omacharya1710/Model_Rocketry_Project_IIT_Tirupati/External_Components/Kill_Switch/Kill Switch.png

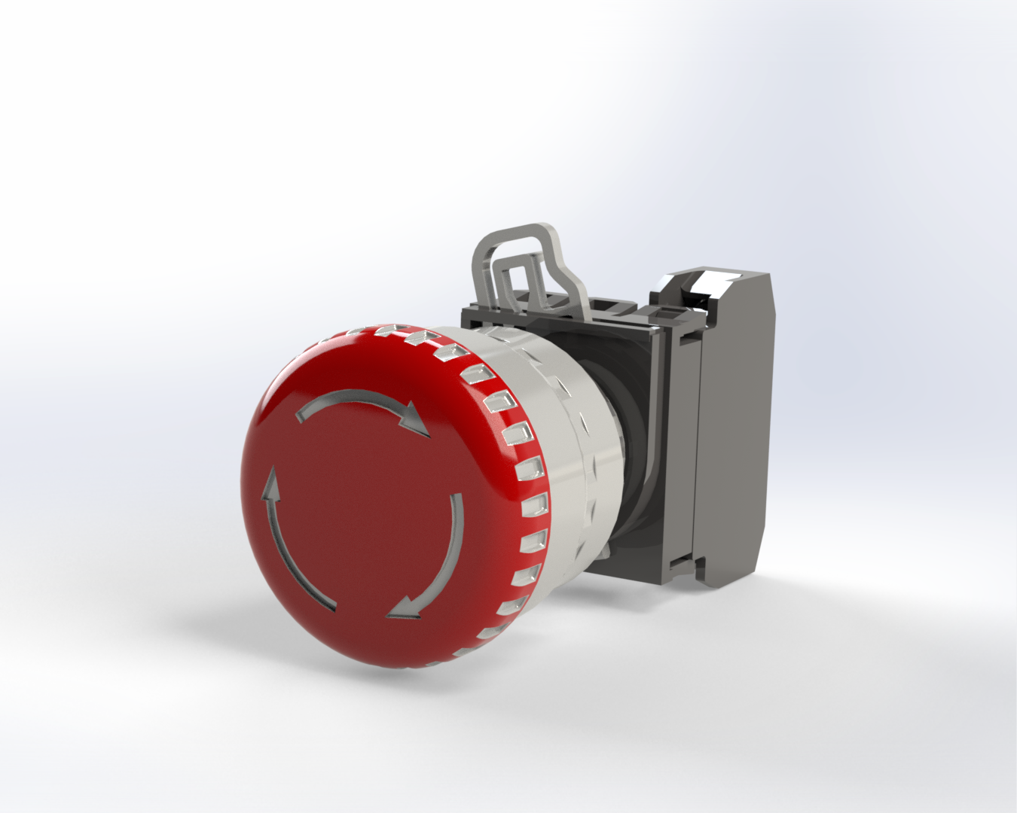
External_Components/Kill_Switch/Kill Switch.png
