omacharya1710/Model_Rocketry_Project_IIT_Tirupati/Photos/20250520_103055000_iOS.jpg

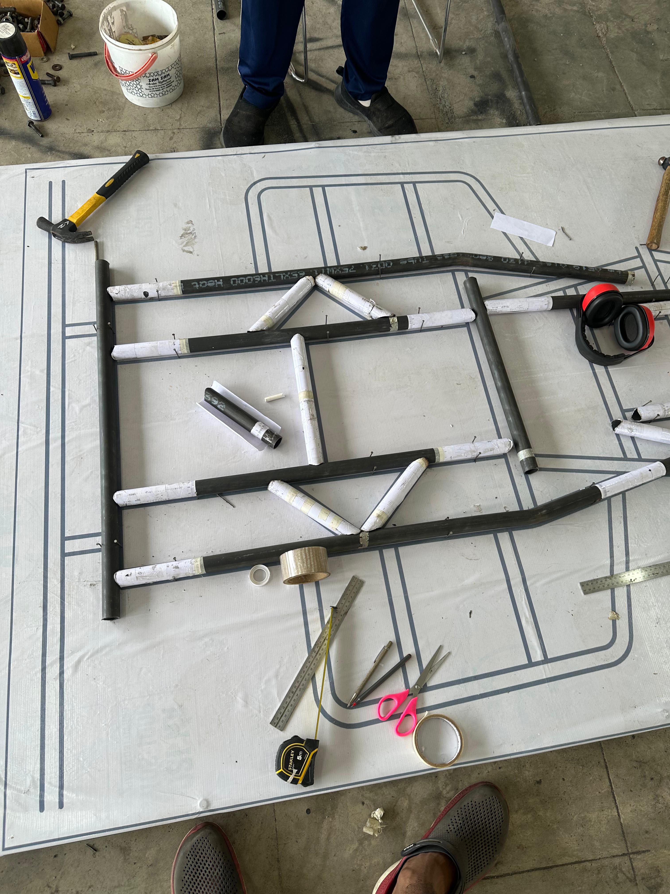
Photos/20250520_103055000_iOS.jpg
