omacharya1710/Model_Rocketry_Project_IIT_Tirupati/Reports/braking_report.pdf

# Braking System Design Report

I. RULEBOOK CONSTRAINTS
According to the IKR 2025 rulebook:
- Karts must have a hydraulic braking system.
- On applying brakes, all four wheels should lock up.
- The kart must safely stop after accelerating at least up to 25 km/h during the brake test.
- The tire specification to be followed is in the following table:
| Type | Category | Dimension
Dry (slick) tires Wet tires Dry (slick) tires Wet tires | Front Front Rear Rear | D1 W1 or W2 D1 W1 or W2 | 4.5×10.0-5 4.5×10.0-5 7.1×11.0-5 6.0×11.0-5

TABLE I: Tire specifications

II. FORCE CONSIDERATION
- Maximum foot force applied by driver: 250 N
- Pedal mechanical advantage: 5.5
Effective force transmitted to master cylinder:

FMC = Ffoot × MA = 250 × 5.5 = 1375 N

III. WORKING PRINCIPLE
The brake pedal, using a mechanical linkage, actuates the clutch master cylinder:
The rear braking circuit operates one caliper on the rear axle.
When the pedal is pressed, hydraulic pressure develops inside master cylinder actuates the caliper piston, pressing the brake pads against the rotating discs to generate braking torque.

IV. DESIGN CONSIDERATIONS
Key aspects considered during design:
- Sufficient hydraulic pressure generation within safe limits.
- Adequate braking torque to decelerate from 40 km/h.
- Avoidance of component failure under maximum force.
V. COMPONENT SELECTION

TABLE II: Selected Components and Specifications

Component | Specification
Master Cylinder | 21.9 mm Bore (x1 units)
Rear Caliper | 32 mm Bore (x1 unit)
Rear Brake Disc | 130 mm ID, 200 mm OD
Rear Tyre Diameter | 279.4 mm
Rear Brake Pad Area | 1800 mm²
Pedal Mechanical Advantage | 5.5

VI. PICTURES OF DESIGN AND COMPONENTS

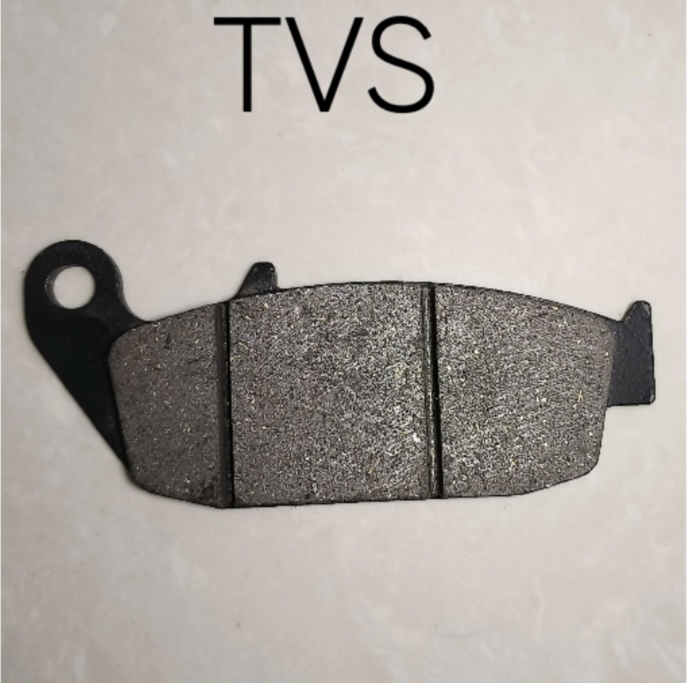
[picture p3: figure]

Fig. 1: Images of Brake pad

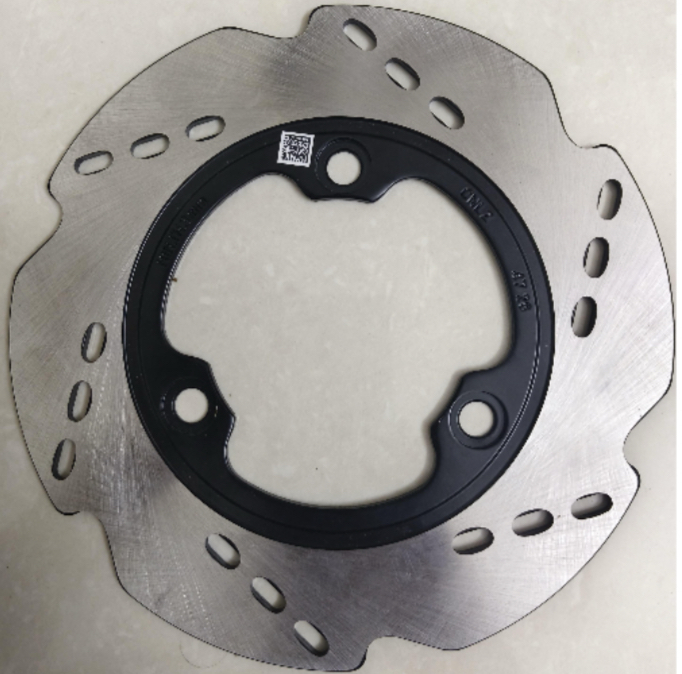
[picture p4: figure]

Fig. 2: Images of Brake disc

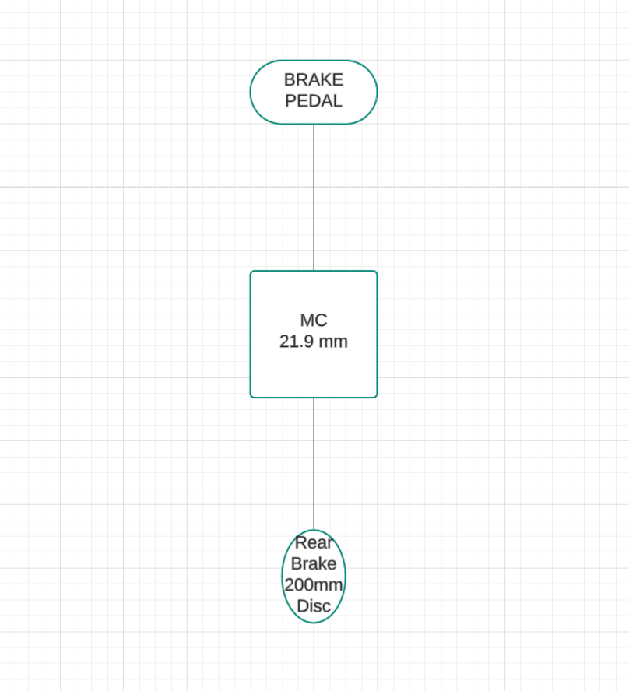
[picture p5: figure]

Fig. 3: FLOW CHART

VII. PART ANALYSIS
Currently, no finite element analysis (FEA) is conducted on brake discs or pedal arms. Static load analysis and thermal analysis are planned in future work.

VIII. FORMULATION AND CALCULATIONS
A. Master Cylinder Area
Bore diameter of master cylinder, DMC = 21.9 mm = 0.0219 m
Radius:

rMC =

DMC
2

= 0.01095 m

Area:
AMC = πr²

MC = π(0.01095)² = 3.769 × 10⁻⁴ m²

B. Hydraulic Pressure
Effective force on master cylinder:

FMC = 1375 N

Hydraulic Pressure generated:

P =

FMC
AMC

=

1375
3.769 × 10⁻⁴
= 3.65 × 10⁶ Pa = 3.65 MPa
C. Caliper Piston Forces
Rear Caliper (Bore 32 mm):
Radius:

rRear−Caliper = 16 mm = 0.016 m

Area:
ARear−Caliper = π(0.016)² = 8.042 × 10⁻⁴ m²

Force:
FRear−Caliper = 3.65×10⁶×8.042×10⁻⁴ = 2935.3 N
D. Braking Torque Generation Disc effective radii:
Rear Disc:

rdisc−rear =

130 + 200
4

= 82.5 mm = 0.0825 m

Frictional Force between pad and disc: Coefficient of friction µpad−disc = 0.35
Rear:

FF riction−Rear = 0.35 × 2935.3 = 1027.36 N

Braking Torque:
Rear Torque (each wheel):

TRear = FF riction−Rear×rdisc−rear = 1027.36×0.0825 = 84.75 Nm

E. Total Braking Force
Front wheel radius = 0.127 m Rear wheel radius =
0.1397 m
Force at tyre contact patch:
Rear:

FRear−T yre =

84.75
0.1397

= 606.7 N

Total Braking Force:

FT otal−Braking = FRear−T yre = 606.7 N

F. Stopping Distance and Time Calculation Initial Speed:

v = 40 km/h = 11.11 m/s

Mass of kart:
m = 180 kg

Deceleration:

a =

FT otal−Braking
m

=

606.7
180

= 3.3705 m/s²

Braking time:

tbraking =

v
a

=

11.11
3.3705

= 3.296 s

Braking distance:

dbraking =

v

2
2a

=

(11.11)²
2 × 3.3705

= 18.31 m

G. Stopping Distance During Reaction Time
Here, we calculate the distance traveled during the driver’s reaction time, considering deceleration due to tyre-road friction.

d = v × t +

1
2

at²

Where:
- v = 11.11 m/s is the initial velocity.
- t = 0.5 s is the reaction time.
- a = −µ × g = −0.7 × 9.81 = −6.867 m/s² is
the deceleration, where µ = 0.7 is the coefficient of friction between tyre and road.
Substituting the values:

d = 11.11 × 0.5 +

1
2

× (−6.867) × (0.5)²

Simplifying:

d = 5.555 − 0.858 = 4.697 meters

Thus, the distance traveled during the reaction time is approximately 4.70 meters. Total stopping distance:

dtotal = dbraking+dreaction = 18.31+4.697 = 23.007 m

IX. TABULATIONS

TABLE III: Braking Parameters Summary

Parameter | Value
Stopping Distance | 23.007 meters
Stopping Time | 3.796 seconds
Driver Foot Force | 250 N
Force at Master Cylinder | 1375 N
Hydraulic Pressure | 3.65 MPa
Total Braking Force | 606.7 N
X. RESULTS
- Total Stopping Distance: 23.007 meters
- Total Stopping Time: 3.796 seconds (including reaction time)
- Hydraulic pressure generated: 3.65 MPa
- Driver effort required: 250 N
- The above calculations were also done for wet conditions, and considering wet tires, the results are tabulated in Table IV.

TABLE IV: Results for Wet Conditions

Parameter | Value
Initial Velocity | 11.11 m/s (40 km/h)
Coefficient of Friction (Wet) | 0.3
Deceleration | 2.943 m/s²
Reaction Time | 0.5 seconds
Reaction Distance | 4.697 meters
Braking Time | 3.77 seconds
Braking Distance | 20.97 meters
Total Stopping Time | 4.27 seconds
Total Stopping Distance | 25.667 meters

XI. RESULTS
The braking system meets the safety requirements even under a worst-case scenario of braking from 40 km/h. Hydraulic pressures and forces are within component limits. Stopping distance and stopping time are within safe ranges, ensuring reliability of the system.
