omacharya1710/Model_Rocketry_Project_IIT_Tirupati/Reports/cover_page.pdf

# Go-Kart Design Report

Abstract—This document presents a comprehensive design and analysis of a go-kart, encompassing the chassis, steering, braking, transmission, and electrical wiring systems. The chassis was developed with strict adherence to competition rulebook constraints and dimensional standards, ensuring compliance while maximizing structural performance. Material selection focused on achieving an optimal balance between strength, weight, and cost, supported by iterative finite element analysis (FEA) simulations to validate the chassis’ structural integrity under dynamic loading conditions. The steering system design prioritizes precise handling, cornering stability, and safety, achieved through the implementation of an Ackermann steering geometry that minimizes tire scrubbing and reduces steering effort. Emphasis was placed on promoting self-centering behavior, improving maneuverability, and selecting simple yet robust materials to ensure reliability and cost-effectiveness. The braking system features a custom-designed hydraulic configuration utilizing two independent clutch master cylinders linked to a single pedal, providing mechanical advantage and redundancy. Although standard brake testing is performed from 25 km/h as per Indian Karting Race (IKR) regulations, a more conservative scenario at 40 km/h was analyzed to ensure enhanced safety margins. Detailed calculations for hydraulic pressures, braking forces, torque requirements, stopping distances, and pedal efforts were conducted to validate performance. The transmission system, comprising a chaindriven mechanism from the engine output shaft to the rear axle, was optimized for torque delivery and efficiency, with gear ratio selection aimed at achieving the desired balance between acceleration and top speed. This paper presents the design and implementation of a minimal yet competition-compliant electrical wiring system for a student-built go-kart. The setup includes essential safety and operational features such as Brake Over-Travel Switch (BOTS), multiple kill switches, and an adaptive brake lighting system. Furthermore, an innovative pneumatic gear shifting mechanism controlled by a Raspberry Pi is integrated, offering multiple shifting modes including manual handle shifting, paddle shifting with and without clutch, and automatic speed-based shifting. The report outlines the rulebook constraints, design considerations, circuit diagram, power calculations, and results.
Index Terms—Go-Kart, Chassis Design, Braking System, Transmission, Steering, Electrical Wiring, Lightweight Vehicles, Systems Engineering
I. INTRODUCTION

This document presents a comprehensive design and analysis of a go-kart, encompassing the chassis, steering, braking, transmission, and electrical wiring systems.
The transmission system is a critical component responsible for transferring power from the engine to the rear wheels while enabling variation in torque and speed to match different driving conditions. A

5-speed constant mesh manual transmission from the TVS Apache RTR 160 2V motorcycle was integrated into the go-kart due to its compact design, proven reliability, and smooth gear transitions. Its inclusion ensures improved vehicle control, efficient power delivery, and optimal performance under dynamic racing conditions.
The steering system plays a crucial role in the maneuverability and handling of the go-kart, enabling precise navigation through tight corners and maintaining driver control. An Ackermann steering geometry was implemented to ensure that each wheel follows its ideal turning radius, minimizing tire scrubbing and enhancing cornering efficiency. The design also emphasizes self-centering behavior, reduced steering effort, and simplicity to maximize reliability and ease of maintenance.
The braking system is critical for the dynamic performance and safety of the kart. Although the Indian Karting Race (IKR) rulebook requires braking from 25 km/h, a more conservative design approach was adopted by analyzing braking forces and stopping distance from 40 km/h to ensure higher safety margins. A dual hydraulic circuit system with mechanical pedal linkage was used, providing redundancy and efficient deceleration under various conditions.
The chassis serves as the fundamental structural framework of the go-kart, bearing all system loads and providing protection to the driver. Designed in compliance with rulebook constraints regarding dimensions, roll hoop requirements, and bumper design, the chassis was iteratively refined using finite element analysis (FEA) simulations under front, rear, and side impact scenarios. Material selection focused on achieving an optimal balance between strength, weight, and cost, leading to the use of AISI 4130 steel for critical frame members.
Student motorsports competitions mandate strict compliance with safety and reliability standards. Electrical systems, although minimal in combustion engine go-karts, play a crucial role in ensuring driver safety and operational control. This report details the electrical wiring layout, accessories, and the integration of a Raspberry Pi-based pneumatic shifting system, developed to enhance shifting efficiency and vehicle performance for the innovation round.
The integration of all these subsystems was carried out with an emphasis on manufacturability, reliability, safety, and dynamic performance, resulting in a competitive and robust go-kart platform suitable for racing applications.
