omacharya1710/Model_Rocketry_Project_IIT_Tirupati/Reports/electrical_report.pdf

# Wiring Diagram and Accessories Design Report

I. RULEBOOK CONSTRAINTS

As per competition regulations:

- A Brake Over-Travel Switch (BOTS) must be installed on the brake pedal.
- Three Kill Switches are mandatory (one driver-accessible, two externally mounted).
- Brake light must remain ON (dim) when powered and become brighter when braking.
- Any additional system must not compromise safety standards.

II. DESIGN CONSIDERATIONS

The vehicle’s electrical architecture was kept minimal to reduce weight and complexity while meeting all required standards:

- BOTS installed directly on the brake pedal linkage.
- Kill switches wired in series to allow immediate engine shutdown.
- Brake light configured using a dual-intensity circuit.
- Pneumatic gear shifting operated using a 12V car air compressor and solenoid valves, managed via Raspberry Pi.
- Fail-safe mechanisms embedded for manual shifting in case of automatic system failure.

III. CIRCUIT DESIGN

The basic electrical circuit includes:

- 12V Battery as power source
- Series wiring of BOTS and Kill Switches
- Brake light dual intensity connection
- Relayed control of compressor and solenoids

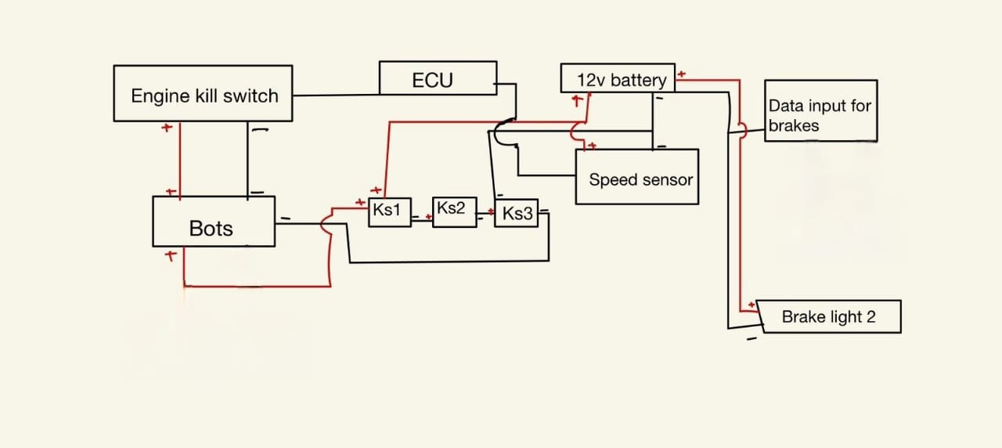
[picture p6: figure]

Fig. 1. Go-Kart Electrical Wiring Diagram

TABLE I
COMPONENTS USED
Component | Specification
Brake Light BOTS Kill Switches Display Wiring Harness | Dual Intensity LED Push Button NO Switch Mechanical Emergency Stops ECU Display Unit Automotive Grade

IV. COMPONENTS AND ASSEMBLY

V. SIMULATION
Since the system primarily involves hardware wiring and low-level electronics, no software simulation was conducted. Practical bench testing and continuity checks were performed to validate the circuit.

VI. RESULTS
- Brake Light: Functional dual intensity
- Kill Switches: Effective shutdown
- Pneumatic Shifting: Working via Raspberry Pi

VII. CONCLUSION
The developed electrical system fulfills all regulatory requirements while incorporating innovative features for enhanced driver experience. The pneumatic shifting system controlled by Raspberry Pi adds to vehicle control and responsiveness, making the kart suitable for advanced competition rounds while maintaining high safety standards.
