omacharya1710/Model_Rocketry_Project_IIT_Tirupati/Reports/references.pdf

# References

REFERENCES
1) Design of Subsystems of Go-Kart Vehicle, ResearchGate (https://www.researchgate.net/publication/322750106_Design_of_subsystems_of_Go-kart_vehicle)
2) Fundamentals of Vehicle Dynamics, Thomas D. Gillespie (https://www.amazon.com/Fundamentals-Vehicle-Dynamics-Thomas-Gillespie/dp/1560911999)
3) Design and Analysis of Go-Kart Chassis Frame, JETIR (https://www.jetir.org/papers/JETIR18IC052.pdf)
4) Design and Development of Go-Kart Chassis, IJIRT (https://ijirt.org/publishedpaper/IJIRT148120_PAPER.pdf)
5) Design and Development of a Go-Kart Frame, IOP Conference Series (https://iopscience.iop.org/article/10.1088/1757-899X/981/4/042026)
6) Design and Fabrication of Transmission System for Go-Kart, IJSTE (https://ijste.org/Article.php?manuscript=IJSTEV4I8027)
7) Design of Transmission System for Go-Kart Vehicle, ResearchGate (https://www.researchgate.net/publication/334317267_Design_of_Transmission_System_for_Go-Kart_Vehicle)
8) Design and Analysis of a Go-Kart Chassis Frame, ScienceDirect, Procedia Manufacturing (https://www.sciencedirect.com/science/article/pii/S2214785320349695)
9) AISI 4130 Alloy Steel (UNS G41300) Material Properties, AZoM (https://www.azom.com/article.aspx?ArticleID=6742)
10) Design of Go-Kart Chassis, International Journal of Automotive and Mechanical Engineering (https://www.ijamejournals.com/pdf/rps161152.pdf)
11) Dynamic Analysis and Optimization of a Go-Kart Chassis Frame, ScienceDirect, Procedia Manufacturing (https://www.sciencedirect.com/science/article/pii/S2214785320360867)
12) Apache RTR 160 2V Owner’s Manual, TVS Motor Company (https://www.tvsmotor.com/-/media/Feature/Owners/User-Manual-11-Apr-22/TVS-Apache-RTR-160-2V.pdf)
13) Go-Kart Chassis Design and Analysis, IJRITCC (https://ijritcc.org/download/conferences/ICEMTE_2017/Track_3_(MECH)/1488271356_28-02-2017.pdf)
14) Go-Kart Steering and Suspension System Design, IJSRD (https://www.ijsrd.com/articles/IJSRDV7I40960.pdf)
15) Self Aligning Torque Formula, FormulaDen (https://www.formuladen.com/en/self-aligning-moment-or-torque-on-wheels-formula/Formula-36979)
16) Steering Ratio, Wikipedia (https://en.wikipedia.org/wiki/Steering_ratio)
17) Go-Kart Front Wheel Alignment Guide, Kart-Class (https://kartclass.com/blogs/news/a-step-by-step-guide-on-go-kart-front-alignment)
18) Vehicle Dynamics: Theory and Application, eBook (https://ftp.idu.ac.id/wp-content/uploads/ebook/tdg/TERRAMECHANICS%20AND%20MOBILITY/epdf.pub_vehicle-dynamics-theory-and-application.pdf)
19) PSG Design Data Book, Standard Handbook for Mechanical Design (offline source)
20) Raspberry Pi 4 Model B Datasheet
21) Basic Automotive Electrical Standards (ISO 16750)
