omacharya1710/Model_Rocketry_Project_IIT_Tirupati/Reports/steering_reports.pdf

# Steering System Design Report

I. RULEBOOK CONSTRAINTS
- Mechanical steering mechanism.
- All parts are metallic, except for the wheel.
- Steering angle constrained to the degree of rotation 30◦
- The steering wheel must be circular or elliptical, with a diameter between 8 and 10 inches.
- The rack and pinion system must not be used.

II. STEERING GEOMETRY

- The steering system is designed on the basis of the Ackermann steering principle to optimize wheel alignment during turns.
- The inner and outer wheels rotate at different angles, reducing tire scrubbing and improving maneuverability.
- The setup ensures smooth and predictable handling, providing better traction, and minimizing lateral forces on the tires.
- Specific steering angles are incorporated to enhance self-centering behavior and driver control.
- The kingpin inclination and caster angles are selected to balance the steering effort, stability, and responsiveness.
- The camber and toe settings are kept neutral to maximize tire contact and ensure consistent straight-line performance.
- The overall steering geometry provides stable behavior during both cornering and straight-line motion.

III. DESIGN CONSIDERATIONS

- Steering Mechanism and Steering Effort: A four-bar linkage Ackermann steering geometry is used to ensure both front wheels turn at appropriate angles, minimizing tire slip and improving handling. Steering effort is minimized through optimized geometry, direct steering setup, and selection of kingpin and caster angles, ensuring quick response and self-centering behavior.
- Turning Radius: A turning radius of 2.6 meters was targeted to enable efficient navigation on tight racing circuits and practice tracks.
- Space Management, Ergonomics, and Safety: The steering system layout was developed to fit within the compact chassis while avoiding interference with structural elements and pedals. The steering wheel and column were positioned for driver comfort and natural posture. Mechanical simplicity and robust construction, with proper welding and bolting, enhance system reliability and driver safety.

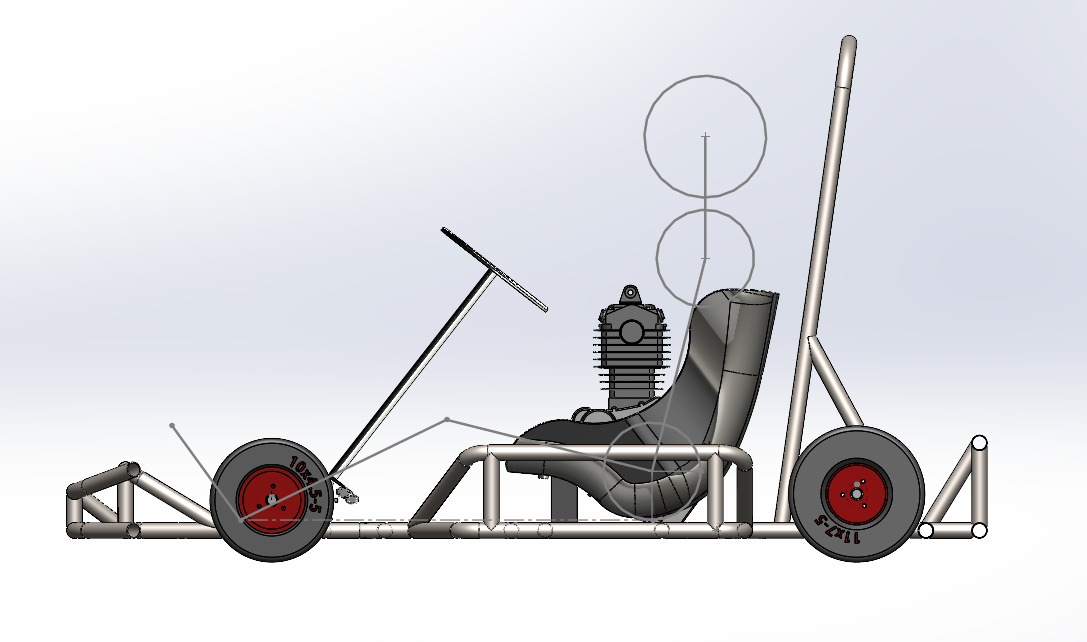
[picture p7: figure]

Fig. 1. Driver ergonomics and steering wheel positioning.

- Material Selection and Cost Optimization: Lightweight and strong materials like Aluminium 6061-T6 and SS-304 were selected to ensure structural integrity while minimizing weight. Standardized components were preferred to reduce manufacturing cost and simplify assembly and maintenance.
- Wheel Alignment and Steering Angles: Wheels are set parallel without toe-in or toe-out adjustments to ensure stable straight-line motion and predictable handling. A kingpin inclination of 10◦ and an adjustable caster angle were incorporated to decrease scrub radius, reduce steering effort, and promote self-aligning torque for returnability after cornering. The caster angle can be varied from -15◦

to 15◦
, allowing fine-tuning of steering response and handling characteristics based on driving conditions.

IV. WORKING PRINCIPLE

The go-kart’s steering system uses Ackermann steering geometry for efficient, precise cornering. The inner wheel turns sharper than the outer, allowing both to follow their circular paths with minimal tire scrubbing, reducing wear and improving handling. Steering input from the driver is transmitted through the steering column to a triangular plate, which moves tie rods connected to the steering arms. These rotate the spindles at different angles following the Ackermann principle. To enhance steering feel and control, the design incorporates kingpin inclination and caster angle, reducing steering effort and providing self-aligning torque for easier return to center. Instead of a rack and pinion system, which regulations prohibit, a four-bar linkage mechanism is used to achieve precise, independent wheel angles during cornering.

V. DIMENSION PARAMETERS

TABLE I
STEERING DIMENSION PARAMETERS
Parameter | Value
Wheelbase (L) | 1200 mm
Trackwidth Front (T) | 1100 mm
Distance Between Kingpins (T

′
) | 780 m
Weight Distribution (Rear:Front) | 60:40
CG Distance from Rear Axle | 480 mm
Stub Axle Length | 160 mm

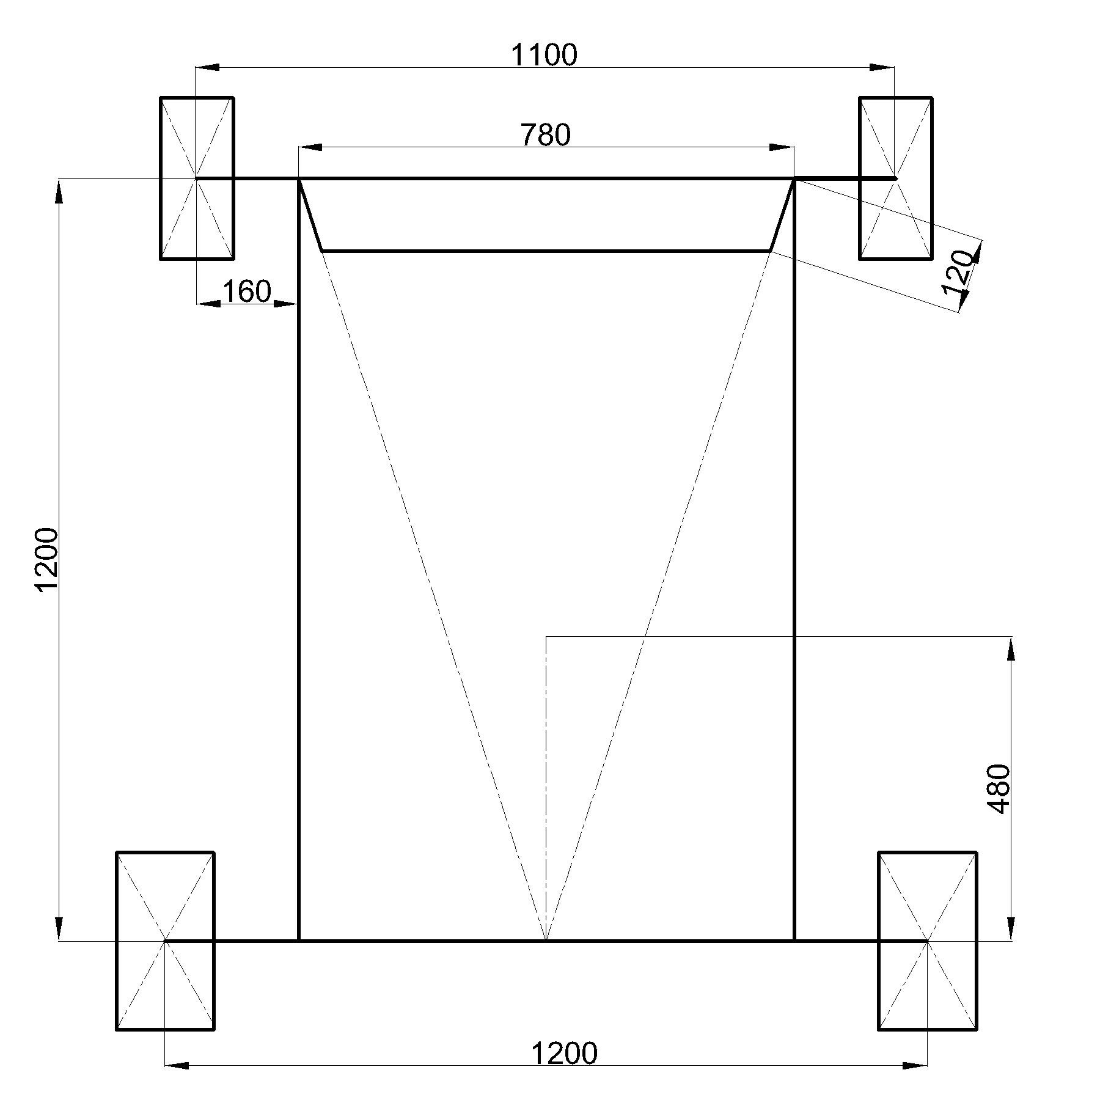
[picture p8: figure]

Fig. 2. Dimensions.

VI. FORMULATIONS AND CALCULATIONS

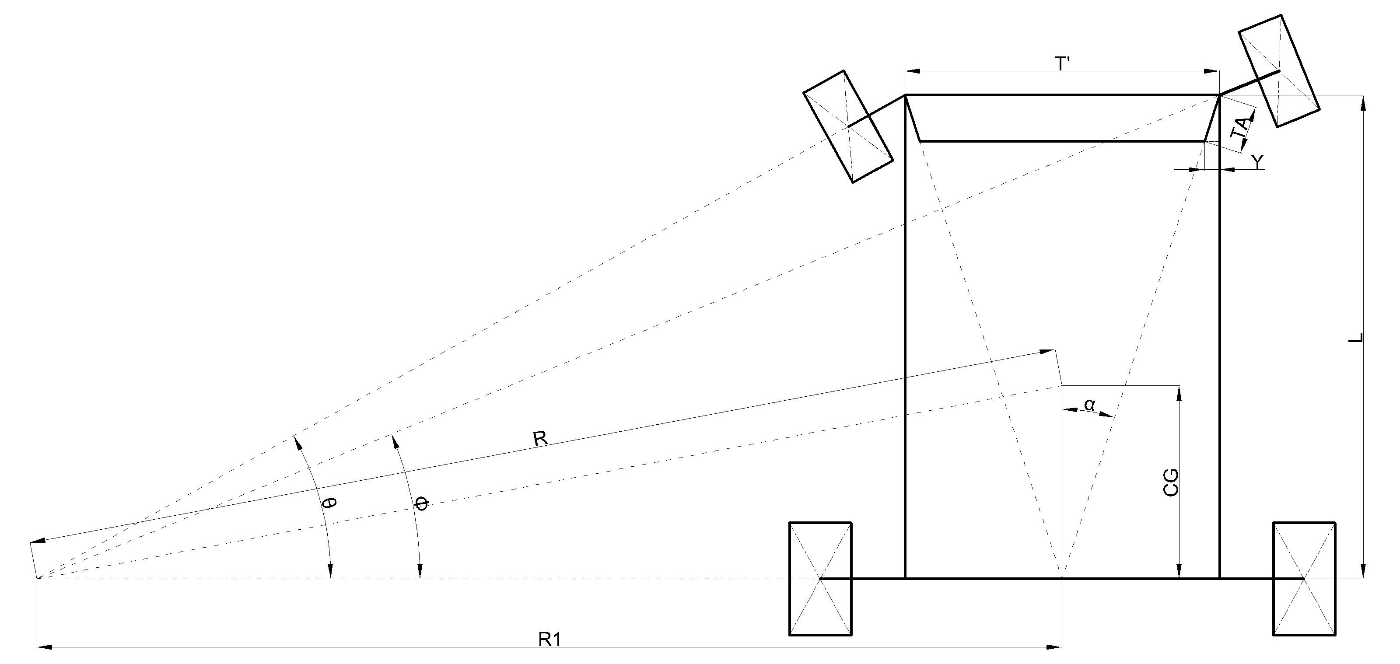
[picture p9: figure]

Fig. 3. Ackermann steering geometry

A. Steering Angles

cot ϕ − cot θ =

T

′
L

= 0.65

Given: T

′ = 780 mm, L = 1200 mm
Turning radius R = 2600 mm (assumed).

R =

q
CG² + R²
1 | ⇒ | R1 = 2555 mm

tan θ =

L
R1 − T′/2

⇒ θ = 28.99◦

tan ϕ =

L
R1 + T′/2

⇒ ϕ = 22.16◦

Ackermann angle:

Ackermann angle = tan⁻¹

sin ϕ − sin θ
cos ϕ + cos θ − 2
⇒ 28.35◦

Ackermann Percentage:

Ackermann % =

Ackermann angle
θ

× 100 = 97.8%

B. Tie Rod Length
Tie arm length assumed T A = 120 mm:

sin α =

Y
T A | ⇒ | Y = 57 mm

Length of tie rod:

Length =

T

′
2

− Y = 333 mm

C. Steering Forces
Total mass m = 180 kg.
Normal force on front tire:

N = 72 × 9.81 = 706.32 N

Lateral force:

Flateral =

mv²
r

= 3987.69 N

Tractive force:

Ftractive = µ × N = 494.43 N (µ = 0.7)

Scrub radius:

Scrub Radius = 160 − tan(10◦ ) × 254 = 115.21 mm

Steering ratio:

Steering ratio =

Steering Wheel Angle
Average Tire Angle

=

50

28.99+22.26
2

= 1.95

VII. ANALYSIS OF DIFFERENT COMPONENTS

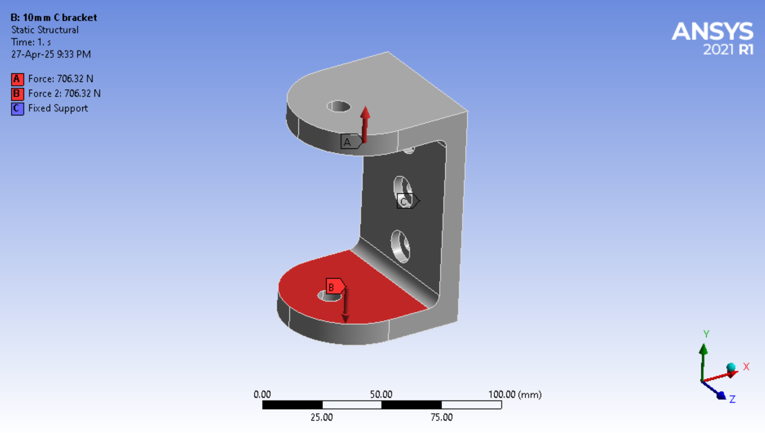
[picture p10: figure]

Fig. 4. Force and support positions of C Bracket

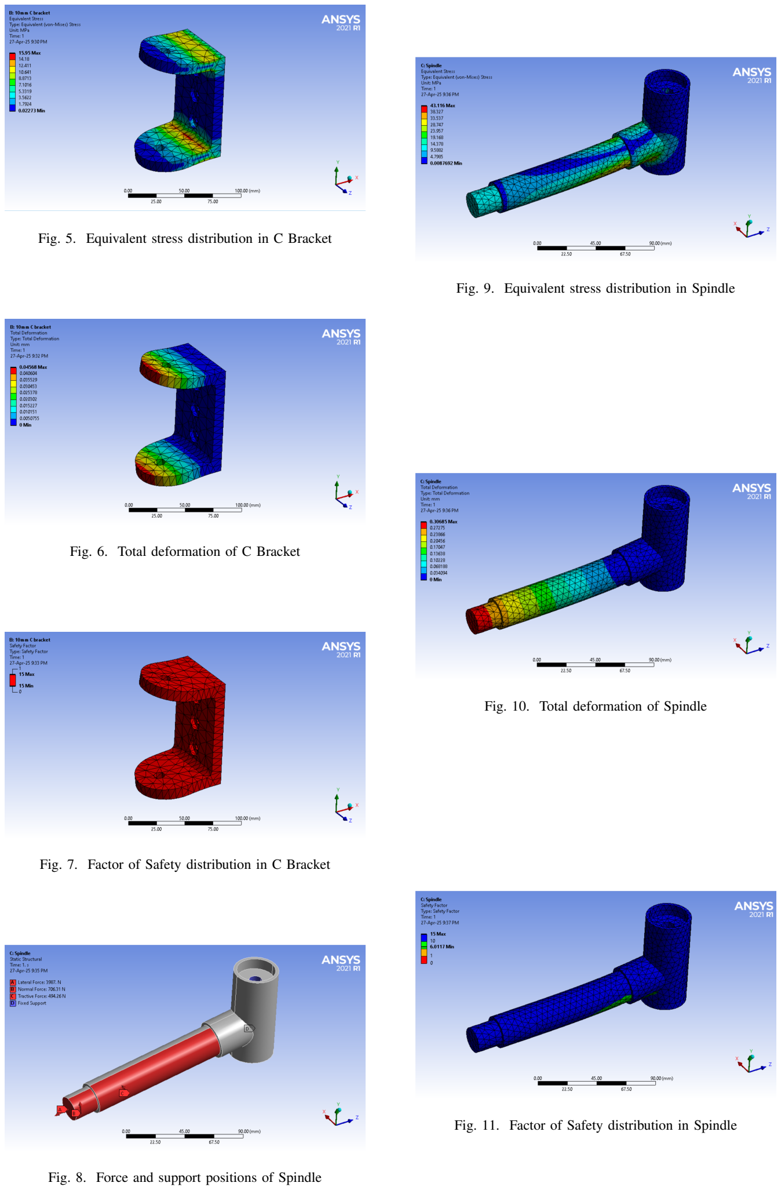
[picture p11: page 3]

Fig. 5. Equivalent stress distribution in C Bracket

Fig. 6. Total deformation of C Bracket

Fig. 7. Factor of Safety distribution in C Bracket

Fig. 8. Force and support positions of Spindle

Fig. 9. Equivalent stress distribution in Spindle

Fig. 10. Total deformation of Spindle

Fig. 11. Factor of Safety distribution in Spindle
