omacharya1710/Model_Rocketry_Project_IIT_Tirupati/Reports/transmission_report.pdf

# Transmission System Design Report

I. RULEBOOK CONSTRAINTS
A. Transmission Constraints

As Per the Indian Karting Race (IKR) 2025 rulebook, these constraints apply:
- The drivetrain must be of rear-wheel drive configuration only.
- Teams are allowed to utilize chain and sprocket, and gearbox mechanisms.
- There is no restriction on sprocket ratios.
- The transmission system can include a direct axle.
- The entire transmission assembly must be securely mounted.
- A proper shielding is required to cover the moving parts of the transmission.
B. Engine Constraints
- Only single-cylinder, four-stroke engines are permitted.
- Engines may be air-cooled.
- The maximum allowable engine displacement is 165cc.
- The fuel type is limited to petrol.
- Engine tuning should not violate any performance limiters.
- Teams are not allowed to alter the standardized governor setting after inspection.
- Each team must produce a valid purchase bill and recent servicing proof.
- Reuse of the same engine is allowed for up to two consecutive events.

II. FORCE CONSIDERATION

In designing the transmission system, several forces must be considered:

A. Force Produced by the Engine

Power (kW) can be calculated as:

P =

T · ω
1000

where T is torque (Nm) and ω is angular velocity (rad/s).

B. Rolling Friction

Rolling resistance is:

Frf = µrfMg

where µrf is the coefficient of rolling resistance.

C. Air Drag

Air drag force:

Fair drag =

1
2

ρCdAv²

where Cd is drag coefficient, A is frontal area, ρ is air density, and v is velocity.

D. Effective Force

Feffective = Fengine − Frolling friction − Fair drag

III. WORKING PRINCIPLE

The go-kart’s transmission system transfers the engine’s torque to the rear wheels through a chain and sprocket. The sequence is:

Engine output shaft → Driver sprocket → Chain → Driven sprocket → Rear axle → Wheels

IV. DESIGN CONSTRAINTS

The driver sprocket is positioned close to the pillow block bearing to minimize bending stresses. A sprocket combination of 13 teeth (driver) and 44 teeth (driven) is used, with a gear ratio of approximately 3.38.

V. COMPONENT SELECTION
A. Engine

TVS RTR 160 2V engine: 13.85 Nm @ 7000 RPM and 16.04 PS (11.79 kW) at 8750 RPM.

B. Sprockets

13-tooth driver and 44-tooth driven sprocket. Sprocket ratio approximately 3.38:1.

C. Rear Axle

Fabricated from AISI 4140 steel for high strength and fatigue resistance.

D. Justification

Components were selected for optimal torque delivery, acceleration, top speed, and mechanical toughness.

E. Analysis of Components

The analysis of the rear shaft was performed considering various loads acting during acceleration, braking, and static conditions. The key forces and resulting torques are described below.

TABLE I: Axle Specifications

Property | Value
Length Diameter Material | 1200 mm 30 mm AISI 4140 Steel
1) Driving Torque: The primary torsional load during acceleration is applied at the sprocket mounting location.

Taxle = Tengine × GR × FDR × η

where:
- η = 0.88 (mechanical efficiency)
- FDR = 44
13 = 3.385 (Final Drive Ratio)
- First GR = 2.875 (Gearbox Ratio)
- Tengine = 13.85 Nm
Thus,

Taxle = 13.85 × 2.875 × 3.385 × 0.88
= 118.48 Nm (Anti-clockwise)

Applied at the sprocket position, 275 mm from the center.
2) Braking Torque: The braking system applies an opposing torque at the brake disc mounting location.

Braking Torque = 85 Nm (Clockwise)

Applied at 275 mm from the center.
3) Vertical Wheel Loads: Vertical forces are induced by the go-kart’s weight, mainly on the rear axle bearings.

Total Weight = 180 × 9.81 = 1765.8 N

Assuming 60% of the total weight acts on the rear shaft:

Force at each bearing =

0.60 × 1765.8
2
= 556.227 N ≈ 560 N

Applied downward at bearing locations, 330 mm away from the center.

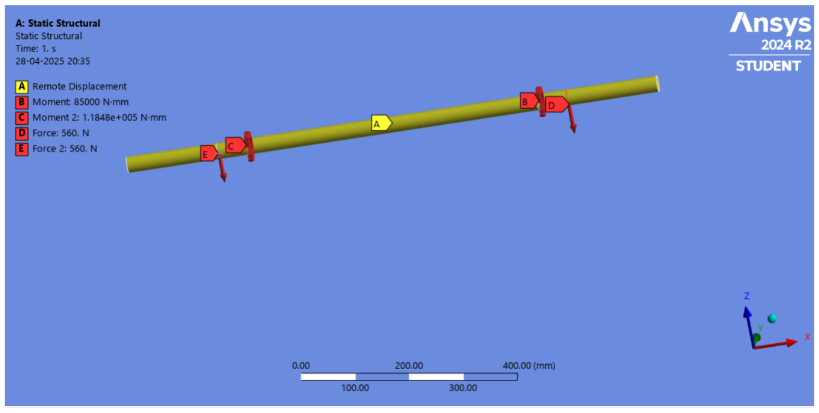
[picture p12: figure]

Fig. 1: Rear Shaft Force Conditions

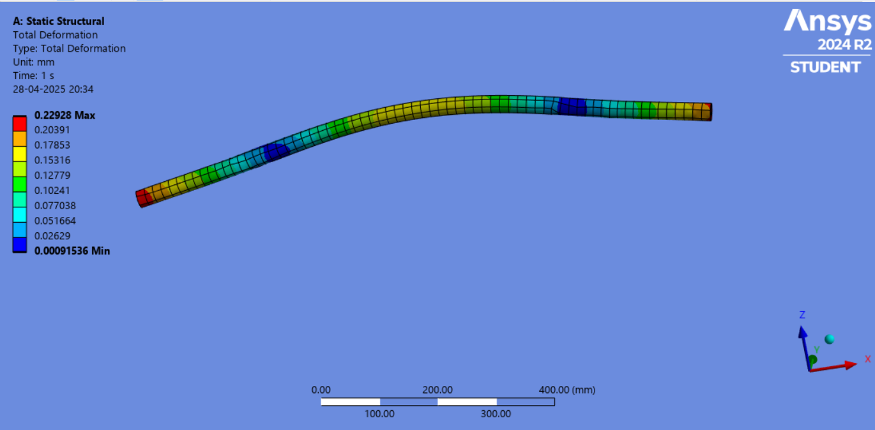
[picture p13: figure]

Fig. 2: Rear Shaft Total Deformation

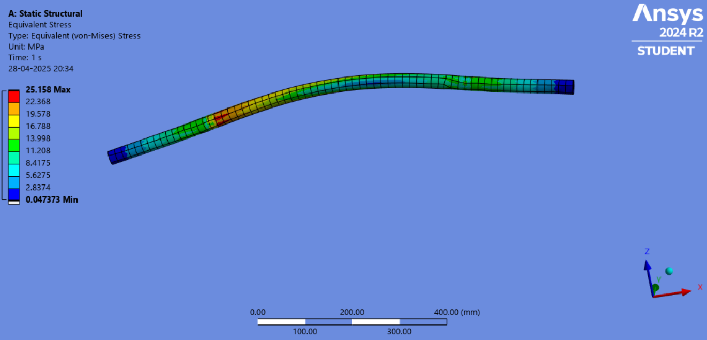
[picture p14: figure]

Fig. 3: Rear Shaft Equivalent Stress

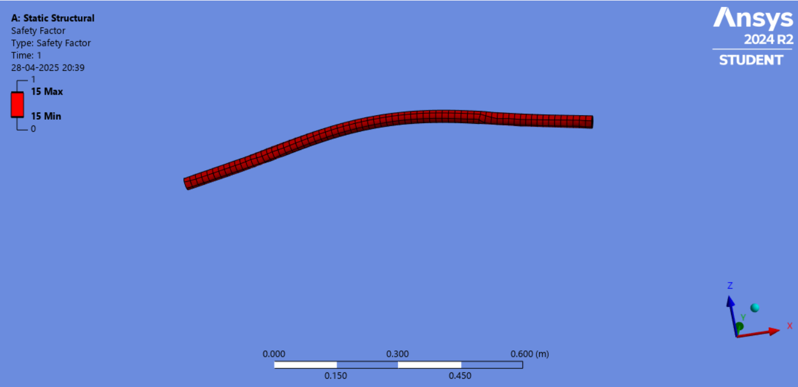
[picture p15: figure]

Fig. 4: Rear Shaft Factor of Safety

From the analysis it can be concluded that the selected dimensions of the shaft sufficiently meet the requirements of the setup and can perform under stress

VI. FORMULATION AND CALCULATION

A. Equations
- Final output power:

PF = Pmax · ηt

- Torque by Engine:

TE =

Pmax · 60
2πNmax
- Torque to wheels:

Twi = TE · Gi

- GE−S · ηt
- Force by engine:

Fengine(i) =

Twi
rw
- Air drag force:

Fair drag(i) =

1
2

ρCdAv²
i

- Rolling friction:

Frolling friction = µrfMg

- Effective force:

Feffective(i) = Fengine(i) − Frolling friction − Fair drag(i)

- Average acceleration:

ai =

Feffective(i)
M
- Time from velocity U to V :

TU−V =

X vf i − vsi
ai

×

5
18
- Top speed ignoring air drag:

vtop ≤

r · 2π
60

·

Nmax
G5 · GE−S

·

18
5
- Top speed considering air drag:

vtop ≤

s
Fengine(5) − Frolling friction
1/2 ρCdA

(For air drag) Feffective = 0

B. Parameters
- Max Power: 11.797 kW
- Max RPM: 8750
- Transmission efficiency: 88%
- Mass: 180 kg
- Wheel Diameter: 10 in = 0.2794 m
- Gravity: 9.81 m/s²
- Rolling friction coefficient: 0.012
- Air drag coefficient: 0.6
- Air density: 1.2 kg/m³
- Frontal Area: 0.8 m²
C. Tables and Graphs

TABLE II: Gearbox Ratios and Operating Velocities

Gear | Ratio | Initial Vel | Final Vel | Average Vel
| | (km/h)
1 | 2.875 | 0.0 | 14.0 | 7.0
2 | 2.000 | 14.0 | 25.0 | 19.5
3 | 1.480 | 25.0 | 47.3 | 36.2
4 | 1.185 | 47.3 | 75.5 | 61.4
5 | 1.050 | 75.5 | 109.3 | 92.4

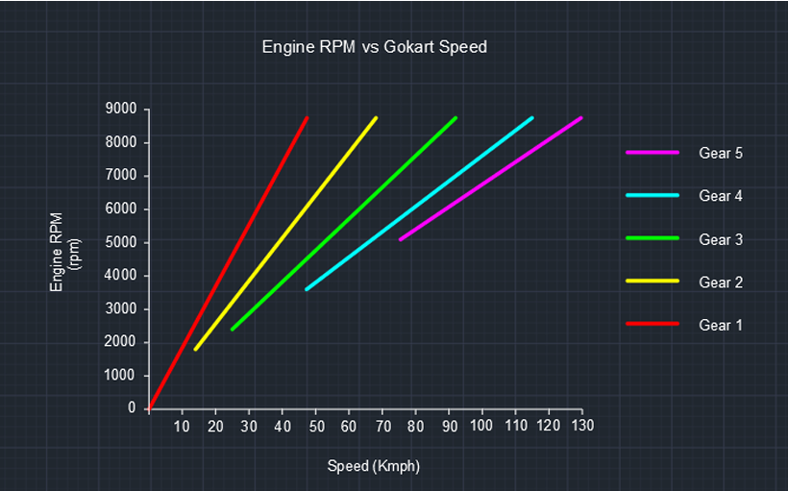
[picture p16: figure]

Fig. 5: Engine RPM vs Go-kart Speed across different gears.

TABLE III: Torques, Forces, and Accelerations

Gear | Torque (Nm) | Feng (N) | Fdrag (N) | Froll (N) | Feff (N) | Accel. (m/s² )
1 | 110.3 | 789.3 | 1.1 | 21.2 | 767.0 | 4.3
2 | 76.7 | 549.1 | 8.4 | 21.2 | 519.5 | 2.9
3 | 56.8 | 409.3 | 29.0 | 21.2 | 359.1 | 2.0
4 | 45.4 | 325.3 | 83.8 | 21.2 | 220.3 | 1.2
5 | 40.3 | 288.3 | 189.7 | 21.2 | 77.4 | 0.43

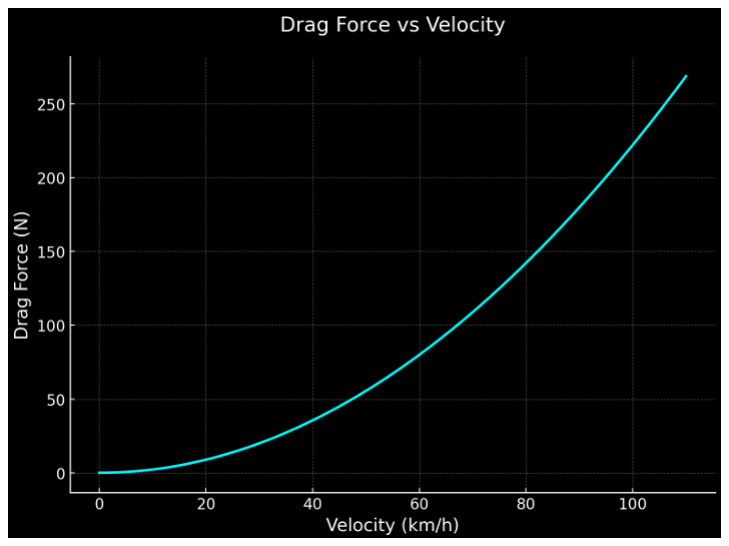
[picture p17: figure]

Fig. 6: Drag Force vs Velocity for the Go-kart.

VII. RESULTS
leftmargin=1.5em
- Final output power (Pp) = 10.381 kW
- Maximum torque of engine (Tmax) = 13.85 N·m @ 7000 RPM (Given)
- Torque outputs at the wheels:
– At 1st Gear – 110.3 N·m
– At 2nd Gear – 76.7 N·m
– At 3rd Gear – 56.8 N·m
– At 4th Gear – 45.4 N·m
– At 5th Gear – 40.3 N·m
- Average acceleration at each gear: – a1 = 4.3 m/s²
– a2 = 2.9 m/s²
– a3 = 2.0 m/s²
– a4 = 1.2 m/s²
– a5 = 0.43 m/s²
- Average initial acceleration (a0−40) = 3.52 m/s²
- Top speed (vtop) = 109.6 km/h
