omacharya1710/Model_Rocketry_Project_IIT_Tirupati/Photos/20250512_170708717_iOS.jpg

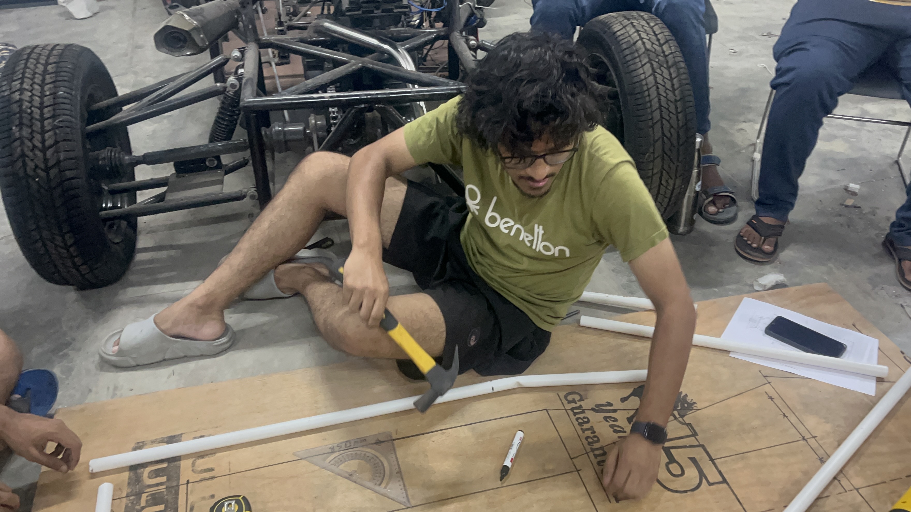
Photos/20250512_170708717_iOS.jpg
