omacharya1710/Model_Rocketry_Project_IIT_Tirupati/Photos/20250602_054929000_iOS.jpg

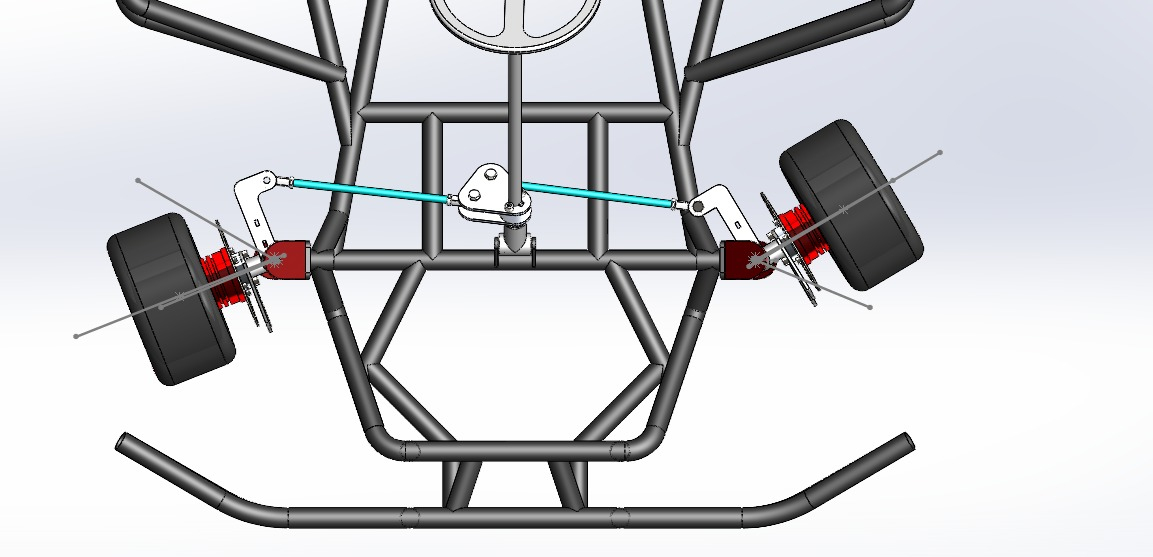
Photos/20250602_054929000_iOS.jpg
