omacharya1710/Model_Rocketry_Project_IIT_Tirupati/Photos/20250710_113839000_iOS.jpg

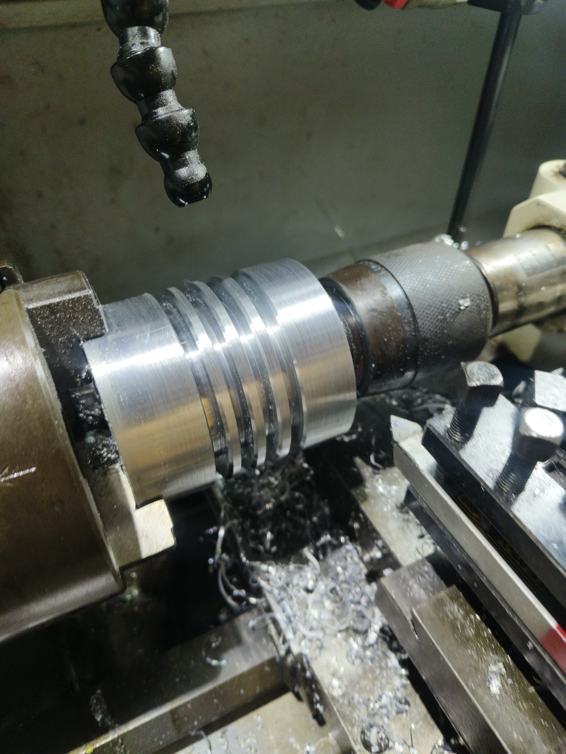
Photos/20250710_113839000_iOS.jpg
