omacharya1710/Model_Rocketry_Project_IIT_Tirupati/Photos/IMG_20251017_173755174.jpg

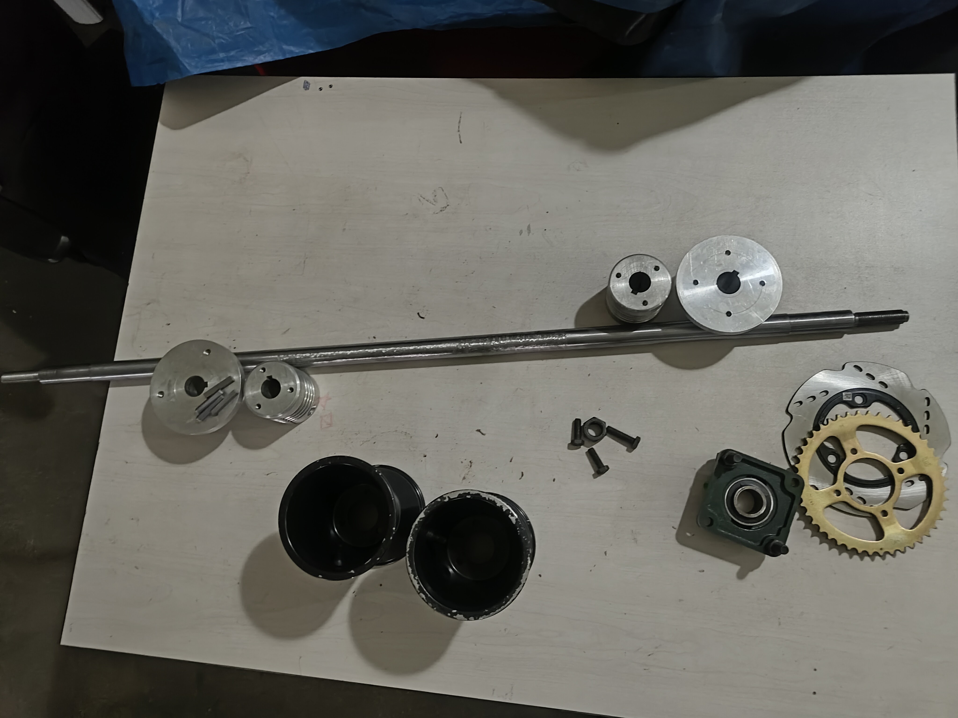
Photos/IMG_20251017_173755174.jpg
