omacharya1710/Model_Rocketry_Project_IIT_Tirupati/Ergonomic/Articulated_Dummy/Hand_R.SLDASM

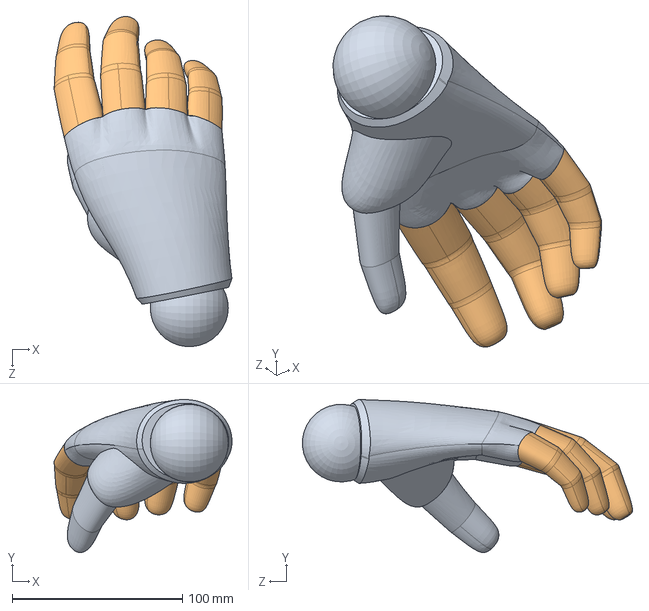
[picture p24: CAD file, 2026-03-10]
Ergonomic/Articulated_Dummy/Hand_R.SLDASM
104.4 x 89.8 x 193.7 mm
Hand_R
Fingers_R
