omacharya1710/Model_Rocketry_Project_IIT_Tirupati/Frame_BodyWorks/Hitch_Jack_Points/Hitch and Jack points.SLDASM

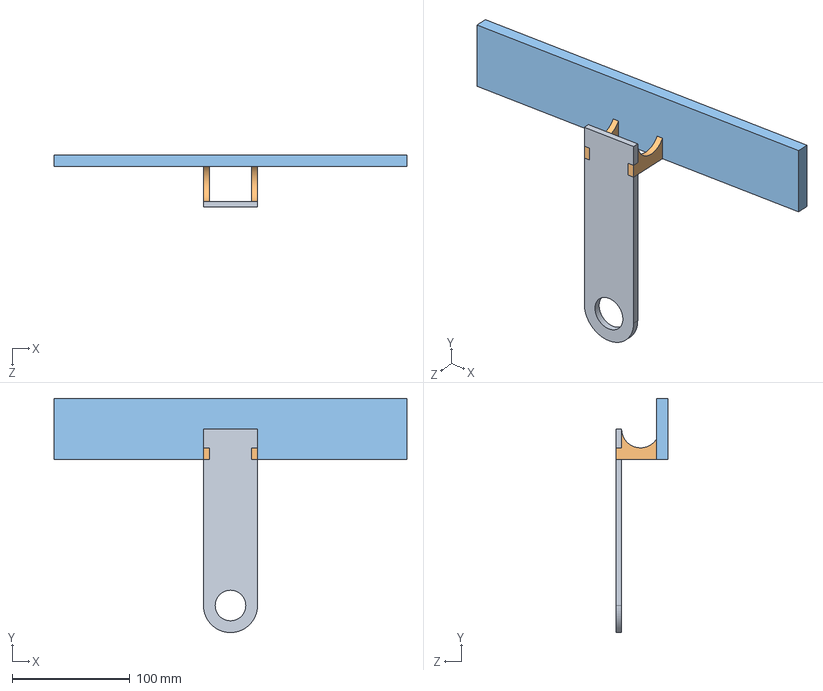
[picture p25: CAD file, 2026-03-10]
Frame_BodyWorks/Hitch_Jack_Points/Hitch and Jack points.SLDASM
300.0 x 199.0 x 44.5 mm
Jack Point
Conector x 2
Hitch point
