omacharya1710/Model_Rocketry_Project_IIT_Tirupati/Shaft_Hubs/Brake_Disc_Hub/Brake assembly.SLDASM

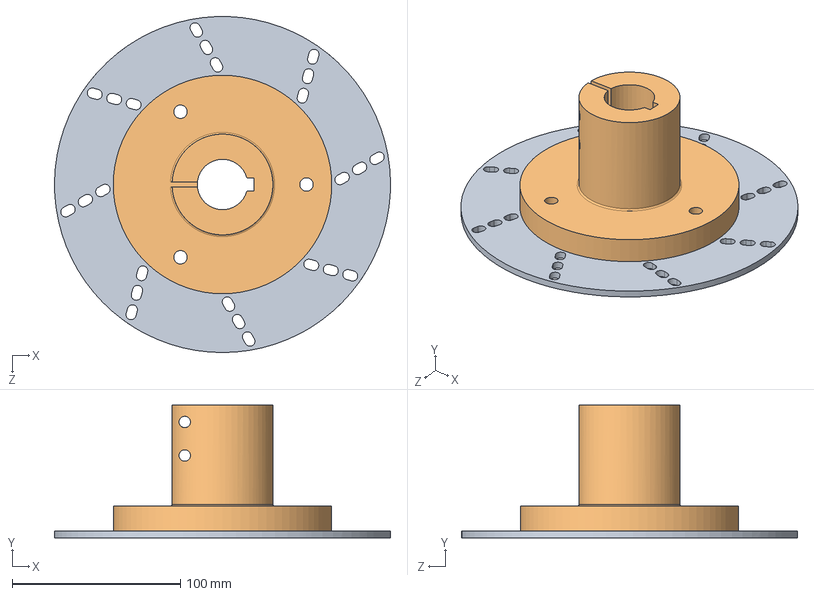
[picture p26: CAD file, 2026-03-10]
Shaft_Hubs/Brake_Disc_Hub/Brake assembly.SLDASM
200.0 x 79.0 x 200.0 mm
Rear Brake Hub
Rear Brake DIsc
