omacharya1710/Model_Rocketry_Project_IIT_Tirupati/Shaft_Hubs/Sprocket_Hub/Sprocket.SLDASM

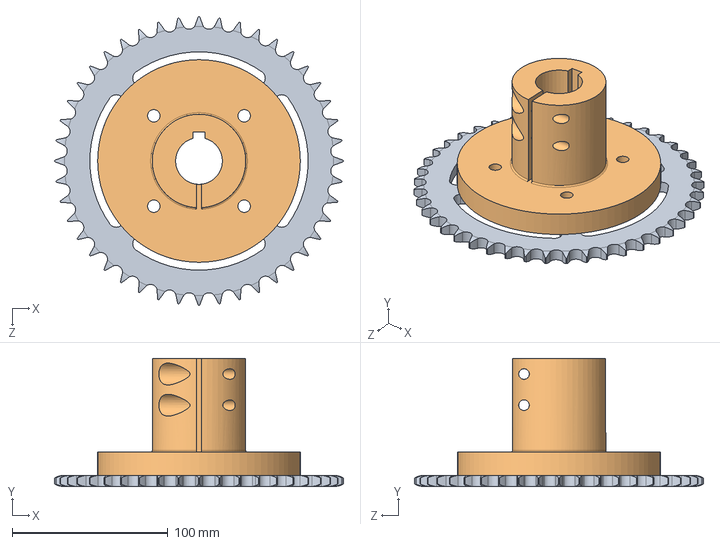
[picture p27: CAD file, 2026-03-10]
Shaft_Hubs/Sprocket_Hub/Sprocket.SLDASM
185.4 x 82.2 x 185.4 mm
Sprocket Hub
44T
