omacharya1710/Model_Rocketry_Project_IIT_Tirupati/Steering/Spindle_Assembly/Bearing_type/Spindle right.SLDASM

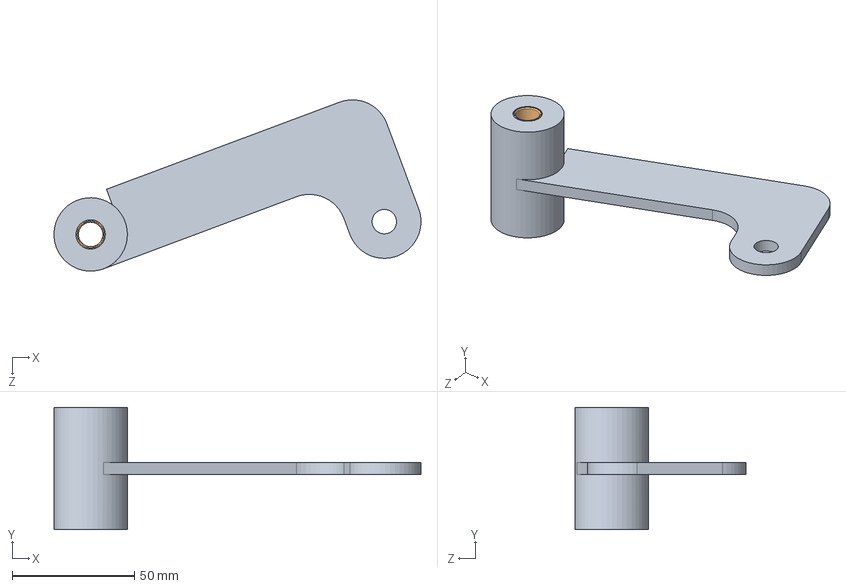
[picture p28: CAD file, 2026-03-10]
Steering/Spindle_Assembly/Bearing_type/Spindle right.SLDASM
149.8 x 50.0 x 69.9 mm
DU 1020 bushing x 2
Right spindle
