omacharya1710/Model_Rocketry_Project_IIT_Tirupati/Steering/Spindle_Assembly/Bearing_type/Spindle left.SLDASM

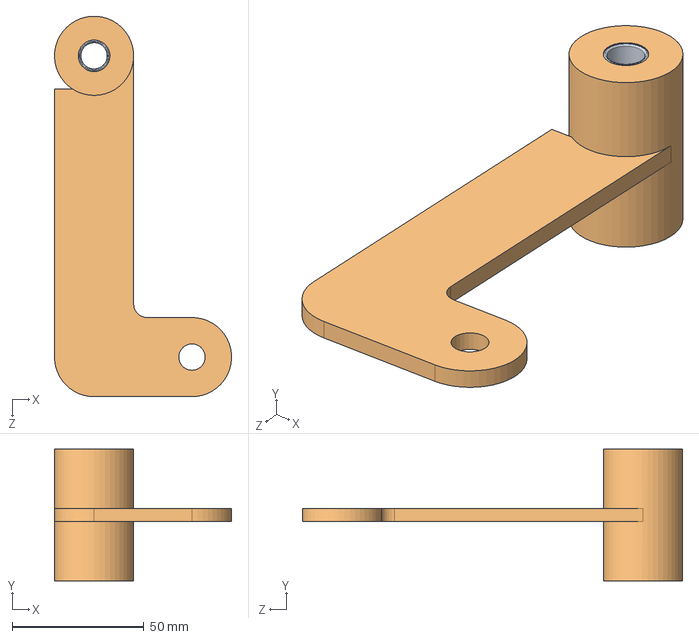
[picture p29: CAD file, 2026-03-10]
Steering/Spindle_Assembly/Bearing_type/Spindle left.SLDASM
67.0 x 50.0 x 144.1 mm
Left spindle
DU 1020 bushing x 2
