omacharya1710/Model_Rocketry_Project_IIT_Tirupati/Engine/Heat_Shield/Roll Hoop Heat Shield.SLDPRT

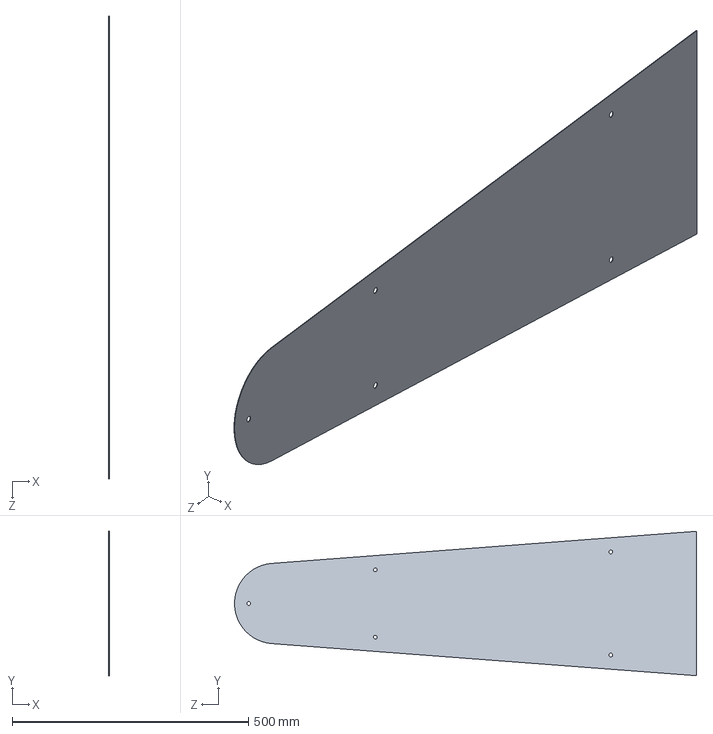
[picture p30: CAD file, 2026-03-10]
Engine/Heat_Shield/Roll Hoop Heat Shield.SLDPRT
1.00 x 305.8 x 978.1 mm
