omacharya1710/Model_Rocketry_Project_IIT_Tirupati/Ergonomic/Articulated_Dummy/UpperArm_L.SLDPRT

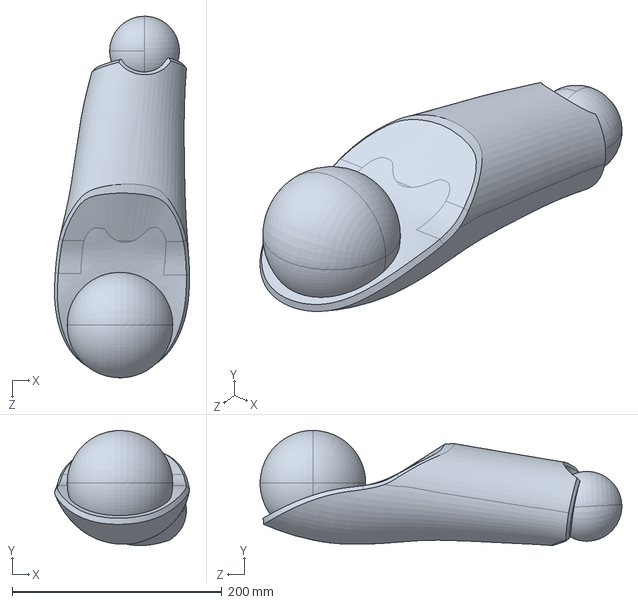
[picture p31: CAD file, 2026-03-10]
Ergonomic/Articulated_Dummy/UpperArm_L.SLDPRT
128.8 x 109.9 x 345.2 mm
