omacharya1710/Model_Rocketry_Project_IIT_Tirupati/Ergonomic/Seat.SLDPRT

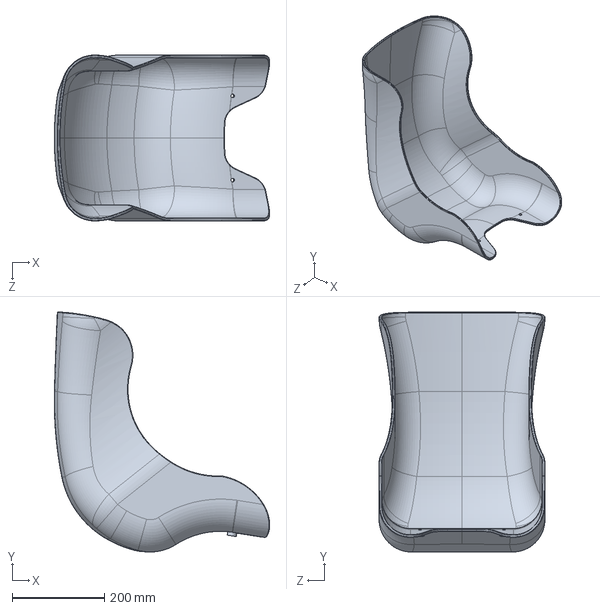
[picture p32: CAD file, 2026-03-10]
Ergonomic/Seat.SLDPRT
467.7 x 521.0 x 360.0 mm
