omacharya1710/Model_Rocketry_Project_IIT_Tirupati/External_Components/Kill_Switch/Shutdown Button.SLDPRT

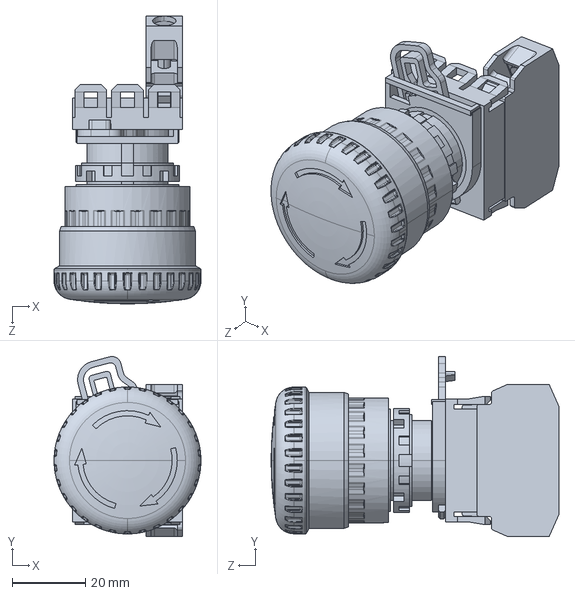
[picture p33: CAD file, 2026-03-10]
External_Components/Kill_Switch/Shutdown Button.SLDPRT
40.0 x 49.0 x 78.3 mm
