omacharya1710/Model_Rocketry_Project_IIT_Tirupati/Frame_BodyWorks/BodyWorks/Front Panel.SLDPRT

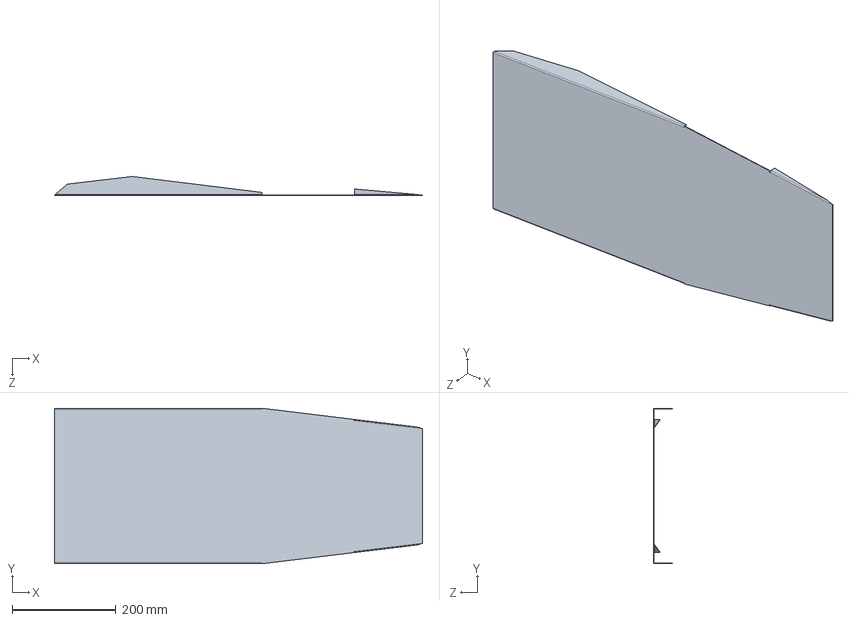
[picture p34: CAD file, 2026-03-10]
Frame_BodyWorks/BodyWorks/Front Panel.SLDPRT
710.0 x 300.0 x 36.7 mm
