omacharya1710/Model_Rocketry_Project_IIT_Tirupati/Frame_BodyWorks/Hitch_Jack_Points/Hitch point.SLDPRT

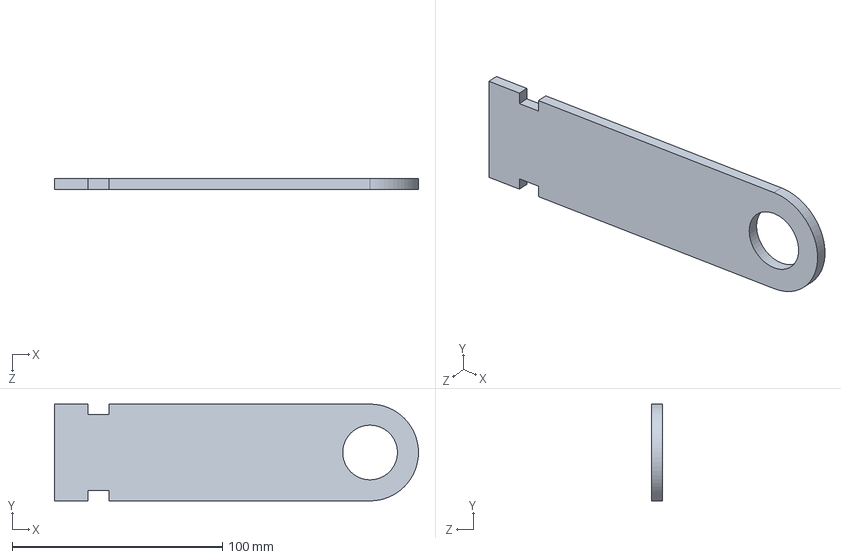
[picture p35: CAD file, 2026-03-10]
Frame_BodyWorks/Hitch_Jack_Points/Hitch point.SLDPRT
173.0 x 46.0 x 5.00 mm
