omacharya1710/Model_Rocketry_Project_IIT_Tirupati/Pedal/Master_Cylinder/Reservatorio Cilindro Mestre Polaris.SLDPRT

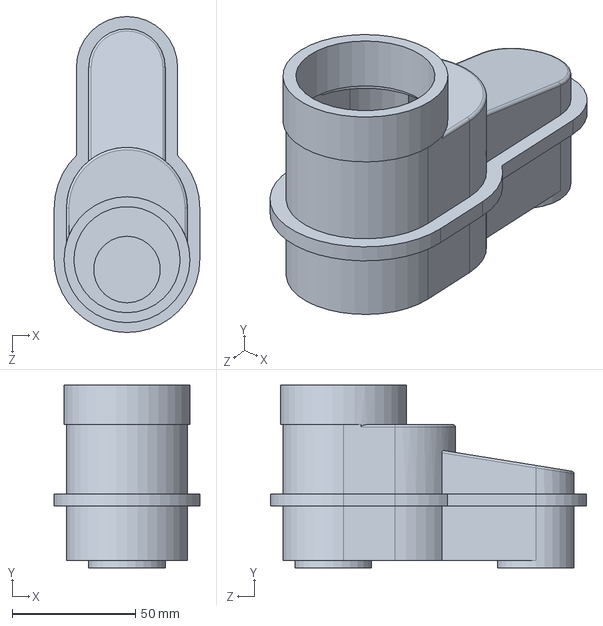
[picture p36: CAD file, 2026-03-10]
Pedal/Master_Cylinder/Reservatorio Cilindro Mestre Polaris.SLDPRT
59.0 x 74.0 x 128.0 mm
