omacharya1710/Model_Rocketry_Project_IIT_Tirupati/Shaft_Hubs/Brake_Disc_Hub/Rear Brake Hub.SLDPRT

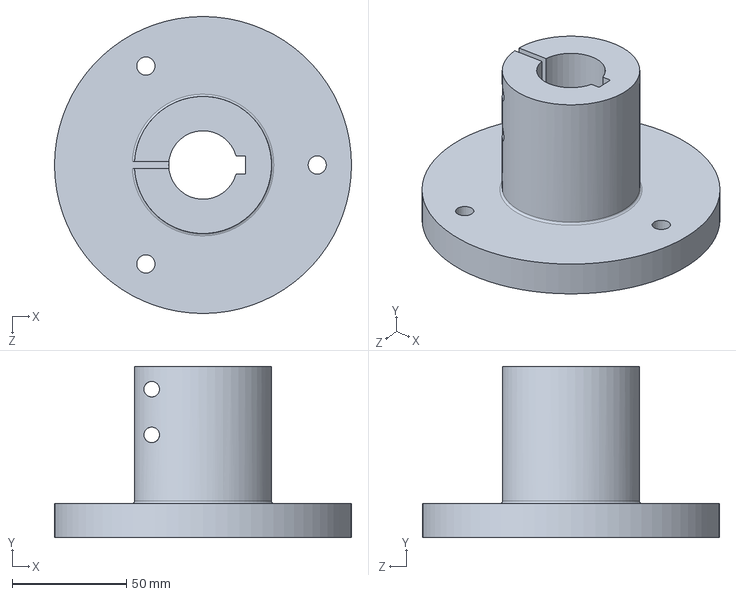
[picture p37: CAD file, 2026-03-10]
Shaft_Hubs/Brake_Disc_Hub/Rear Brake Hub.SLDPRT
130.0 x 75.0 x 130.0 mm
