omacharya1710/Model_Rocketry_Project_IIT_Tirupati/Shaft_Hubs/Flange_Bearing/Moutn Plate 2.SLDPRT

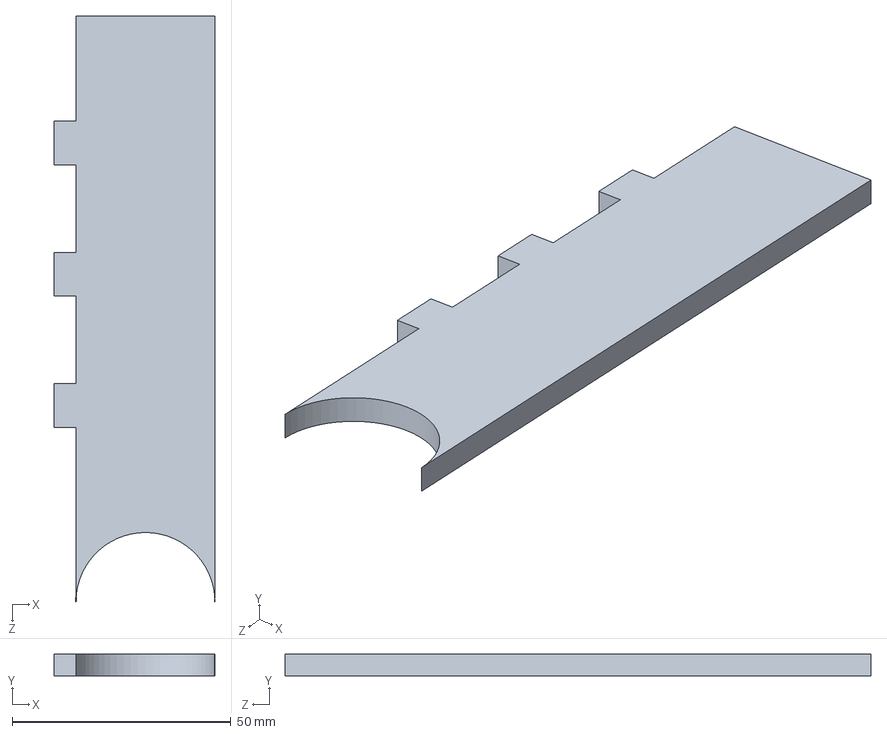
[picture p38: CAD file, 2026-03-10]
Shaft_Hubs/Flange_Bearing/Moutn Plate 2.SLDPRT
36.8 x 5.00 x 133.9 mm
