omacharya1710/Model_Rocketry_Project_IIT_Tirupati/Steering/Column_Assembly/Column_Support/UCFL-204.SLDPRT

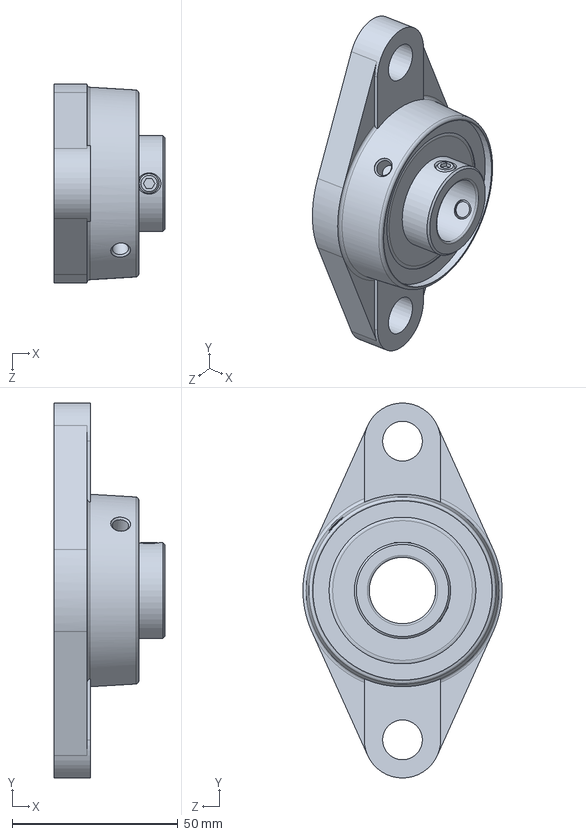
[picture p39: CAD file, 2026-03-10]
Steering/Column_Assembly/Column_Support/UCFL-204.SLDPRT
33.3 x 113.0 x 60.0 mm
