omacharya1710/Model_Rocketry_Project_IIT_Tirupati/Steering/Column_Assembly/V2/Pedal_Shifters/Paddle +.SLDPRT

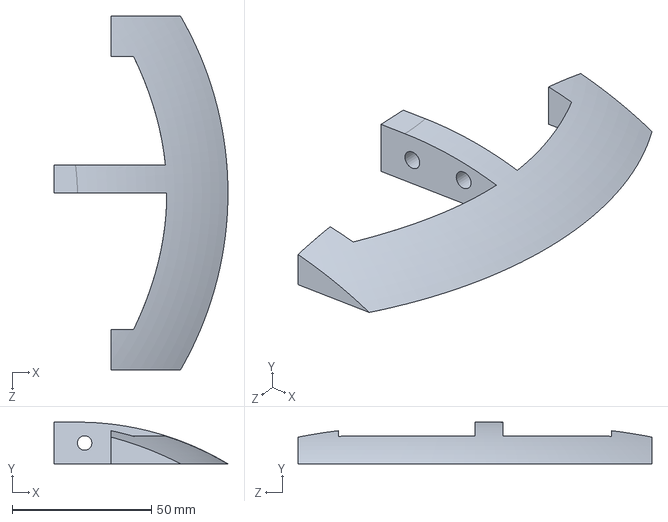
[picture p40: CAD file, 2026-03-10]
Steering/Column_Assembly/V2/Pedal_Shifters/Paddle +.SLDPRT
62.5 x 15.0 x 127.0 mm
