omacharya1710/Model_Rocketry_Project_IIT_Tirupati/Steering/Column_Assembly/V2/Steering_Wheel/Go Kart Steering Wheel 10 inches.STEP

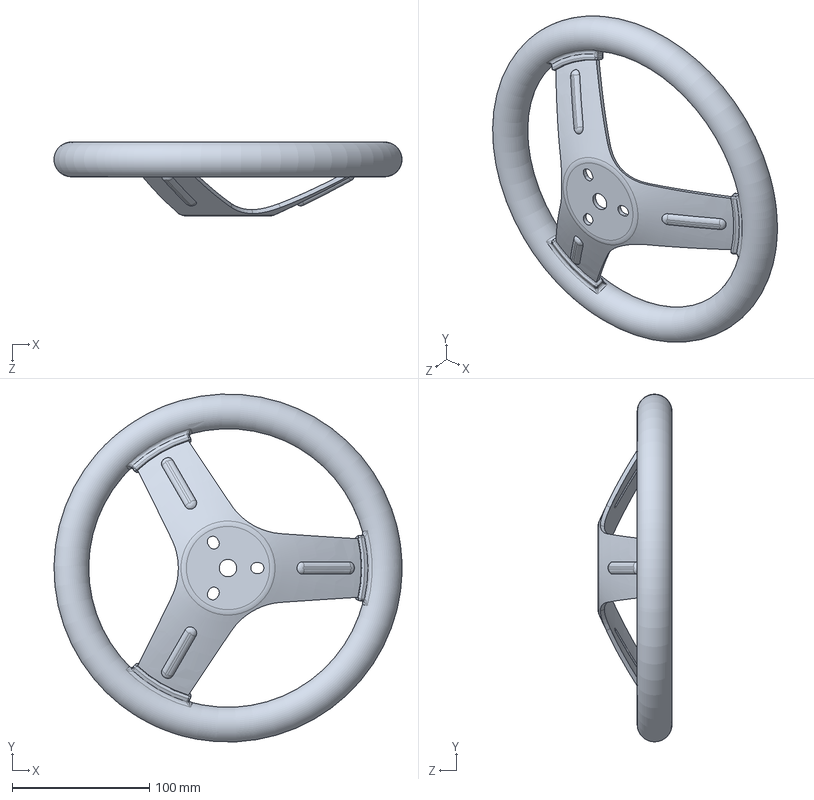
[picture p41: CAD file, 2026-03-10]
Steering/Column_Assembly/V2/Steering_Wheel/Go Kart Steering Wheel 10 inches.STEP
253.9 x 253.7 x 54.0 mm
