omacharya1710/Model_Rocketry_Project_IIT_Tirupati/Steering/Spindle_Assembly/Bearing_type/DU 1020 bushing.SLDPRT

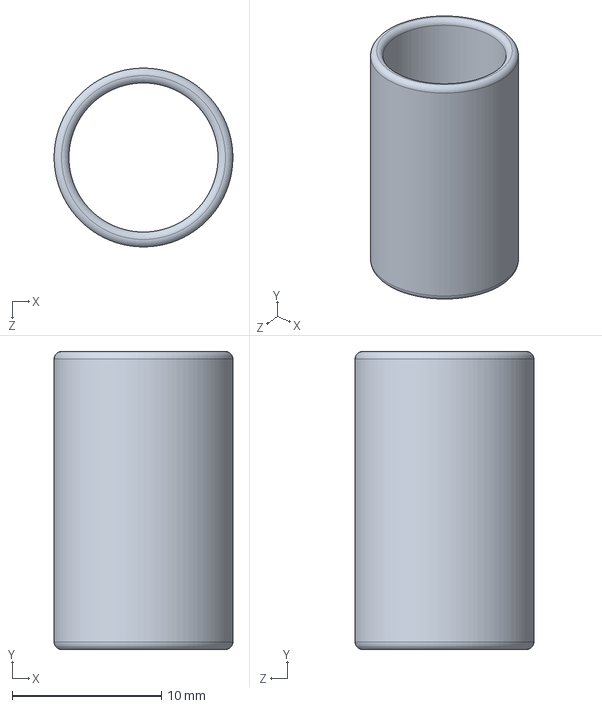
[picture p42: CAD file, 2026-03-10]
Steering/Spindle_Assembly/Bearing_type/DU 1020 bushing.SLDPRT
12.0 x 20.0 x 12.0 mm
