omacharya1710/Model_Rocketry_Project_IIT_Tirupati/Engine/Heat_Shield/Engine Heat Shield.SLDPRT

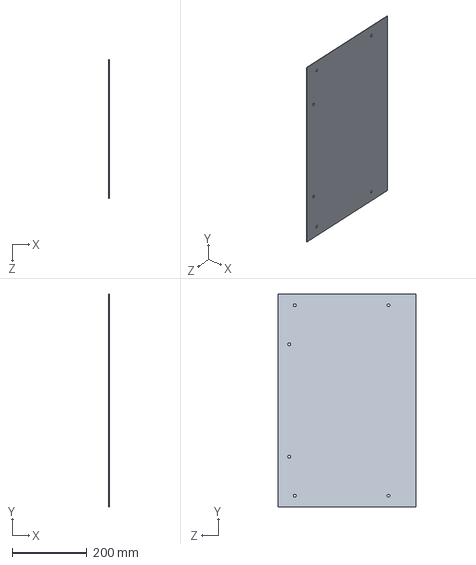
[picture p43: CAD file, 2026-03-10]
Engine/Heat_Shield/Engine Heat Shield.SLDPRT
1.00 x 568.2 x 368.2 mm
