omacharya1710/Model_Rocketry_Project_IIT_Tirupati/External_Components/Lift Point m8.SLDPRT

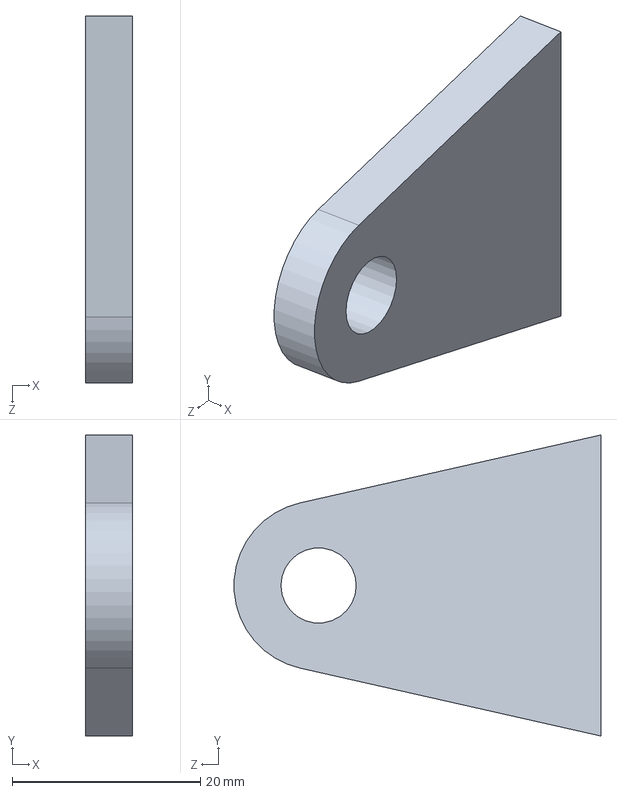
[picture p44: CAD file, 2026-03-10]
External_Components/Lift Point m8.SLDPRT
5.00 x 32.0 x 39.0 mm
