omacharya1710/Model_Rocketry_Project_IIT_Tirupati/Frame_BodyWorks/BodyWorks/Front Body works.SLDPRT

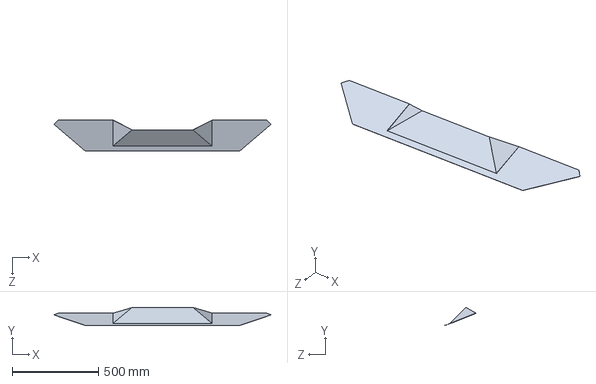
[picture p45: CAD file, 2026-03-10]
Frame_BodyWorks/BodyWorks/Front Body works.SLDPRT
1260.3 x 105.4 x 180.3 mm
