omacharya1710/Model_Rocketry_Project_IIT_Tirupati/Pedal/Master_Cylinder/Conector pedal cilindro mestre polaris.SLDPRT

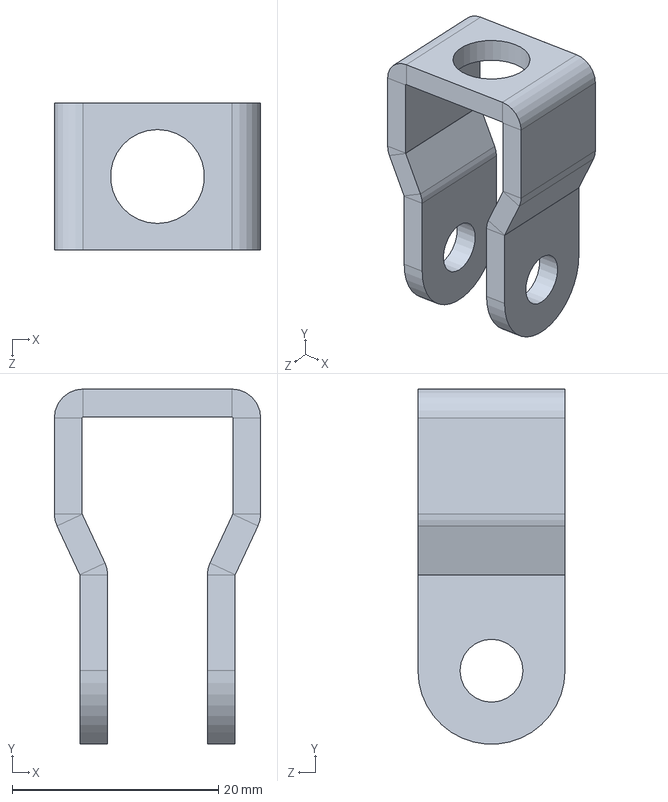
[picture p46: CAD file, 2026-03-10]
Pedal/Master_Cylinder/Conector pedal cilindro mestre polaris.SLDPRT
20.0 x 34.4 x 14.2 mm
