omacharya1710/Model_Rocketry_Project_IIT_Tirupati/Shaft_Hubs/Flange_Bearing/Mount.SLDPRT

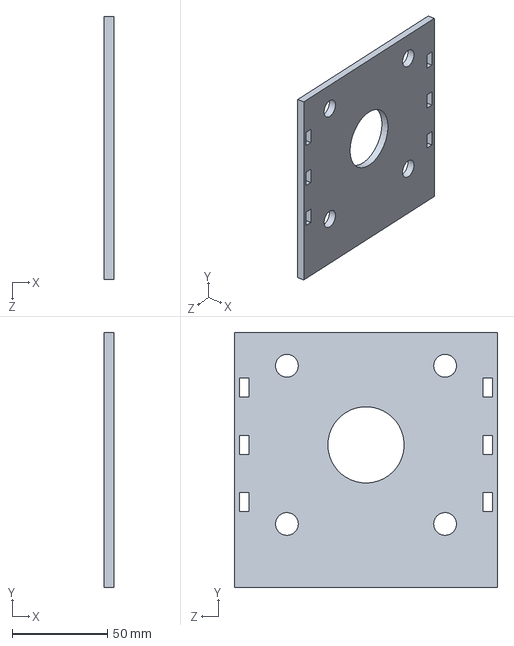
[picture p47: CAD file, 2026-03-10]
Shaft_Hubs/Flange_Bearing/Mount.SLDPRT
5.00 x 133.9 x 138.0 mm
