omacharya1710/Model_Rocketry_Project_IIT_Tirupati/Shaft_Hubs/Sprocket_Hub/44T.SLDPRT

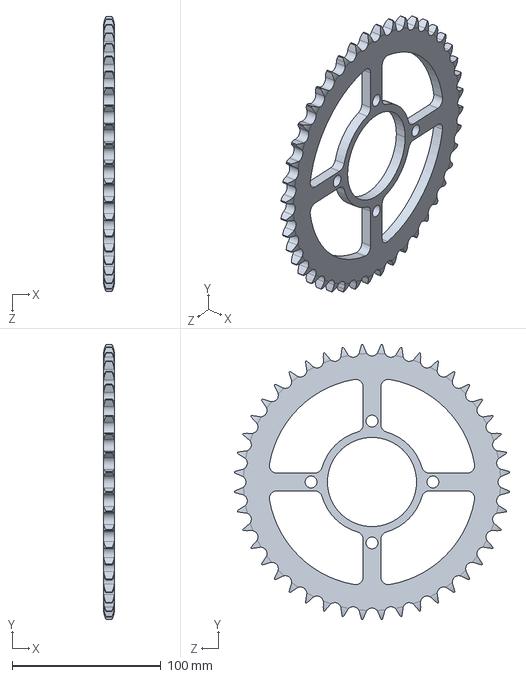
[picture p48: CAD file, 2026-03-10]
Shaft_Hubs/Sprocket_Hub/44T.SLDPRT
7.20 x 185.0 x 185.0 mm
