omacharya1710/Model_Rocketry_Project_IIT_Tirupati/Steering/Spindle_Assembly/Bearing_type/C_Bracket/GE10ES_Spherical_Bearing/plain_bearingge010el_0_02.SLDPRT

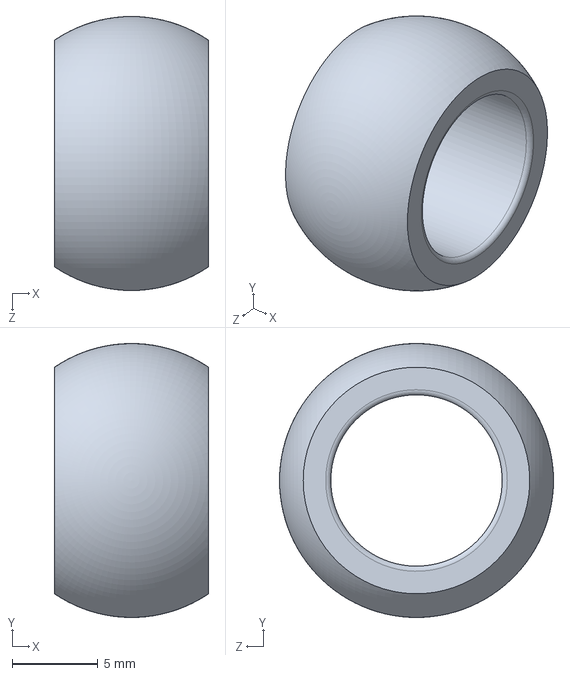
[picture p49: CAD file, 2026-03-10]
Steering/Spindle_Assembly/Bearing_type/C_Bracket/GE10ES_Spherical_Bearing/plain_bearingge010el_0_02.SLDPRT
9.00 x 16.0 x 16.0 mm
