omacharya1710/Model_Rocketry_Project_IIT_Tirupati/Steering/Spindle_Assembly/Bearing_type/Right spindle.SLDPRT

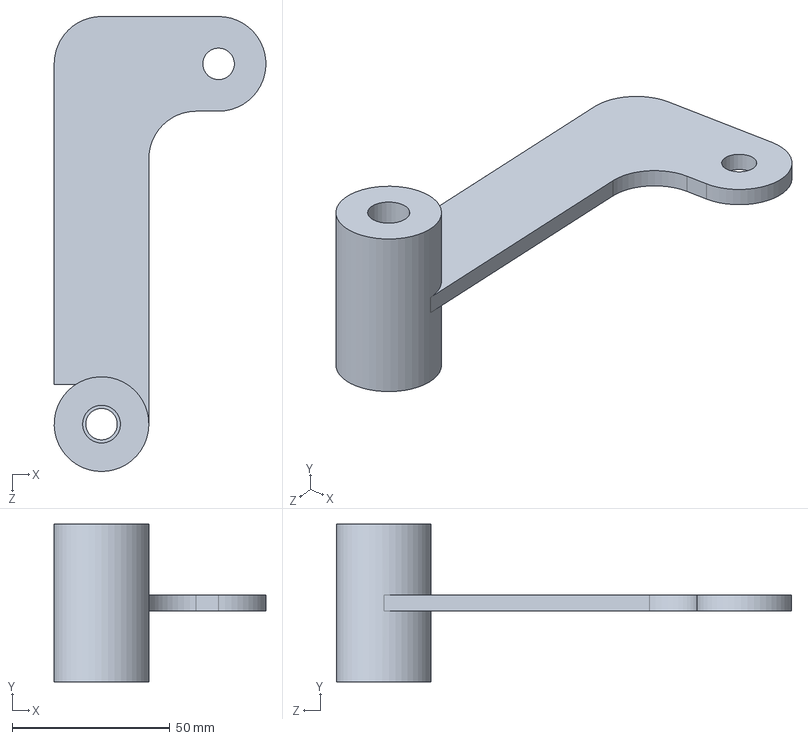
[picture p50: CAD file, 2026-03-10]
Steering/Spindle_Assembly/Bearing_type/Right spindle.SLDPRT
67.0 x 50.0 x 144.1 mm
