omacharya1710/Model_Rocketry_Project_IIT_Tirupati/Steering/Spindle_Assembly/Bias_Brake/Spindle/Spindle Right.SLDPRT

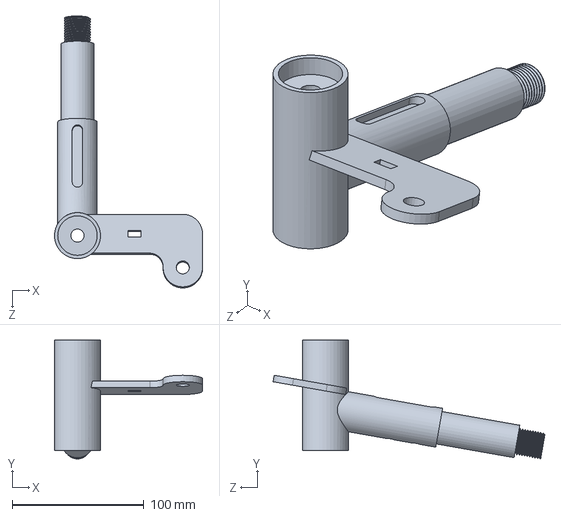
[picture p51: CAD file, 2026-03-10]
Steering/Spindle_Assembly/Bias_Brake/Spindle/Spindle Right.SLDPRT
112.5 x 90.3 x 206.6 mm
