omacharya1710/Model_Rocketry_Project_IIT_Tirupati/Tyres/6003_Ball_Bearing/outer shell - 6003.SLDPRT

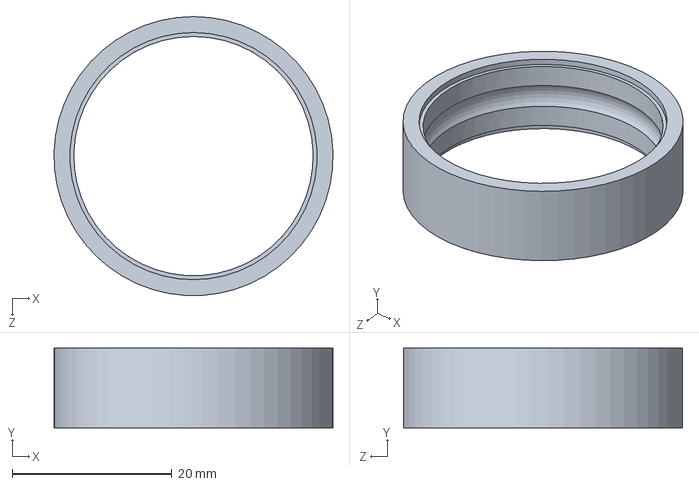
[picture p52: CAD file, 2026-03-10]
Tyres/6003_Ball_Bearing/outer shell - 6003.SLDPRT
35.0 x 10.0 x 35.0 mm
