omacharya1710/Model_Rocketry_Project_IIT_Tirupati/Frame_BodyWorks/BodyWorks/Bodyworks Mount 3.SLDPRT

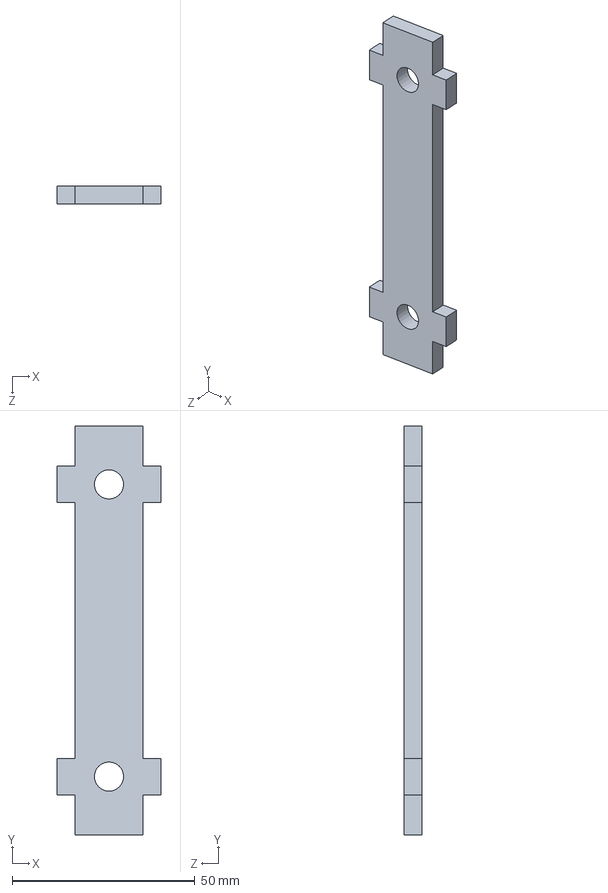
[picture p54: CAD file, 2026-03-10]
Frame_BodyWorks/BodyWorks/Bodyworks Mount 3.SLDPRT
28.5 x 112.0 x 5.00 mm
