omacharya1710/Model_Rocketry_Project_IIT_Tirupati/Frame_BodyWorks/Hitch_Jack_Points/Conector.SLDPRT

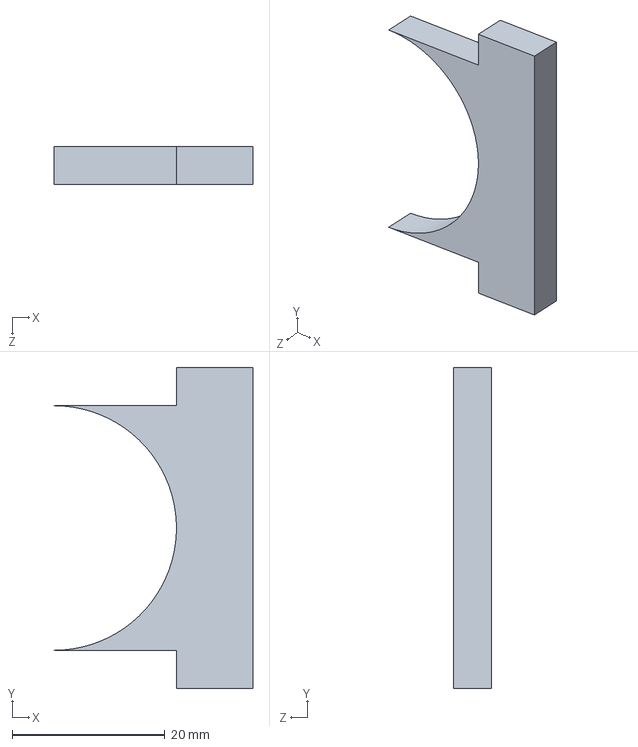
[picture p55: CAD file, 2026-03-10]
Frame_BodyWorks/Hitch_Jack_Points/Conector.SLDPRT
26.0 x 42.0 x 5.00 mm
