omacharya1710/Model_Rocketry_Project_IIT_Tirupati/Shaft_Hubs/Brake_Disc_Hub/Rear Brake DIsc.SLDPRT

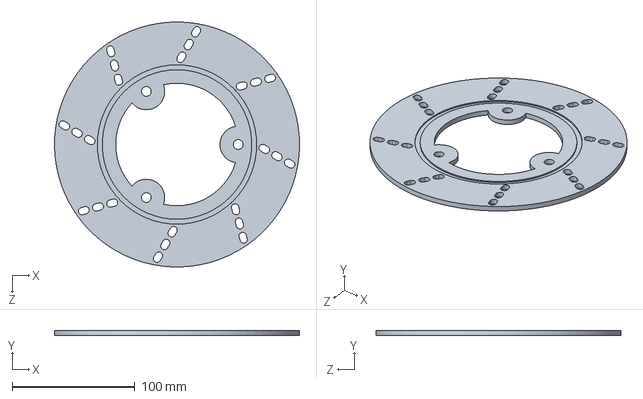
[picture p56: CAD file, 2026-03-10]
Shaft_Hubs/Brake_Disc_Hub/Rear Brake DIsc.SLDPRT
200.0 x 4.00 x 200.0 mm
