omacharya1710/Model_Rocketry_Project_IIT_Tirupati/Shaft_Hubs/Sprocket_Hub/13T Gear.STEP

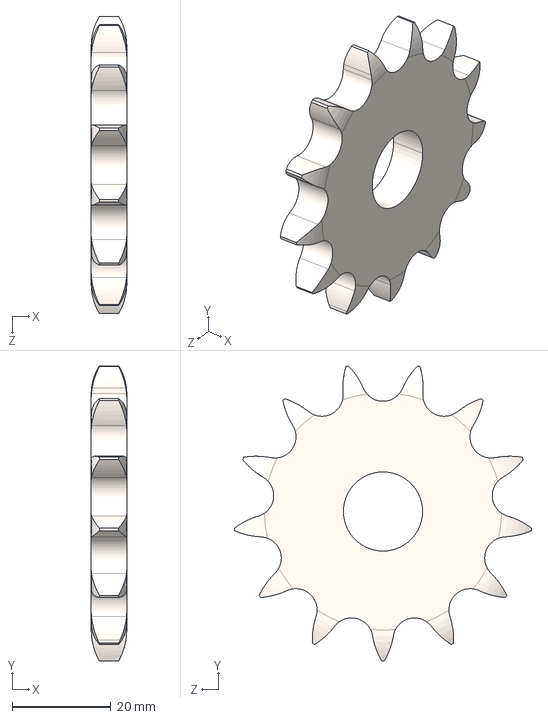
[picture p57: CAD file, 2026-03-10]
Shaft_Hubs/Sprocket_Hub/13T Gear.STEP
7.20 x 59.6 x 60.1 mm
