omacharya1710/Model_Rocketry_Project_IIT_Tirupati/Steering/Column_Assembly/Column Adjust Lift point.SLDPRT

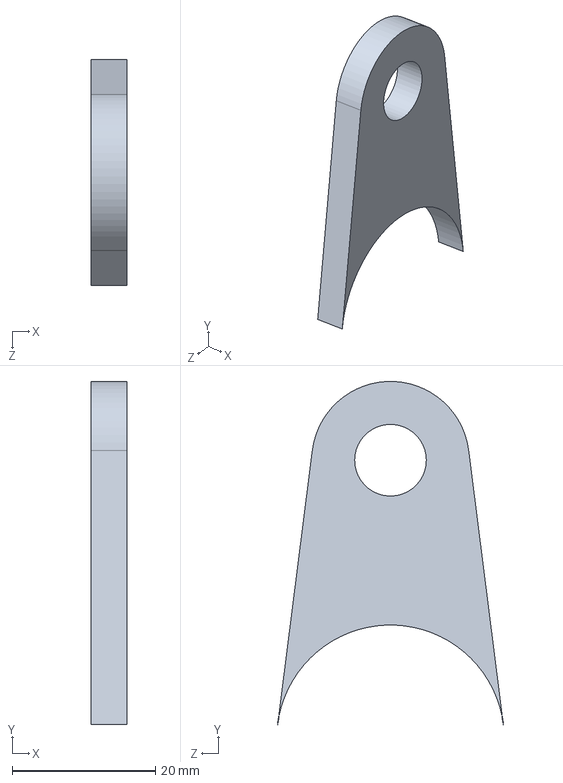
[picture p58: CAD file, 2026-03-10]
Steering/Column_Assembly/Column Adjust Lift point.SLDPRT
5.00 x 47.9 x 31.5 mm
