omacharya1710/Model_Rocketry_Project_IIT_Tirupati/Steering/Column_Assembly/V2/Pedal_Shifters/Bushing.SLDPRT

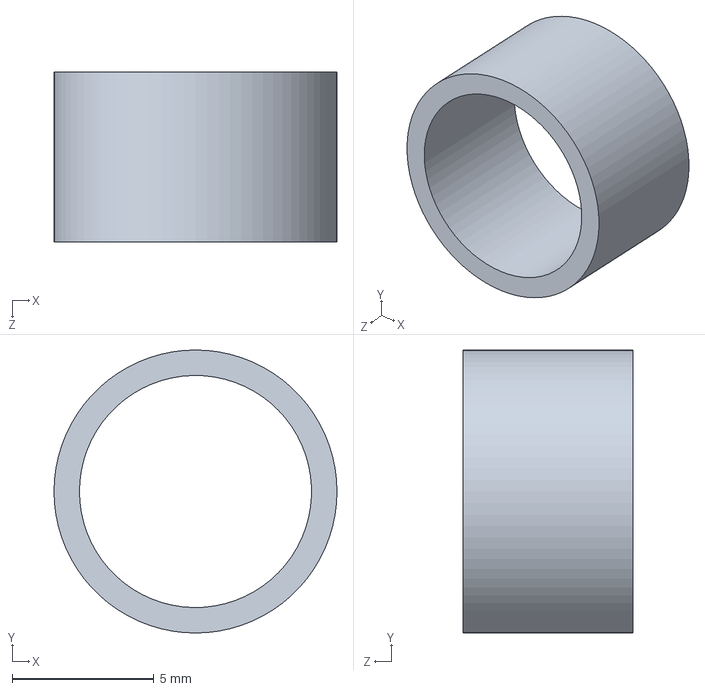
[picture p59: CAD file, 2026-03-10]
Steering/Column_Assembly/V2/Pedal_Shifters/Bushing.SLDPRT
10.0 x 10.0 x 6.00 mm
