omacharya1710/Model_Rocketry_Project_IIT_Tirupati/Steering/Spindle_Assembly/Bias_Brake/Spindle/6200 RS Spindle Bearing.SLDPRT

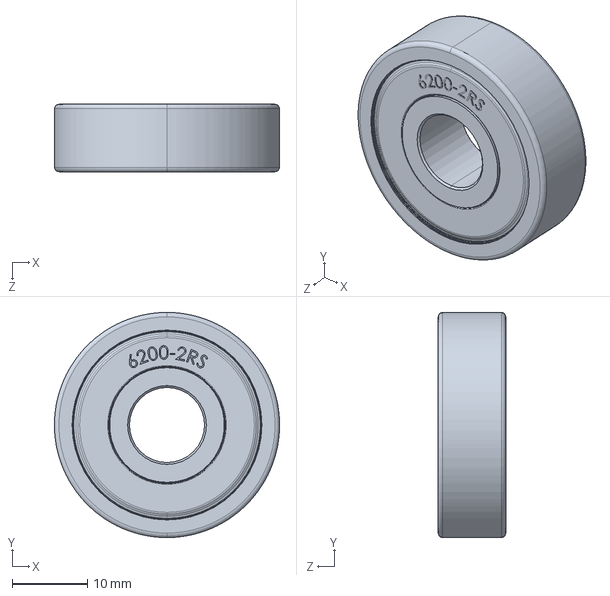
[picture p61: CAD file, 2026-03-10]
Steering/Spindle_Assembly/Bias_Brake/Spindle/6200 RS Spindle Bearing.SLDPRT
30.0 x 30.0 x 9.00 mm
