omacharya1710/Model_Rocketry_Project_IIT_Tirupati/Tyres/6003_Ball_Bearing/inner shell - 6003.SLDPRT

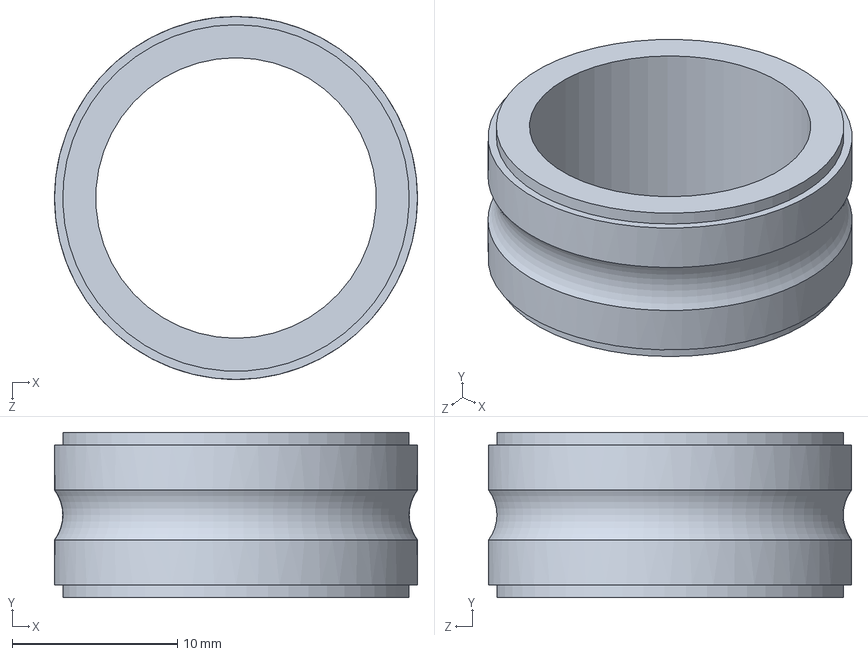
[picture p62: CAD file, 2026-03-10]
Tyres/6003_Ball_Bearing/inner shell - 6003.SLDPRT
22.0 x 10.0 x 22.0 mm
