omacharya1710/Model_Rocketry_Project_IIT_Tirupati/Ergonomic/Articulated_Dummy/Fingers_L.SLDPRT

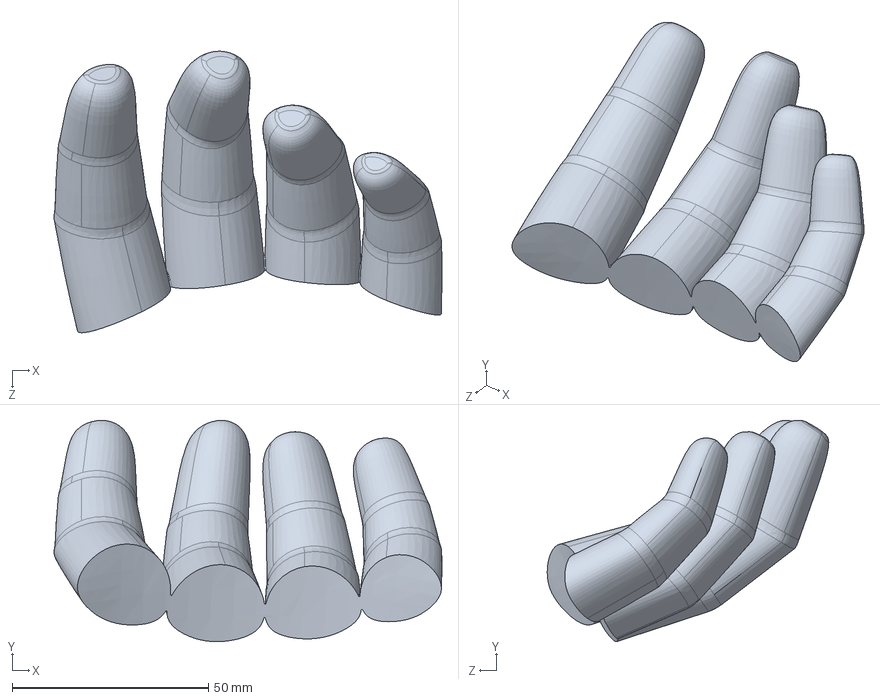
[picture p63: CAD file, 2026-03-10]
Ergonomic/Articulated_Dummy/Fingers_L.SLDPRT
98.8 x 56.4 x 71.7 mm
