omacharya1710/Model_Rocketry_Project_IIT_Tirupati/Frame_BodyWorks/BodyWorks/sheet lift points.SLDPRT

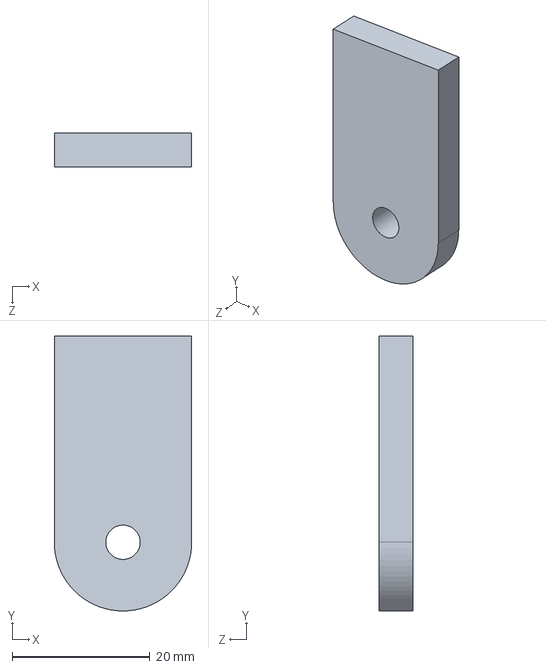
[picture p64: CAD file, 2026-03-10]
Frame_BodyWorks/BodyWorks/sheet lift points.SLDPRT
20.0 x 40.0 x 5.00 mm
