omacharya1710/Model_Rocketry_Project_IIT_Tirupati/Frame_BodyWorks/Hitch_Jack_Points/Jack Point.SLDPRT

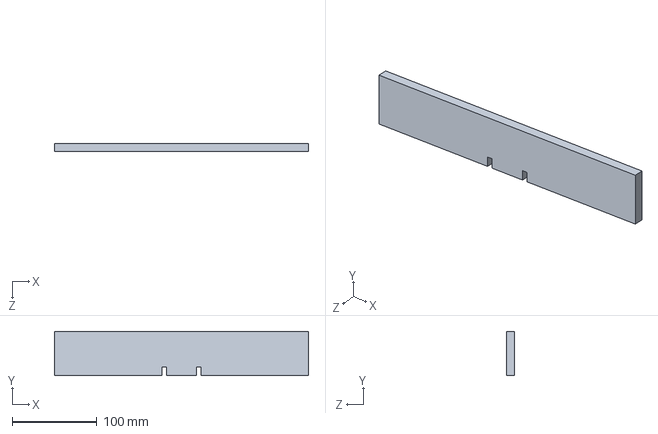
[picture p65: CAD file, 2026-03-10]
Frame_BodyWorks/Hitch_Jack_Points/Jack Point.SLDPRT
300.0 x 52.0 x 10.0 mm
