omacharya1710/Model_Rocketry_Project_IIT_Tirupati/Pedal/Master_Cylinder/Borracha proteção haste cilindro mestre.SLDPRT

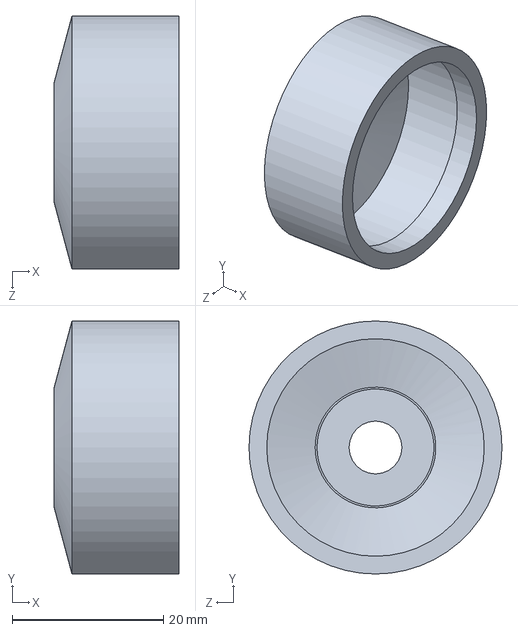
[picture p66: CAD file, 2026-03-10]
Pedal/Master_Cylinder/Borracha proteção haste cilindro mestre.SLDPRT
16.5 x 33.5 x 33.5 mm
