omacharya1710/Model_Rocketry_Project_IIT_Tirupati/Shaft_Hubs/Flange_Bearing/UCF206.SLDPRT

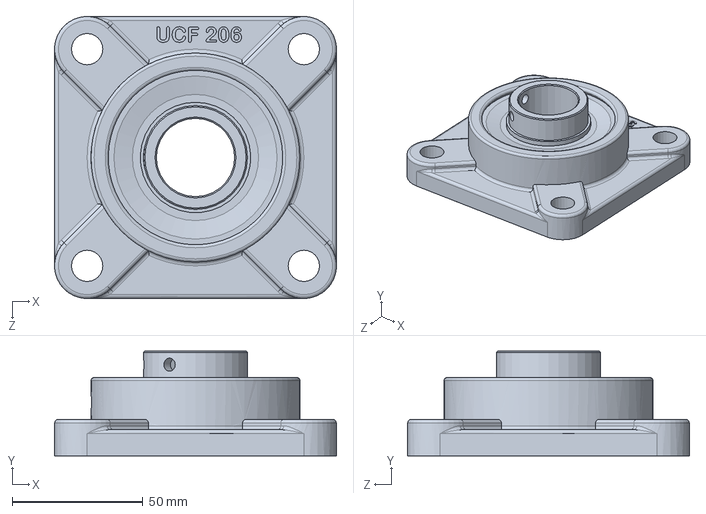
[picture p67: CAD file, 2026-03-10]
Shaft_Hubs/Flange_Bearing/UCF206.SLDPRT
108.0 x 40.1 x 108.0 mm
