omacharya1710/Model_Rocketry_Project_IIT_Tirupati/Shaft_Hubs/Sprocket_Hub/Assem1.STEP

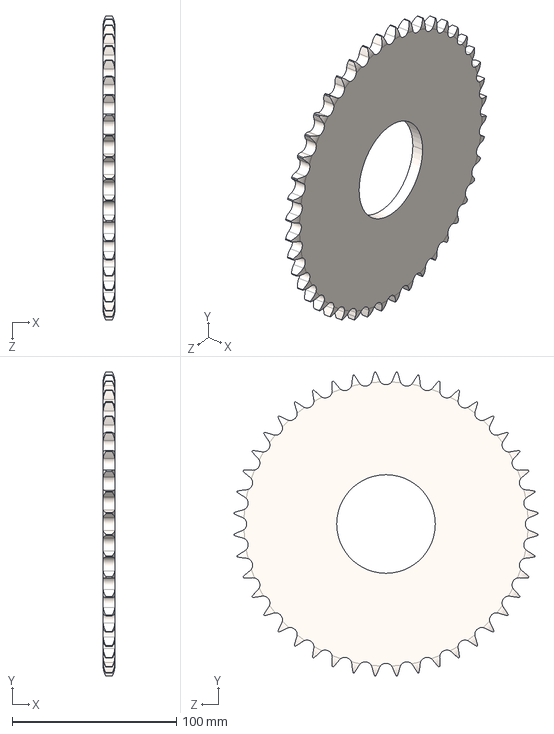
[picture p68: CAD file, 2026-03-10]
Shaft_Hubs/Sprocket_Hub/Assem1.STEP
7.20 x 185.0 x 185.0 mm
