omacharya1710/Model_Rocketry_Project_IIT_Tirupati/Steering/Column_Assembly/Tie Rod.SLDPRT

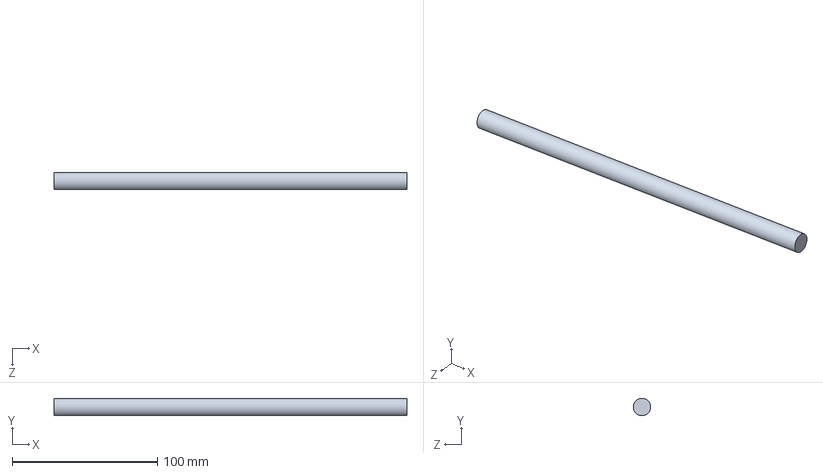
[picture p69: CAD file, 2026-03-10]
Steering/Column_Assembly/Tie Rod.SLDPRT
243.1 x 12.0 x 12.0 mm
