omacharya1710/Model_Rocketry_Project_IIT_Tirupati/Steering/Column_Assembly/V2/Pedal_Shifters/Swing Bar.SLDPRT

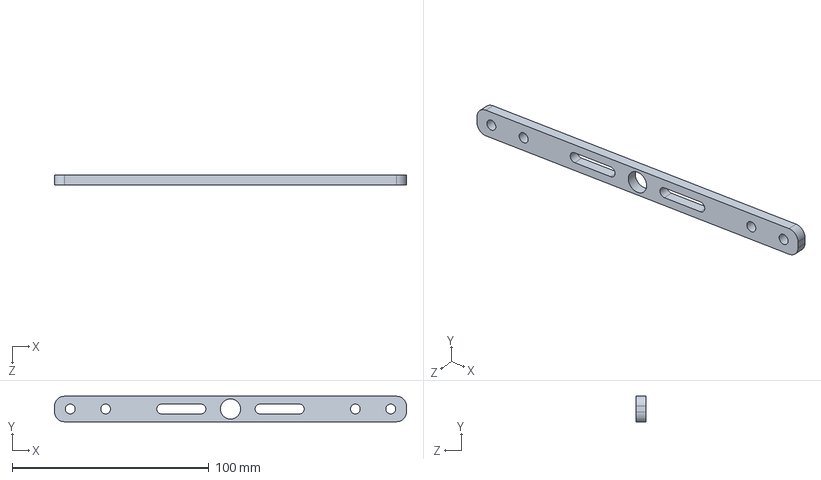
[picture p70: CAD file, 2026-03-10]
Steering/Column_Assembly/V2/Pedal_Shifters/Swing Bar.SLDPRT
178.9 x 13.0 x 5.00 mm
