omacharya1710/Model_Rocketry_Project_IIT_Tirupati/Steering/Spindle_Assembly/Bearing_type/ellipse.SLDPRT

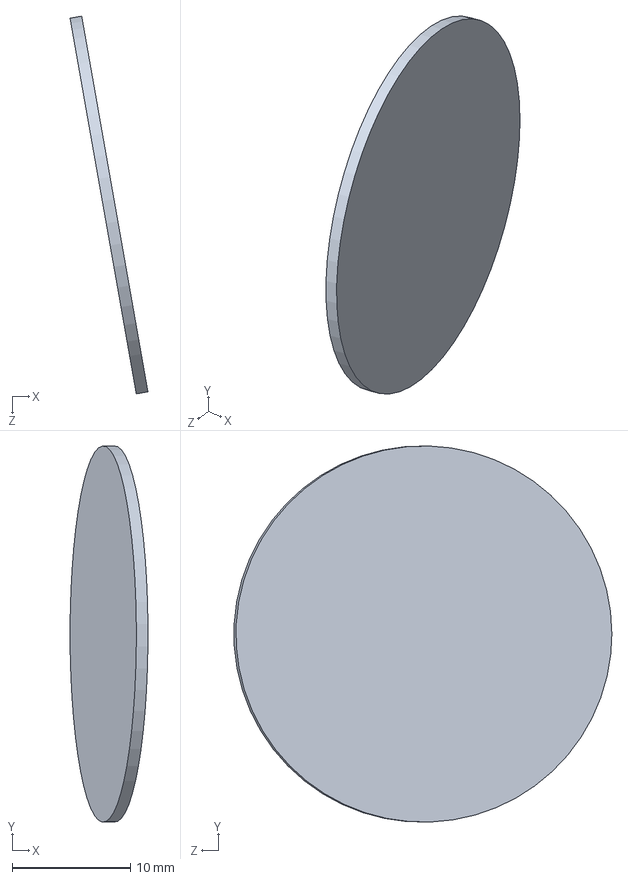
[picture p71: CAD file, 2026-03-10]
Steering/Spindle_Assembly/Bearing_type/ellipse.SLDPRT
6.58 x 31.7 x 31.9 mm
