omacharya1710/Model_Rocketry_Project_IIT_Tirupati/Steering/Spindle_Assembly/Bias_Brake/Spindle/Spindle Left.SLDPRT

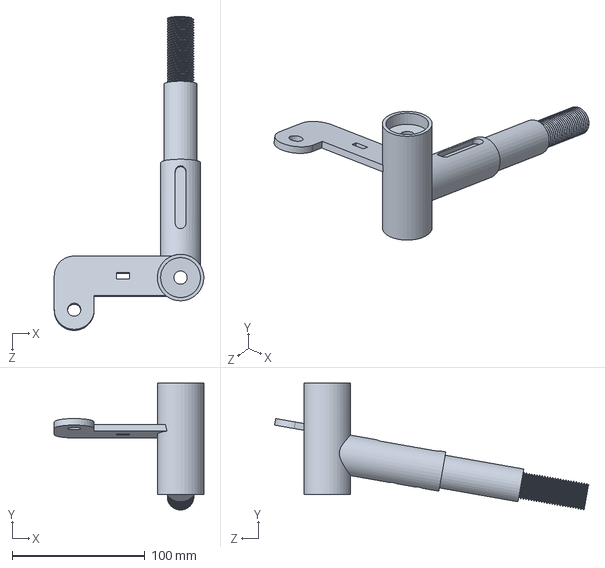
[picture p72: CAD file, 2026-03-10]
Steering/Spindle_Assembly/Bias_Brake/Spindle/Spindle Left.SLDPRT
112.4 x 95.5 x 236.2 mm
