omacharya1710/Model_Rocketry_Project_IIT_Tirupati/Tyres/6003_Ball_Bearing/6003 rubber seal.SLDPRT

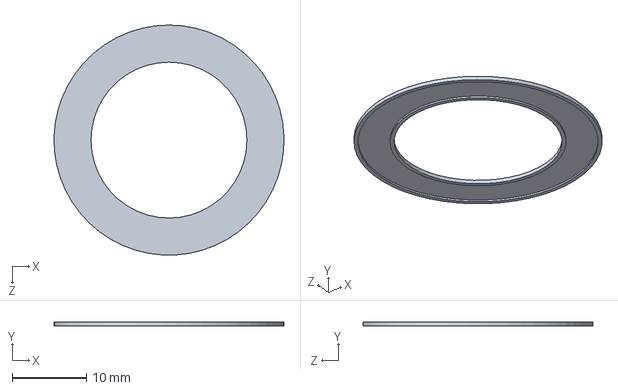
[picture p73: CAD file, 2026-03-10]
Tyres/6003_Ball_Bearing/6003 rubber seal.SLDPRT
31.0 x 0.5 x 31.0 mm
