omacharya1710/Model_Rocketry_Project_IIT_Tirupati/Ergonomic/Articulated_Dummy/Pelvis.SLDPRT

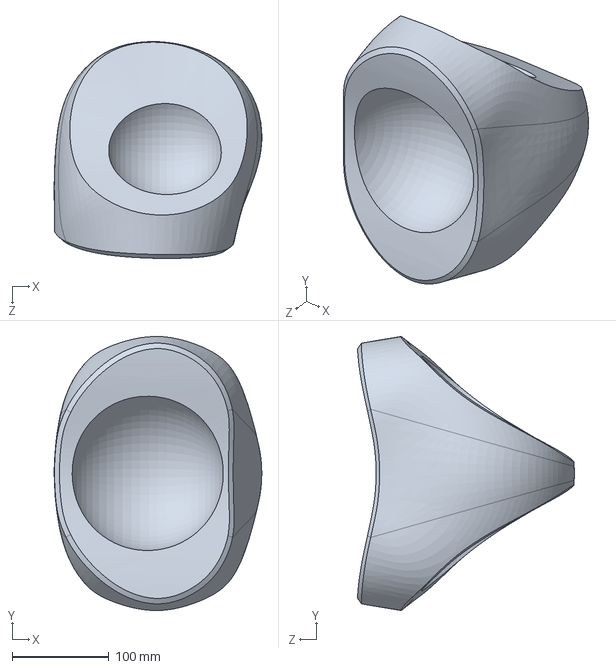
[picture p74: CAD file, 2026-03-10]
Ergonomic/Articulated_Dummy/Pelvis.SLDPRT
215.1 x 283.7 x 224.6 mm
