omacharya1710/Model_Rocketry_Project_IIT_Tirupati/Frame_BodyWorks/BodyWorks/Bodywork Mount 2.SLDPRT

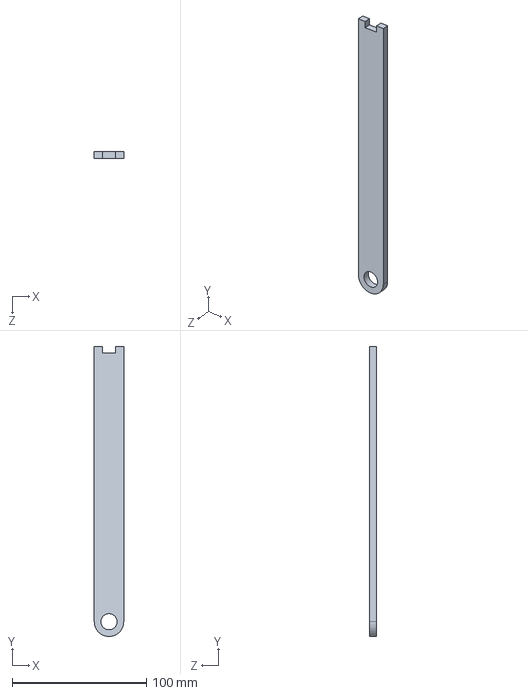
[picture p75: CAD file, 2026-03-10]
Frame_BodyWorks/BodyWorks/Bodywork Mount 2.SLDPRT
22.0 x 216.0 x 5.00 mm
