omacharya1710/Model_Rocketry_Project_IIT_Tirupati/Pedal/Master_Cylinder/Porca M8 Sem Travante.SLDPRT

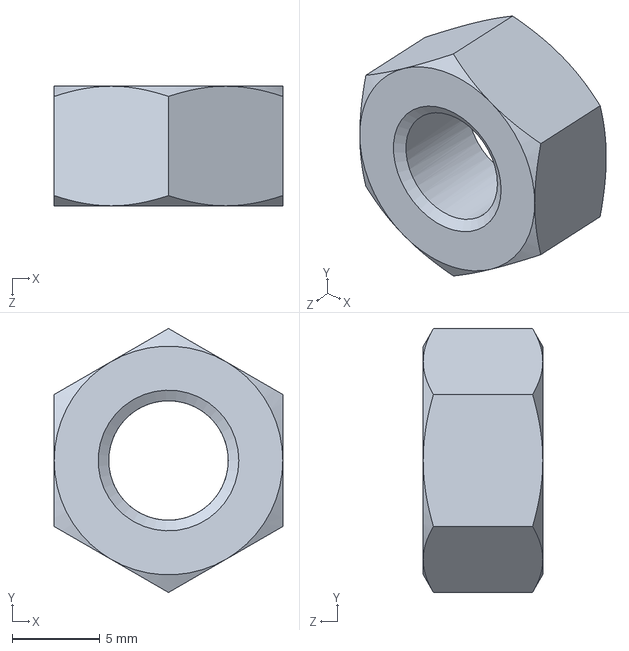
[picture p76: CAD file, 2026-03-10]
Pedal/Master_Cylinder/Porca M8 Sem Travante.SLDPRT
13.0 x 15.0 x 6.80 mm
