omacharya1710/Model_Rocketry_Project_IIT_Tirupati/Shaft_Hubs/Sprocket_Hub/Sproket Generator.SLDPRT

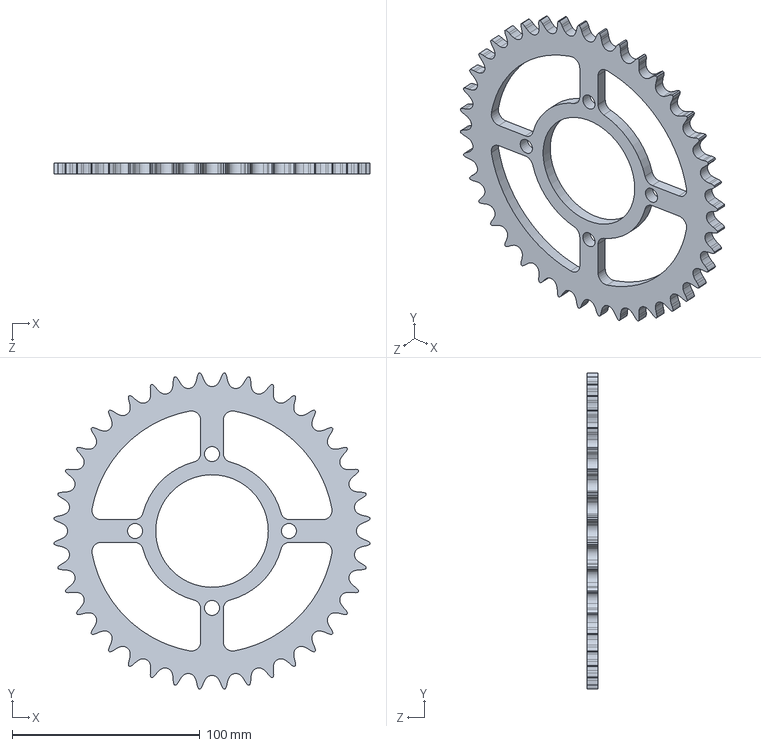
[picture p77: CAD file, 2026-03-10]
Shaft_Hubs/Sprocket_Hub/Sproket Generator.SLDPRT
168.4 x 168.4 x 6.00 mm
