omacharya1710/Model_Rocketry_Project_IIT_Tirupati/Steering/Column_Assembly/Column Adjust.SLDPRT

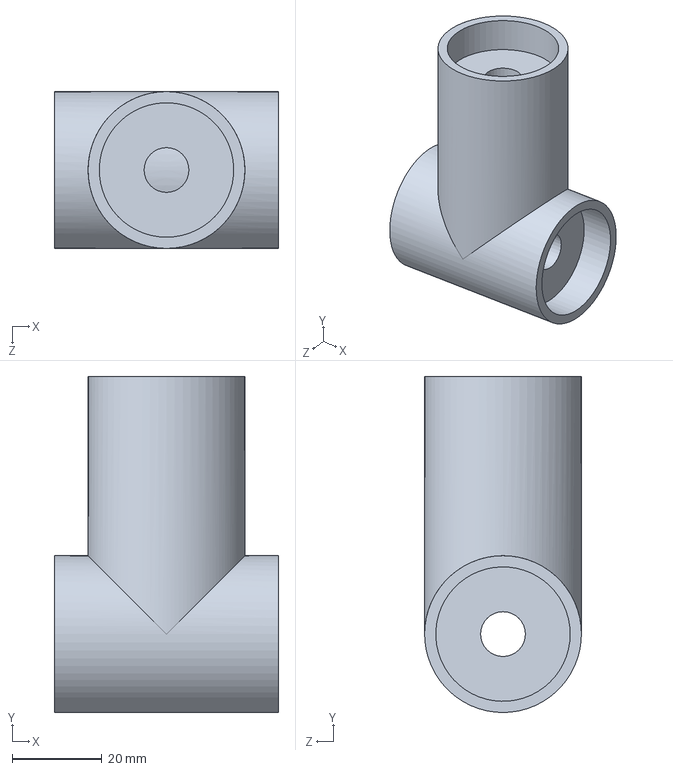
[picture p78: CAD file, 2026-03-10]
Steering/Column_Assembly/Column Adjust.SLDPRT
50.0 x 75.0 x 35.0 mm
