omacharya1710/Model_Rocketry_Project_IIT_Tirupati/Ergonomic/Articulated_Dummy/LowerLeg_R.SLDPRT

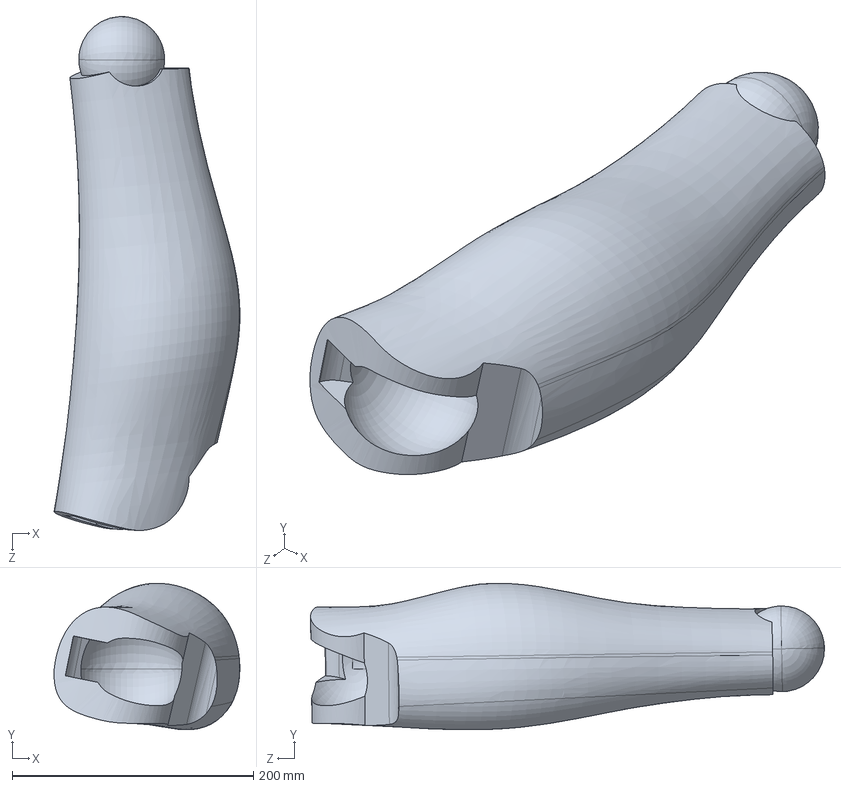
[picture p79: CAD file, 2026-03-10]
Ergonomic/Articulated_Dummy/LowerLeg_R.SLDPRT
154.2 x 121.5 x 426.2 mm
