omacharya1710/Model_Rocketry_Project_IIT_Tirupati/Frame_BodyWorks/BodyWorks/Bodywork Mount.SLDPRT

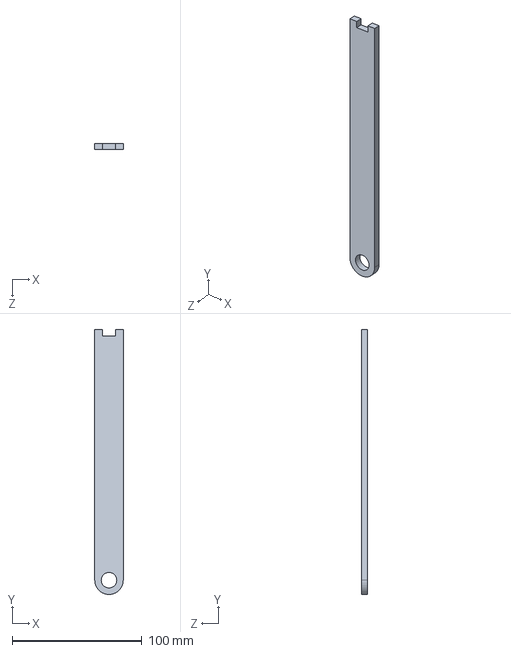
[picture p80: CAD file, 2026-03-10]
Frame_BodyWorks/BodyWorks/Bodywork Mount.SLDPRT
22.0 x 204.0 x 5.00 mm
