omacharya1710/Model_Rocketry_Project_IIT_Tirupati/Pedal/Master_Cylinder/Haste cilindro mestre.SLDPRT

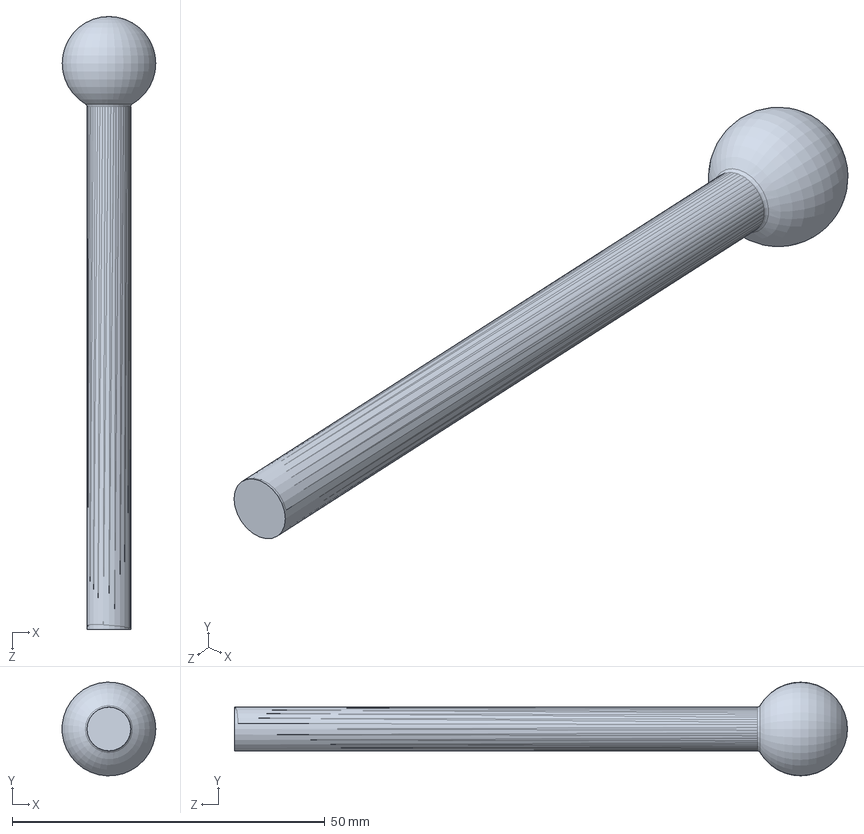
[picture p81: CAD file, 2026-03-10]
Pedal/Master_Cylinder/Haste cilindro mestre.SLDPRT
15.0 x 15.0 x 98.0 mm
