omacharya1710/Model_Rocketry_Project_IIT_Tirupati/Steering/Column_Assembly/Support Column.SLDPRT

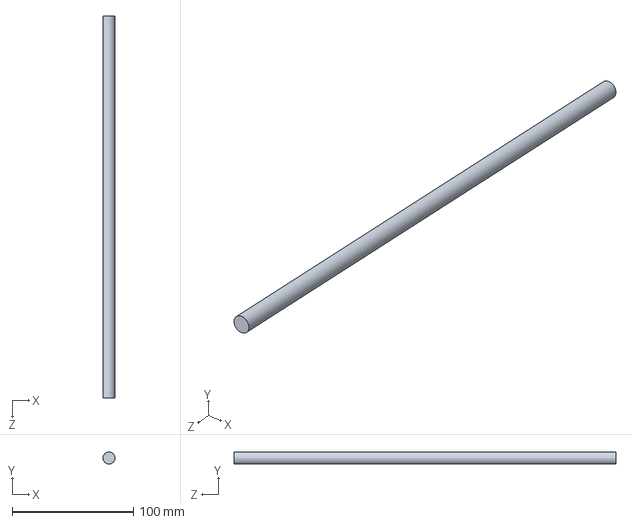
[picture p82: CAD file, 2026-03-10]
Steering/Column_Assembly/Support Column.SLDPRT
10.0 x 9.98 x 315.0 mm
