omacharya1710/Model_Rocketry_Project_IIT_Tirupati/Steering/Spindle_Assembly/Bias_Brake/Spindle/C braket.SLDPRT

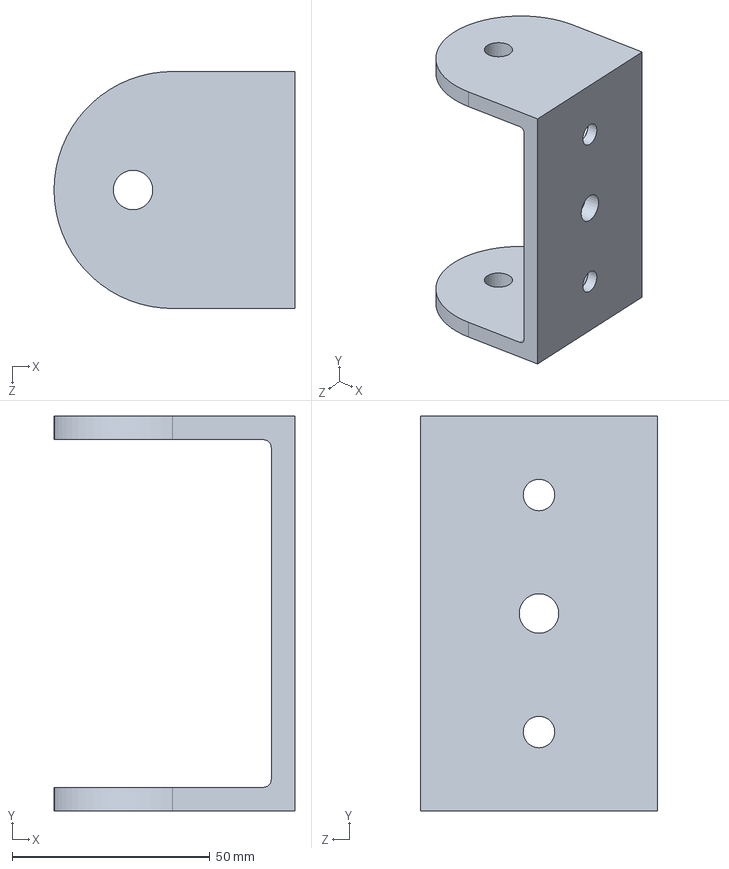
[picture p83: CAD file, 2026-03-10]
Steering/Spindle_Assembly/Bias_Brake/Spindle/C braket.SLDPRT
61.0 x 100.0 x 60.0 mm
