omacharya1710/Model_Rocketry_Project_IIT_Tirupati/Frame_BodyWorks/BodyWorks/C bracket Mount Plate.SLDPRT

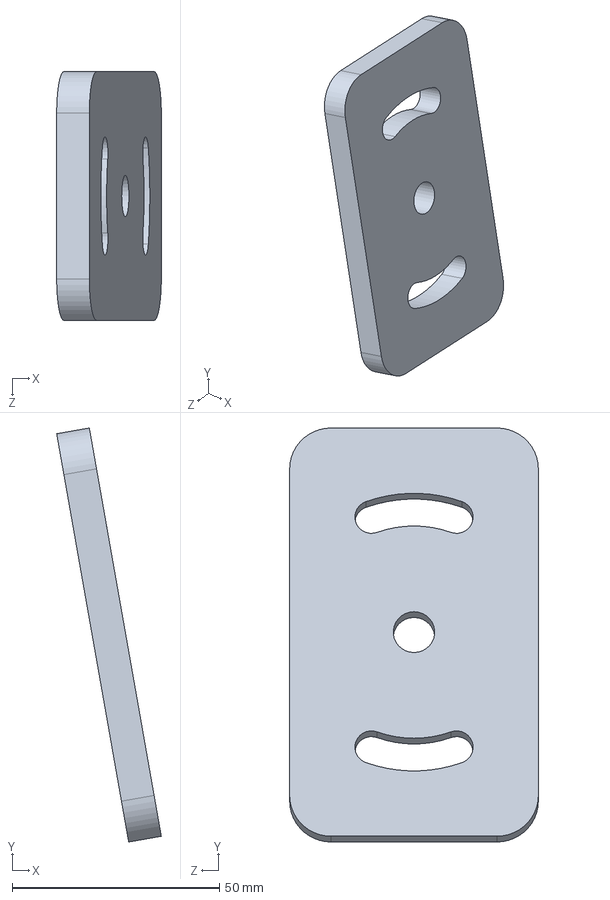
[picture p84: CAD file, 2026-03-10]
Frame_BodyWorks/BodyWorks/C bracket Mount Plate.SLDPRT
25.2 x 99.9 x 60.0 mm
