omacharya1710/Model_Rocketry_Project_IIT_Tirupati/Pedal/Master_Cylinder/Tampa Reservatorio Cilindro Mestre Polaris.SLDPRT

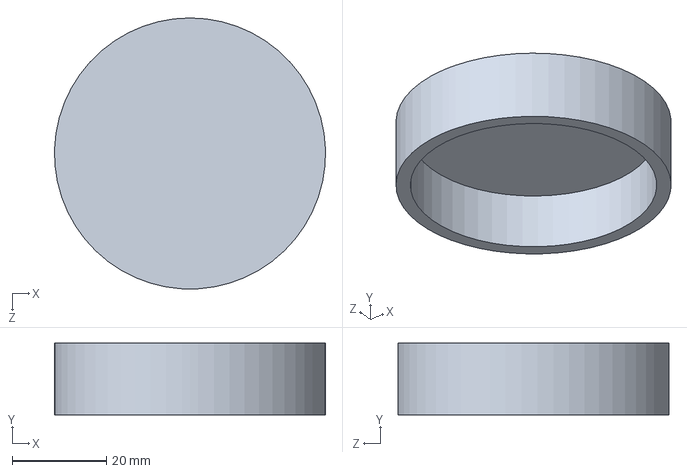
[picture p85: CAD file, 2026-03-10]
Pedal/Master_Cylinder/Tampa Reservatorio Cilindro Mestre Polaris.SLDPRT
57.5 x 15.2 x 57.5 mm
