omacharya1710/Model_Rocketry_Project_IIT_Tirupati/Steering/Column_Assembly/Ball.SLDPRT

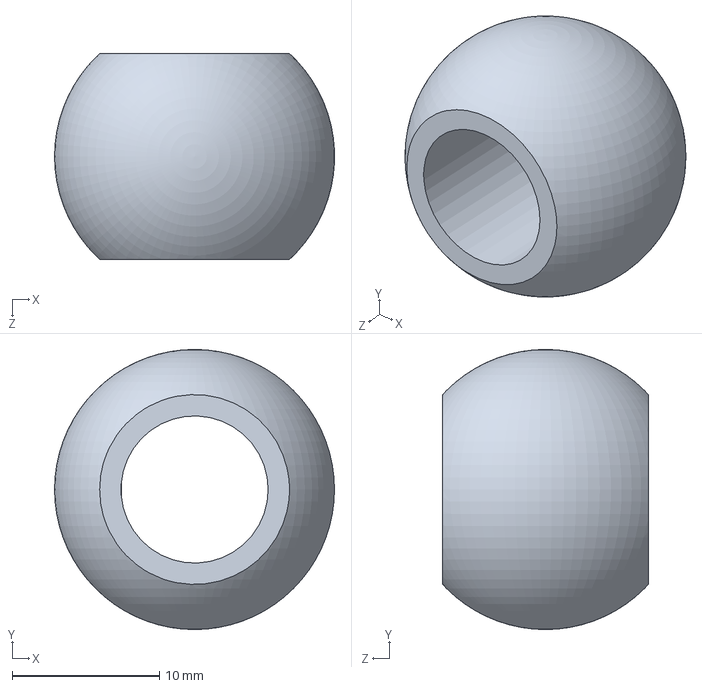
[picture p86: CAD file, 2026-03-10]
Steering/Column_Assembly/Ball.SLDPRT
19.0 x 19.0 x 14.0 mm
