omacharya1710/Model_Rocketry_Project_IIT_Tirupati/Steering/Spindle_Assembly/Bearing_type/Spindle Part 2.SLDPRT

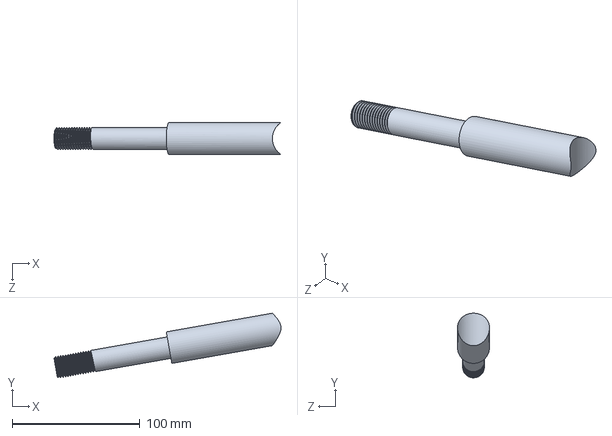
[picture p87: CAD file, 2026-03-10]
Steering/Spindle_Assembly/Bearing_type/Spindle Part 2.SLDPRT
177.4 x 50.5 x 25.0 mm
