omacharya1710/Model_Rocketry_Project_IIT_Tirupati/Steering/Spindle_Assembly/Bias_Brake/Spindle/30mm OD x 40mm lenght Key.SLDPRT

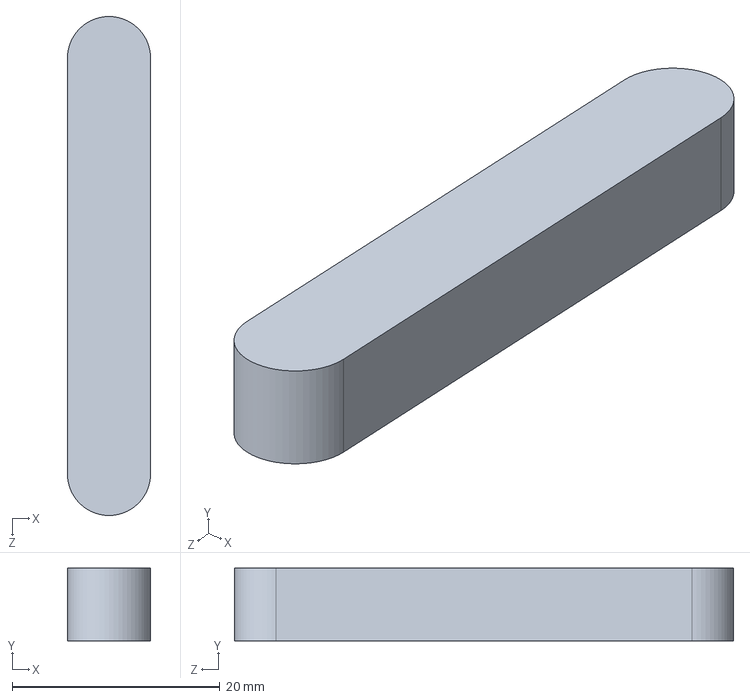
[picture p88: CAD file, 2026-03-10]
Steering/Spindle_Assembly/Bias_Brake/Spindle/30mm OD x 40mm lenght Key.SLDPRT
8.00 x 7.00 x 48.0 mm
