omacharya1710/Model_Rocketry_Project_IIT_Tirupati/Pedal/Master_Cylinder/Corpo Cilindro Mestre Polaris Shopee.SLDPRT

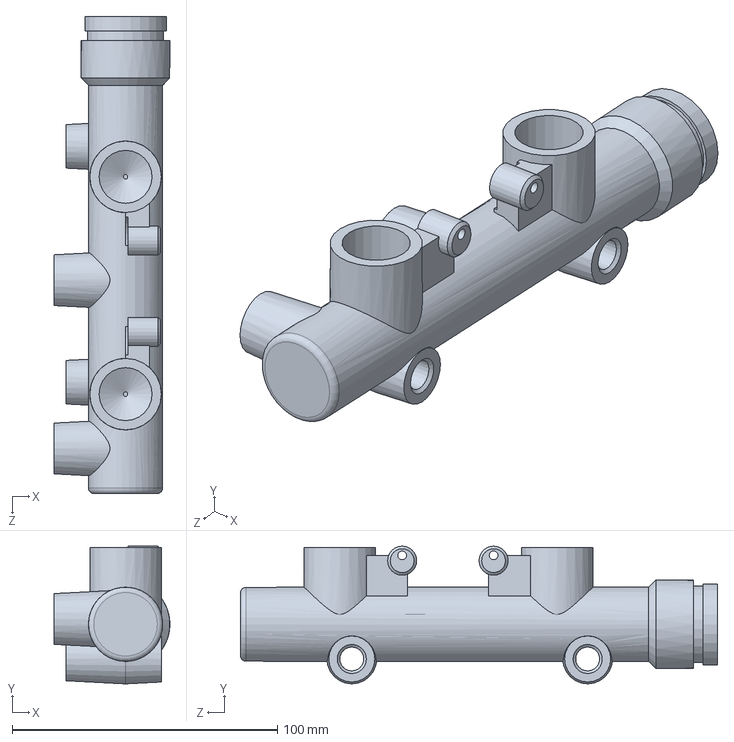
[picture p89: CAD file, 2026-03-10]
Pedal/Master_Cylinder/Corpo Cilindro Mestre Polaris Shopee.SLDPRT
43.8 x 52.0 x 180.0 mm
