omacharya1710/Model_Rocketry_Project_IIT_Tirupati/Steering/Column_Assembly/Plate.SLDPRT

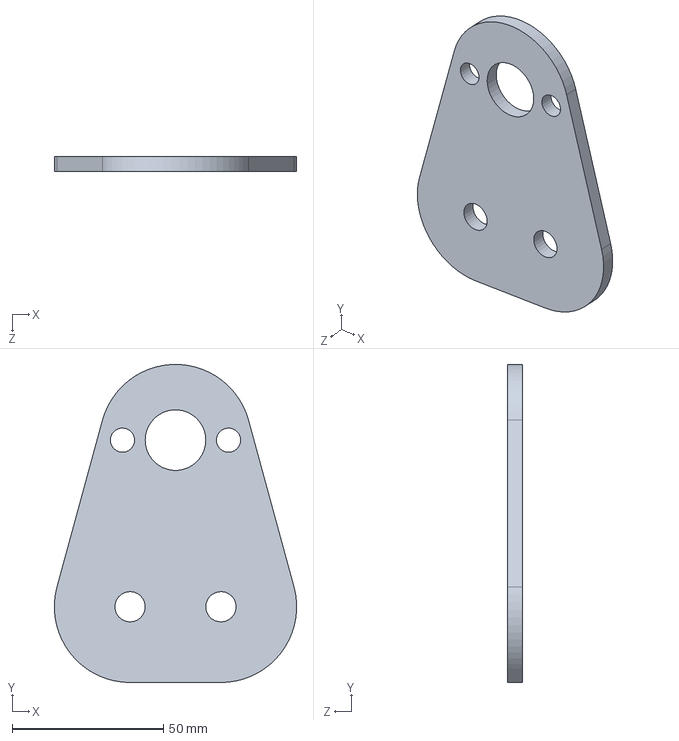
[picture p90: CAD file, 2026-03-10]
Steering/Column_Assembly/Plate.SLDPRT
80.0 x 105.0 x 5.00 mm
