omacharya1710/Model_Rocketry_Project_IIT_Tirupati/Steering/Spindle_Assembly/Bias_Brake/Spindle/Test plate 1.SLDPRT

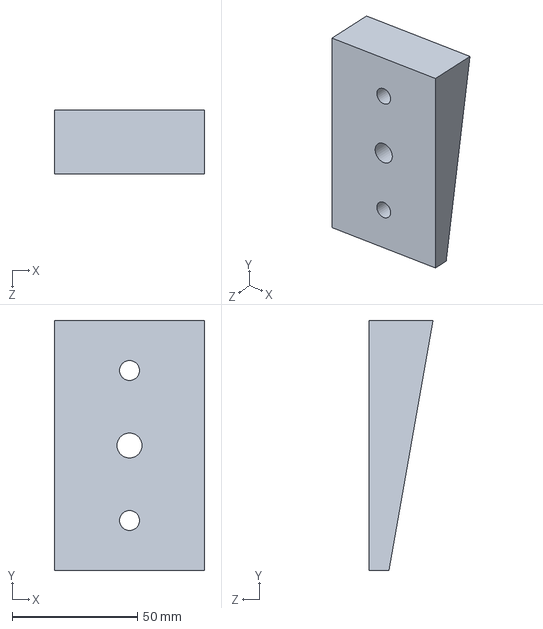
[picture p91: CAD file, 2026-03-10]
Steering/Spindle_Assembly/Bias_Brake/Spindle/Test plate 1.SLDPRT
60.0 x 100.0 x 25.6 mm
