omacharya1710/Model_Rocketry_Project_IIT_Tirupati/Ergonomic/Articulated_Dummy/LowerArm_R.SLDPRT

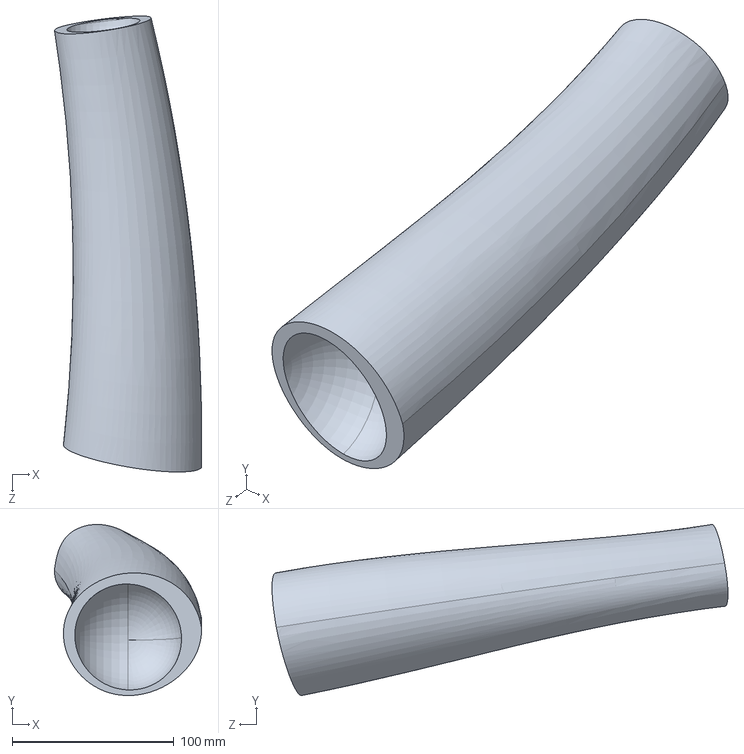
[picture p92: CAD file, 2026-03-10]
Ergonomic/Articulated_Dummy/LowerArm_R.SLDPRT
90.8 x 105.6 x 281.5 mm
