omacharya1710/Model_Rocketry_Project_IIT_Tirupati/Steering/Column_Assembly/20mm shaft collar.SLDPRT

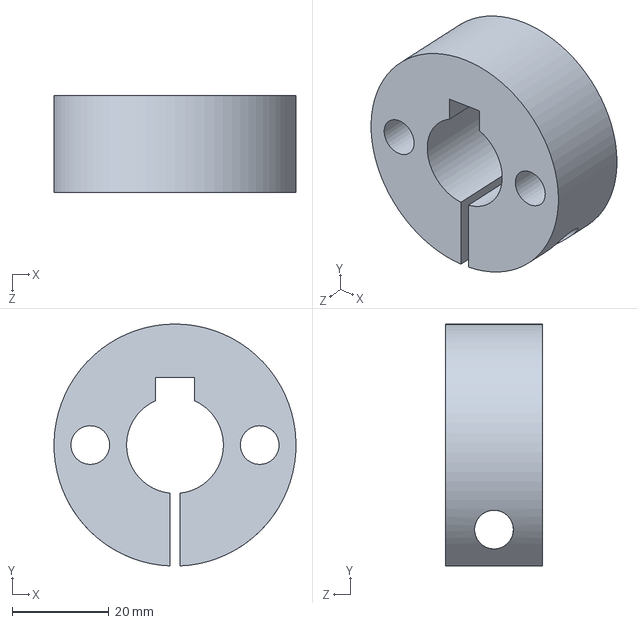
[picture p93: CAD file, 2026-03-10]
Steering/Column_Assembly/20mm shaft collar.SLDPRT
50.0 x 50.0 x 20.0 mm
