omacharya1710/Model_Rocketry_Project_IIT_Tirupati/Ergonomic/Articulated_Dummy/UpperLeg_R.SLDPRT

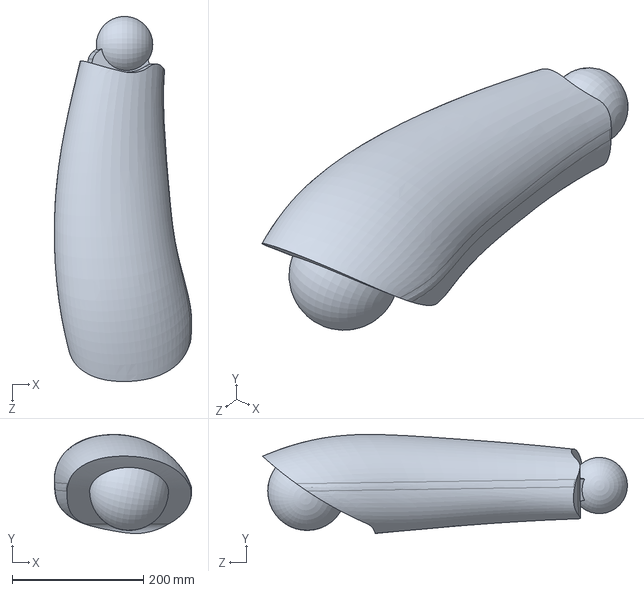
[picture p94: CAD file, 2026-03-10]
Ergonomic/Articulated_Dummy/UpperLeg_R.SLDPRT
209.1 x 150.7 x 555.6 mm
