omacharya1710/Model_Rocketry_Project_IIT_Tirupati/Steering/Column_Assembly/20mm OD Rod Key.SLDPRT

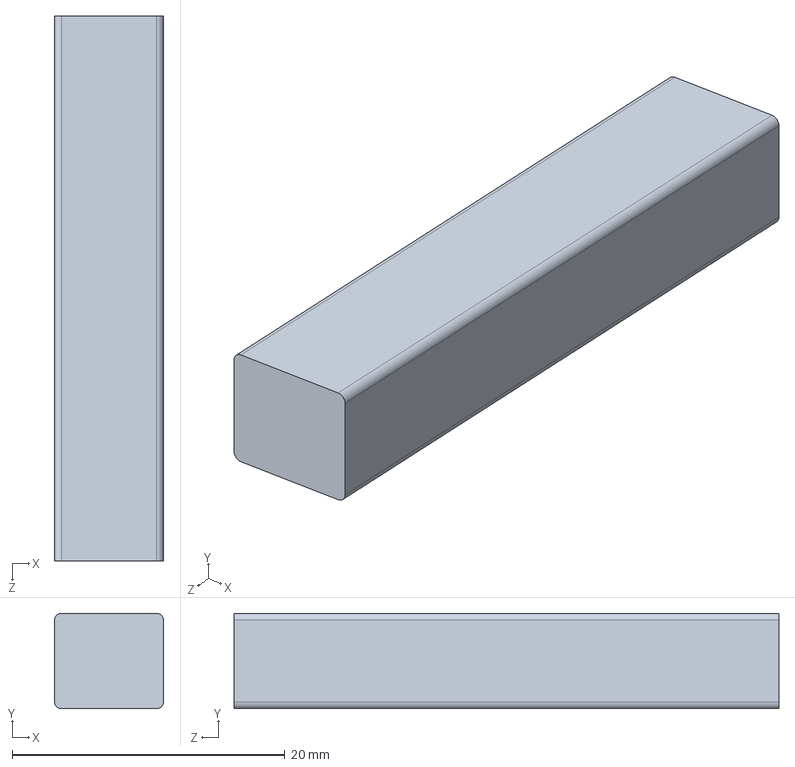
[picture p95: CAD file, 2026-03-10]
Steering/Column_Assembly/20mm OD Rod Key.SLDPRT
8.00 x 7.00 x 40.0 mm
