omacharya1710/Model_Rocketry_Project_IIT_Tirupati/Ergonomic/Articulated_Dummy/Torso.SLDPRT

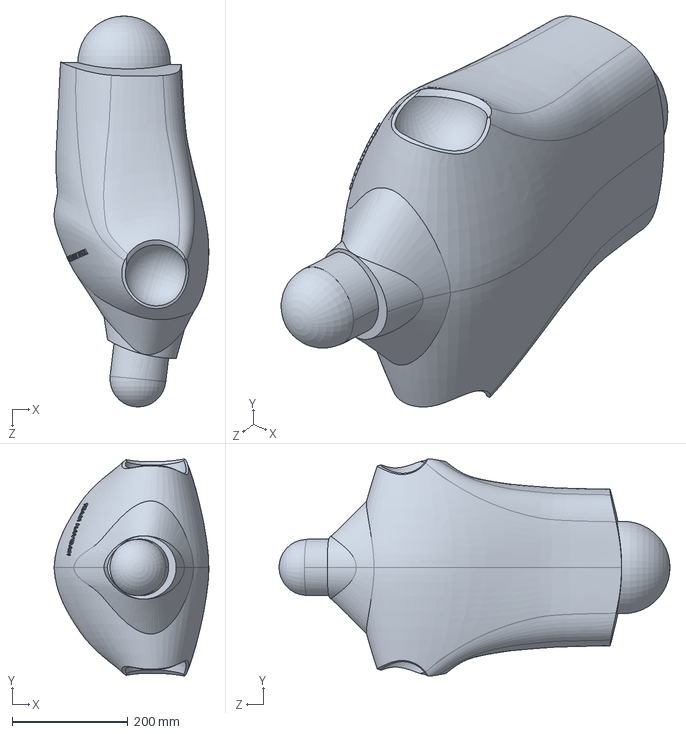
[picture p96: CAD file, 2026-03-10]
Ergonomic/Articulated_Dummy/Torso.SLDPRT
267.7 x 375.5 x 676.7 mm
