omacharya1710/Model_Rocketry_Project_IIT_Tirupati/Steering/Column_Assembly/Column.SLDPRT

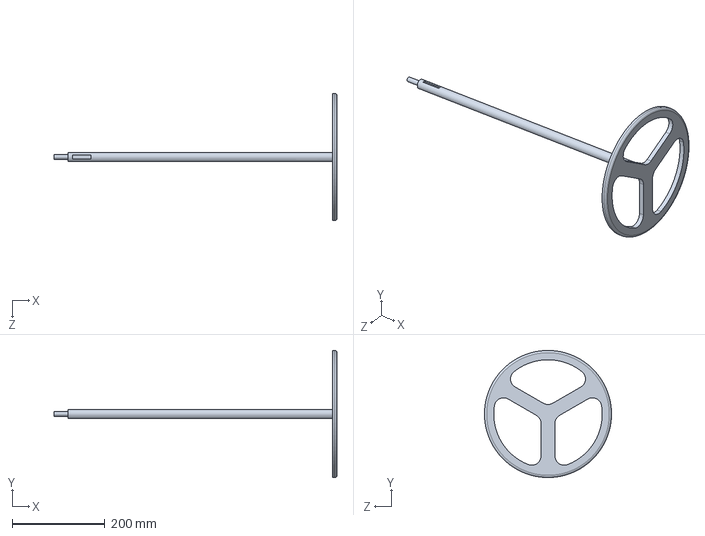
[picture p97: CAD file, 2026-03-10]
Steering/Column_Assembly/Column.SLDPRT
610.0 x 274.0 x 274.0 mm
