omacharya1710/Model_Rocketry_Project_IIT_Tirupati/Steering/Column_Assembly/PHS ROD END BEARING_M10.SLDPRT

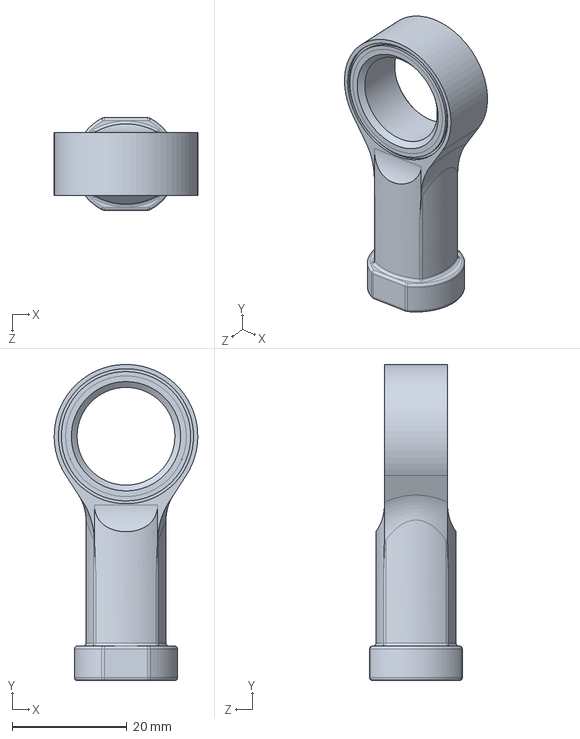
[picture p98: CAD file, 2026-03-10]
Steering/Column_Assembly/PHS ROD END BEARING_M10.SLDPRT
25.0 x 55.0 x 16.1 mm
