omacharya1710/Model_Rocketry_Project_IIT_Tirupati/Ergonomic/Articulated_Dummy/Head.SLDPRT

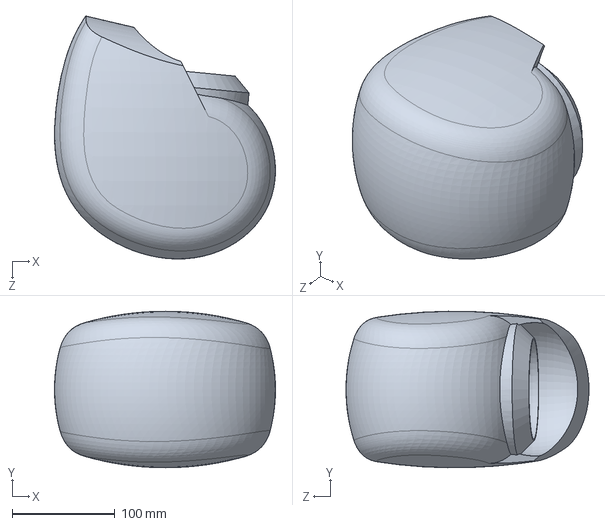
[picture p99: CAD file, 2026-03-10]
Ergonomic/Articulated_Dummy/Head.SLDPRT
215.3 x 152.5 x 236.7 mm
