omacharya1710/Model_Rocketry_Project_IIT_Tirupati/Ergonomic/Articulated_Dummy/Foot_R.SLDPRT

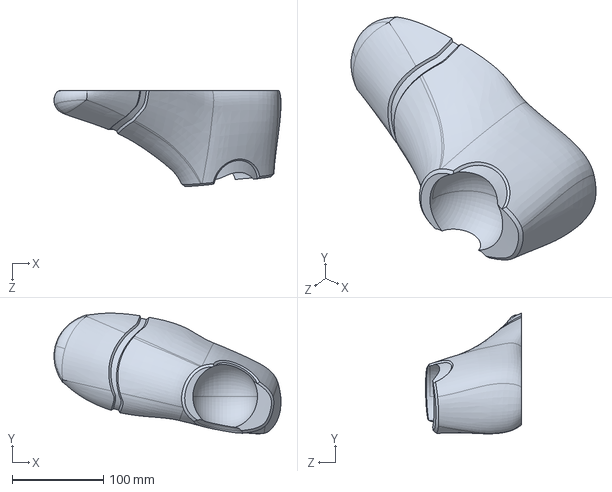
[picture p100: CAD file, 2026-03-10]
Ergonomic/Articulated_Dummy/Foot_R.SLDPRT
248.6 x 132.2 x 105.0 mm
