omacharya1710/Model_Rocketry_Project_IIT_Tirupati/Steering/Column_Assembly/Tie Rod Assembly.SLDASM

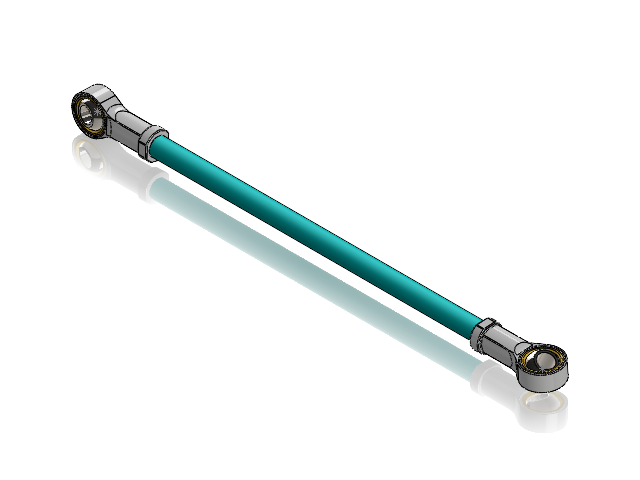
[picture p101: CAD file, 2026-03-10]
Steering/Column_Assembly/Tie Rod Assembly.SLDASM
Tie Rod
PHS ROD END BEARING_M10 x 2
Ball x 2
