omacharya1710/Model_Rocketry_Project_IIT_Tirupati/Tyres/6003_Ball_Bearing/6003 deep groove bearing.SLDASM

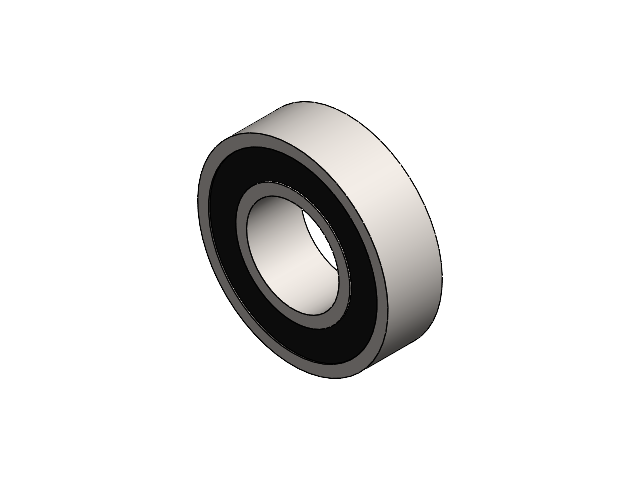
[picture p103: CAD file, 2026-03-10]
Tyres/6003_Ball_Bearing/6003 deep groove bearing.SLDASM
outer shell - 6003
inner shell - 6003
6003 rubber seal x 2
