omacharya1710/Model_Rocketry_Project_IIT_Tirupati/Steering/Column_Assembly/Steerin Column Assembly.SLDASM

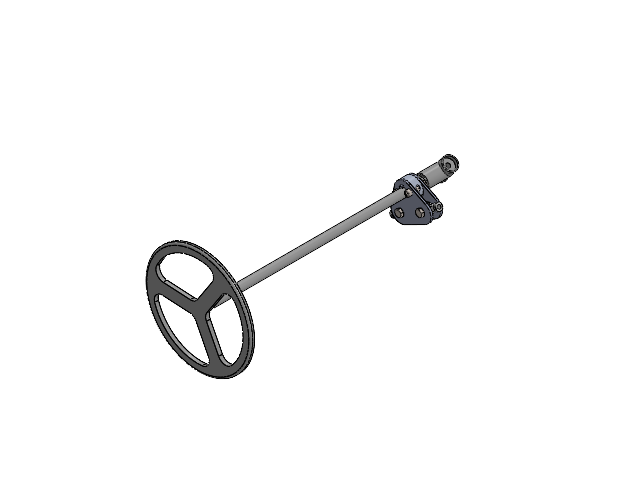
[picture p104: CAD file, 2026-03-10]
Steering/Column_Assembly/Steerin Column Assembly.SLDASM
Column
20mm shaft collar
Plate x 2
socket head cap screw_iso x 3
hex nut style 2 gradeab_iso x 4
Column Adjust
PHS ROD END BEARING_M10 x 2
20mm OD Rod Key
Ball x 2
hex bolt gradec_iso x 2
