omacharya1710/Model_Rocketry_Project_IIT_Tirupati/Steering/Column_Assembly/V2/Pedal_Shifters/Padle Shifters.SLDASM

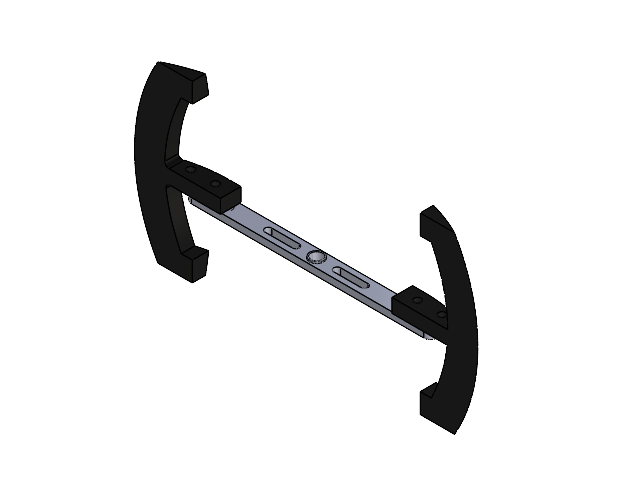
[picture p105: CAD file, 2026-03-10]
Steering/Column_Assembly/V2/Pedal_Shifters/Padle Shifters.SLDASM
Swing Bar
Bushing
Paddle -
Paddle +
