omacharya1710/Model_Rocketry_Project_IIT_Tirupati/Ergonomic/Ergonmic Seat.SLDASM

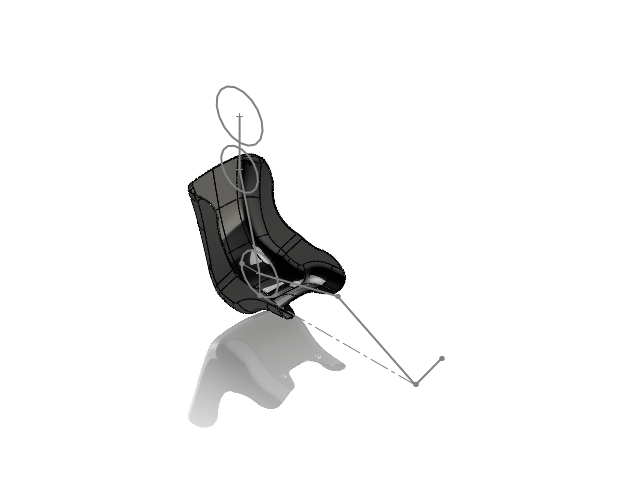
[picture p106: CAD file, 2026-03-10]
Ergonomic/Ergonmic Seat.SLDASM
Ergonmic Template
Seat
