omacharya1710/Model_Rocketry_Project_IIT_Tirupati/Pedal/Master_Cylinder/Montagem Cilindro Mestre Polaris.SLDASM

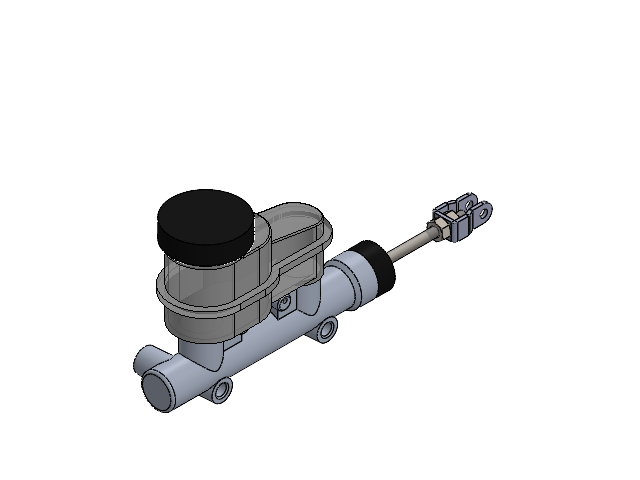
[picture p107: CAD file, 2026-03-10]
Pedal/Master_Cylinder/Montagem Cilindro Mestre Polaris.SLDASM
Corpo Cilindro Mestre Polaris Shopee
Reservatorio Cilindro Mestre Polaris
Tampa Reservatorio Cilindro Mestre Polaris
Borracha proteção haste cilindro mestre
Haste cilindro mestre
Conector pedal cilindro mestre polaris
hex nut style 1_am x 2
