omacharya1710/Model_Rocketry_Project_IIT_Tirupati/Shaft_Hubs/Flange_Bearing/UCF206 Assembly.SLDASM

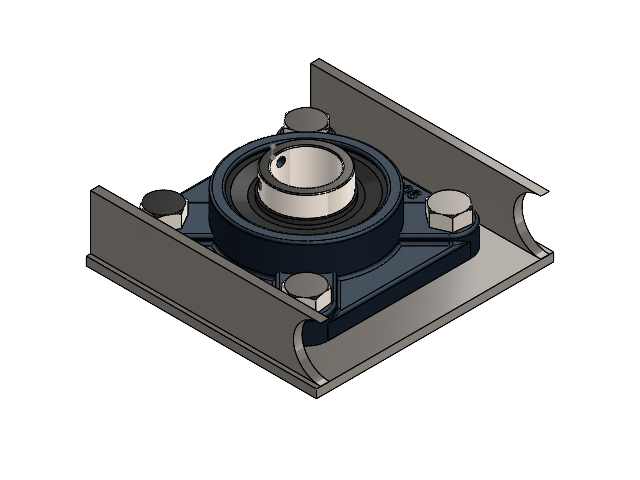
[picture p108: CAD file, 2026-03-10]
Shaft_Hubs/Flange_Bearing/UCF206 Assembly.SLDASM
Mount
UCF206
hex screw gradec_iso x 4
hex nut gradec_iso x 4
Moutn Plate 2 x 2
