omacharya1710/Model_Rocketry_Project_IIT_Tirupati/Steering/Spindle_Assembly/Bearing_type/Front Left Assembly 0deg.SLDASM

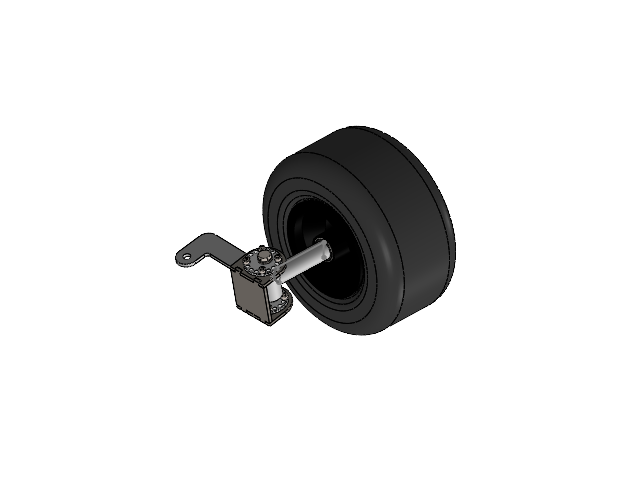
[picture p109: CAD file, 2026-03-10]
Steering/Spindle_Assembly/Bearing_type/Front Left Assembly 0deg.SLDASM
4.5x10-5 Rim
4.5x10-5 Tyre
outer shell - 6003 x 2
inner shell - 6003 x 2
6003 rubber seal x 4
Left spindle
Spindle Part 2
DU 1020 bushing x 2
C_bracket_vertical_v2
C_bracket_horizontal_v2 x 2
eccentric pill v3 x 2
plain_bearingge010el_0_01 x 2
plain_bearingge010el_0_02 x 2
hex bolt gradec_iso
hex nut gradec_iso x 9
socket head cap screw_iso x 12
