omacharya1710/Model_Rocketry_Project_IIT_Tirupati/Steering/Spindle_Assembly/Bias_Brake/Spindle/Left Spindle Assembly.SLDASM

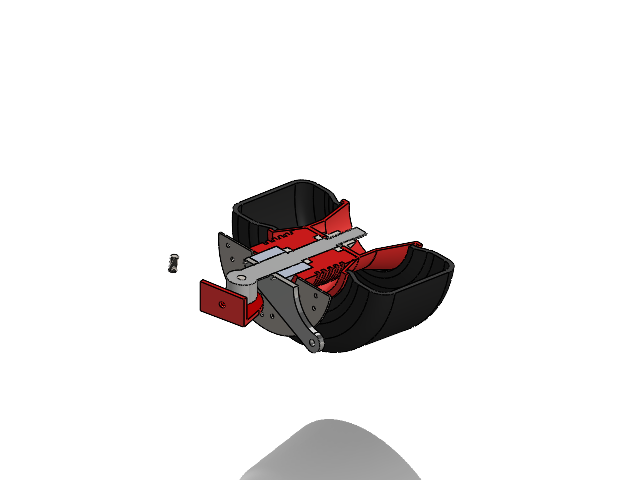
[picture p111: CAD file, 2026-03-10]
Steering/Spindle_Assembly/Bias_Brake/Spindle/Left Spindle Assembly.SLDASM
Spindle Left
6200 RS Spindle Bearing x 2
Washer 8mm x 2
Caliper lock 1
Caliper Mount Plate
socket head cap screw_iso x 7
C braket
4.5x10-5 Tyre
Front Brake Disc
Front Wheel Hub 2
6905RS Wheel Hub Bearing x 2
hex flange nut gradea_iso
Ball
PHS ROD END BEARING_M10
hex bolt gradec_iso x 2
30mm OD x 40mm lenght Key
