omacharya1710/Model_Rocketry_Project_IIT_Tirupati/Steering/Column_Assembly/PHS M10 Rod END.SLDASM

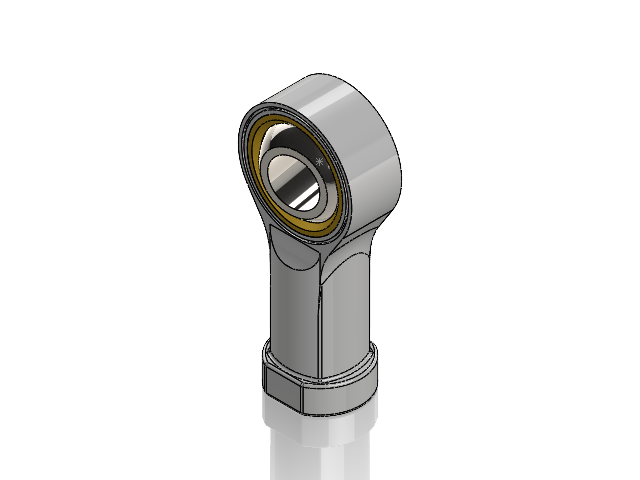
[picture p112: CAD file, 2026-03-10]
Steering/Column_Assembly/PHS M10 Rod END.SLDASM
PHS ROD END BEARING_M10
Ball
