omacharya1710/Model_Rocketry_Project_IIT_Tirupati/(list of files, cad)

Other CAD files:
Ergonomic/Articulated_Dummy/Hand_L.SLDASM
External_Components/MirrorLift Point m8.SLDPRT
Shaft_Hubs/Sprocket_Hub/Sprocket Hub.SLDPRT
Ergonomic/Ergonmic Template.SLDPRT
Engine/Heat_Shield/Heat Shield Lift Point.SLDPRT
Steering/Spindle_Assembly/Bearing_type/Left spindle.SLDPRT
Engine/Heat_Shield/Engine Heat Shield Bubble Wrap.SLDPRT
Ergonomic/Articulated_Dummy/UpperArm_R.SLDPRT
Ergonomic/Articulated_Dummy/LowerLeg_L.SLDPRT
Ergonomic/Articulated_Dummy/LowerArm_L.SLDPRT
Ergonomic/Articulated_Dummy/UpperLeg_L.SLDPRT
Ergonomic/Articulated_Dummy/Fingers_R.SLDPRT
Ergonomic/Articulated_Dummy/Hand_L.SLDPRT
Ergonomic/Articulated_Dummy/Hand_R.SLDPRT
Steering/Column_Assembly/V2/Pedal_Shifters/Paddle +.STL
Steering/Column_Assembly/V2/Pedal_Shifters/Paddle -.SLDPRT
Steering/Spindle_Assembly/Bias_Brake/Spindle/C braket.SLDDRW
Steering/Spindle_Assembly/Bias_Brake/Spindle/Washer 8mm.SLDPRT
