omacharya1710/Model_Rocketry_Project_IIT_Tirupati/Reports/Intro_page.pdf

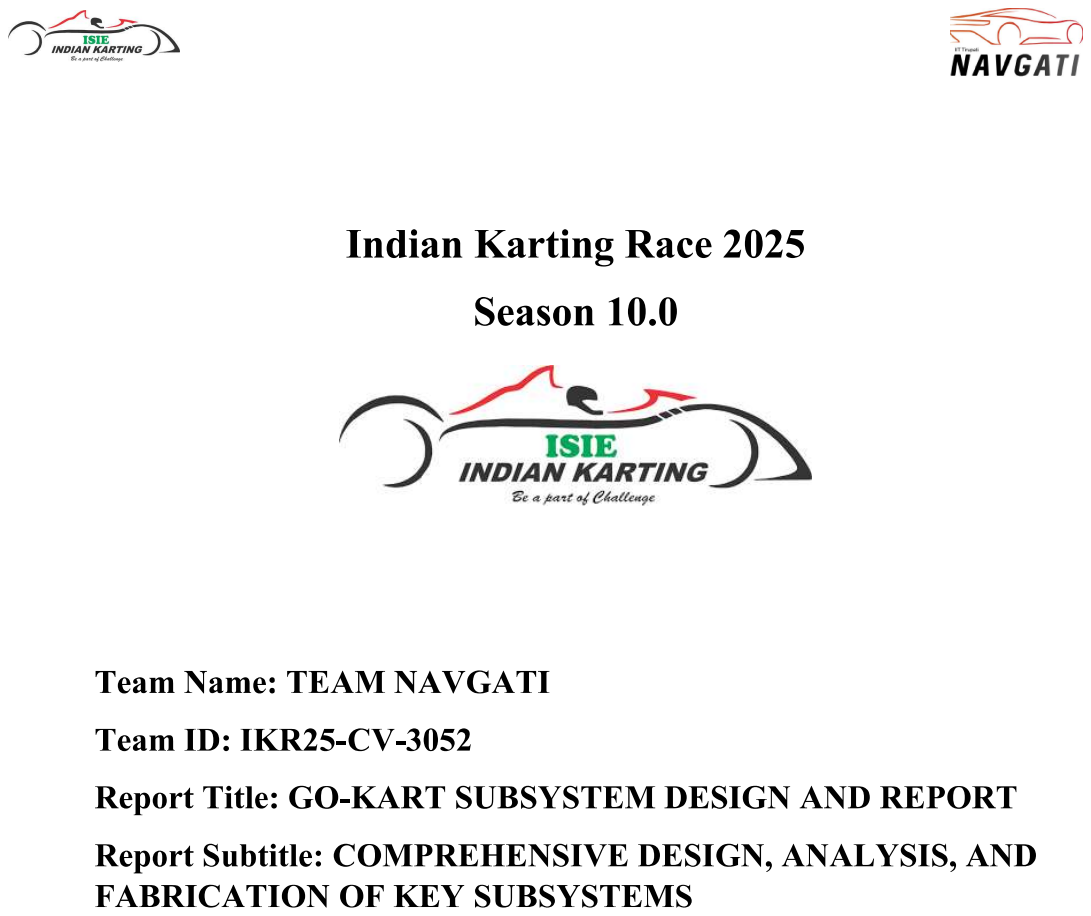
[picture p114: page 1]
