omacharya1710/Model_Rocketry_Project_IIT_Tirupati/Steering/Spindle_Assembly/Bias_Brake/Spindle/C braket.pdf

# C braket (Al 6061 T6) 2 Qunatity 100.00

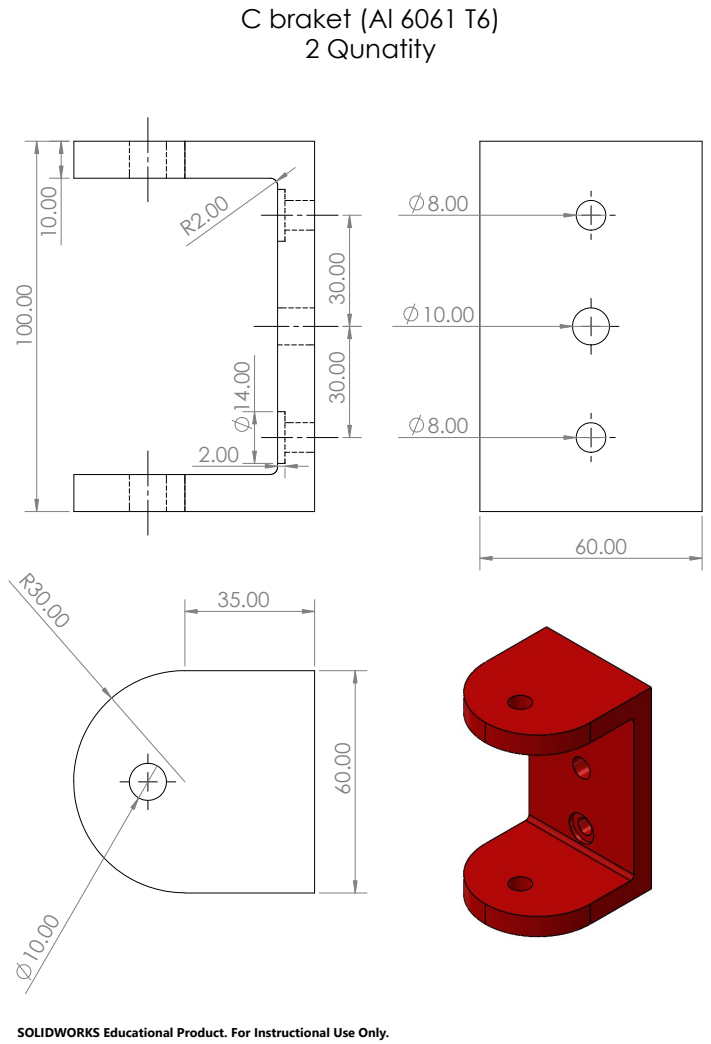
[picture p113: page 1]

SOLIDWORKS Educational Product. For Instructional Use Only.
